evenator/masters/README

The contents of this repository are the intellectual property of Edward Venator
and Case Western Reserve University, except where prohibited by preexisting
licenses. You are not permitted to copy, publish, mirror, or create derivatives
of this work.
