evenator/masters/Robot hardware.docx

1. Power Rails
  a. 24V batteries
  b. 12V DC
  c. 5V DC
  d. 220V AC
  e. PC power supply
2. Sensors
  a. Arm positions
  b. Wheel encoders (2 per)
  c. Kinect
  d. Sonars for reflexive halt?
  e. Sick LIDAR (?)
  f. ~~Hokuyo LIDAR (?)~~
  g. Gyro
  h. ~~Neato~~ ~~laser~~
  i. ~~GPS~~
3. Actuators
  a. Two wheels
  b. 6 DOF arm
  c. Gripper
4. Processing
  a. IRC5
  b. cRIO
  c. PC
5. COM/control
  a. E-stop
  b. Wifi bridge
  c. 360 Controller
  d. Warning Beacon Light
