evenator/masters/figures/robot overview.pdf

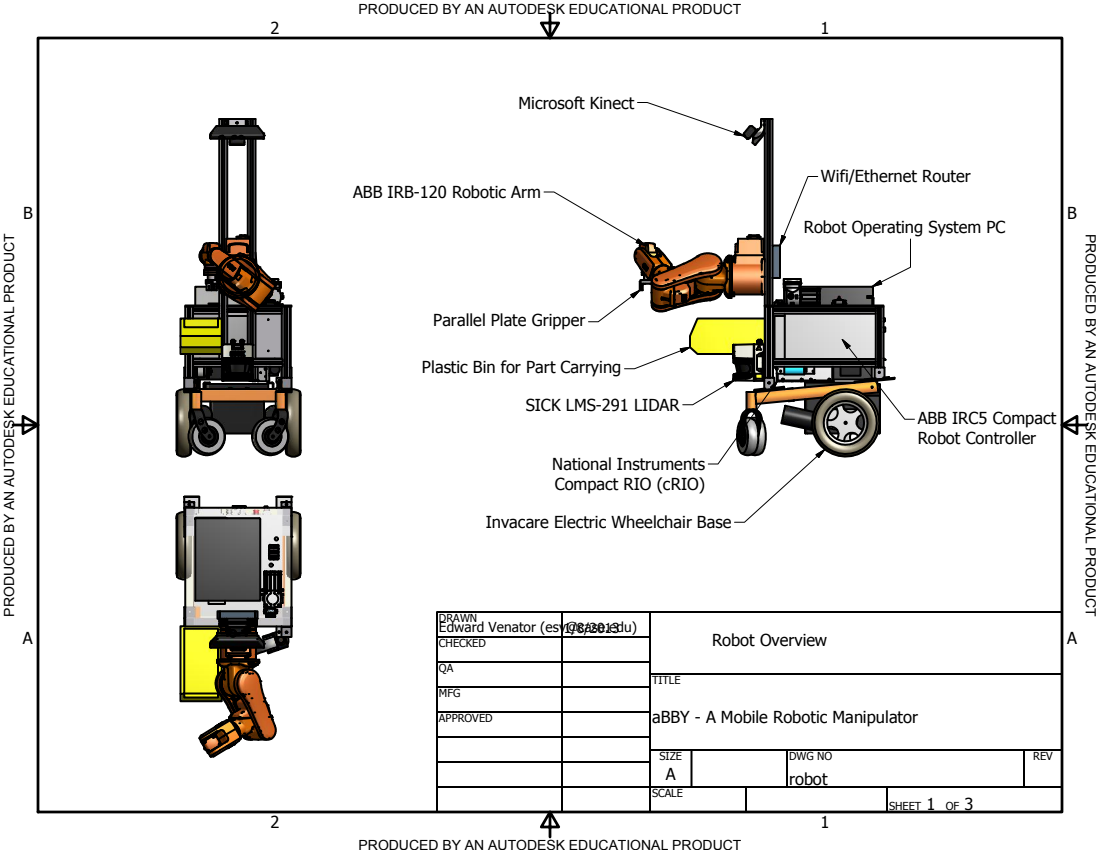
[picture p43: page 1]
TIO; ile; ula; mSI; Ele; elc; Pla; olle; allel Pla

PRODUCED BY AN AUTODESK EDUCATIONAL PRODUCT

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
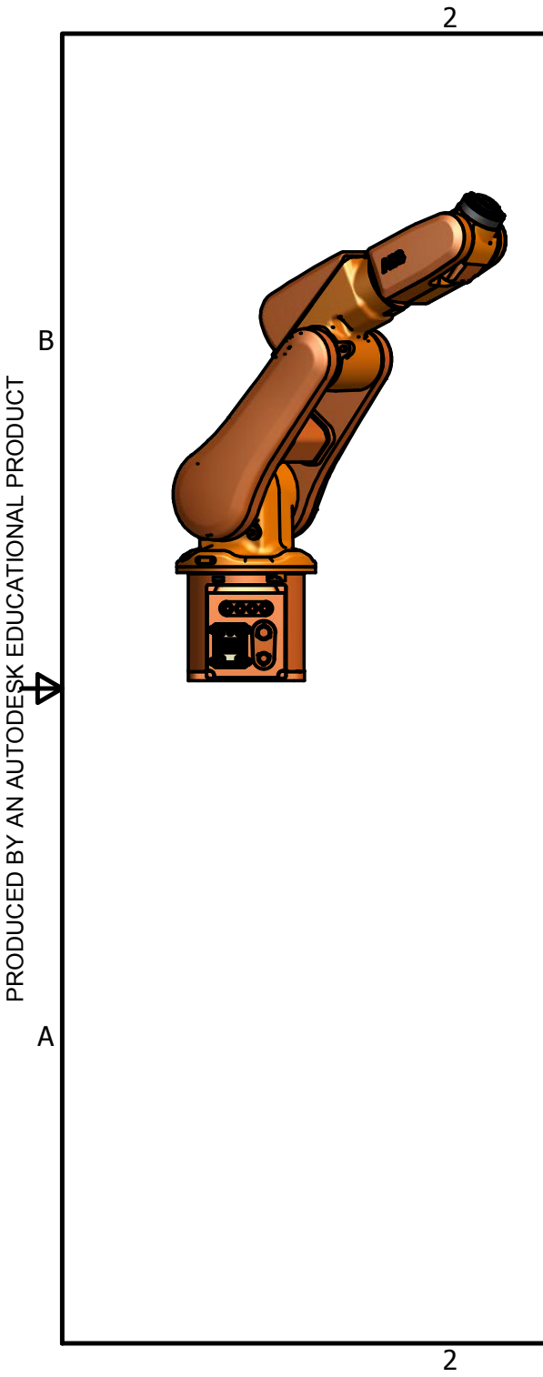
[picture p44: figure]

PRODUCED BY AN AUTODESK EDUCATIONAL PRODUCT

PRODUCED BY AN AUTODESK EDUCATIONAL PRODUCT

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
B IR

B

1

2

0 in

d

u

s

t

rial r

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
e IRB-120 is a six-axisrobotic armwith a spherical wrist. It has a tool flange that allowsfor the mounting of end effectors as well as pneumatic and elec

t

ric

al connections near the tool flange to connectsensors and actuatorsto the arm. Th
e IRB-120 is ABB'ssmallest robotic arm, with a 580 mmreach and a payload capacity of 3 kg. The armitself weighs 25 kg andmust be mounted to the extreme front of the robot, whichmeansits weight exerts a large moment on the robot. This was a serious consideration in the placement of the robot's center of mass. It can be mounted at any angle, and on thisrobot is mounted 90 (with the base mounted to a verticalsurface). The decision to mountthe armvertically on the front of the robot wasso that the majority of the arm's work envelope would be outside of the volume of the robot. This maximizesthe functional work envelope of the armand minimizesthe possibility of the armcolliding with other parts of the robot. The IRB-120'sjoints are powered by non-back-drivable AC electric servos, with positio

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
e IR

B

1

2

0 is

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
sitio

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
sitio

n is

c

o

n

t

r

olle

d

b

y

a

n

A

B

B IR

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
olle

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
S In

d

u

s

t

rial in

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
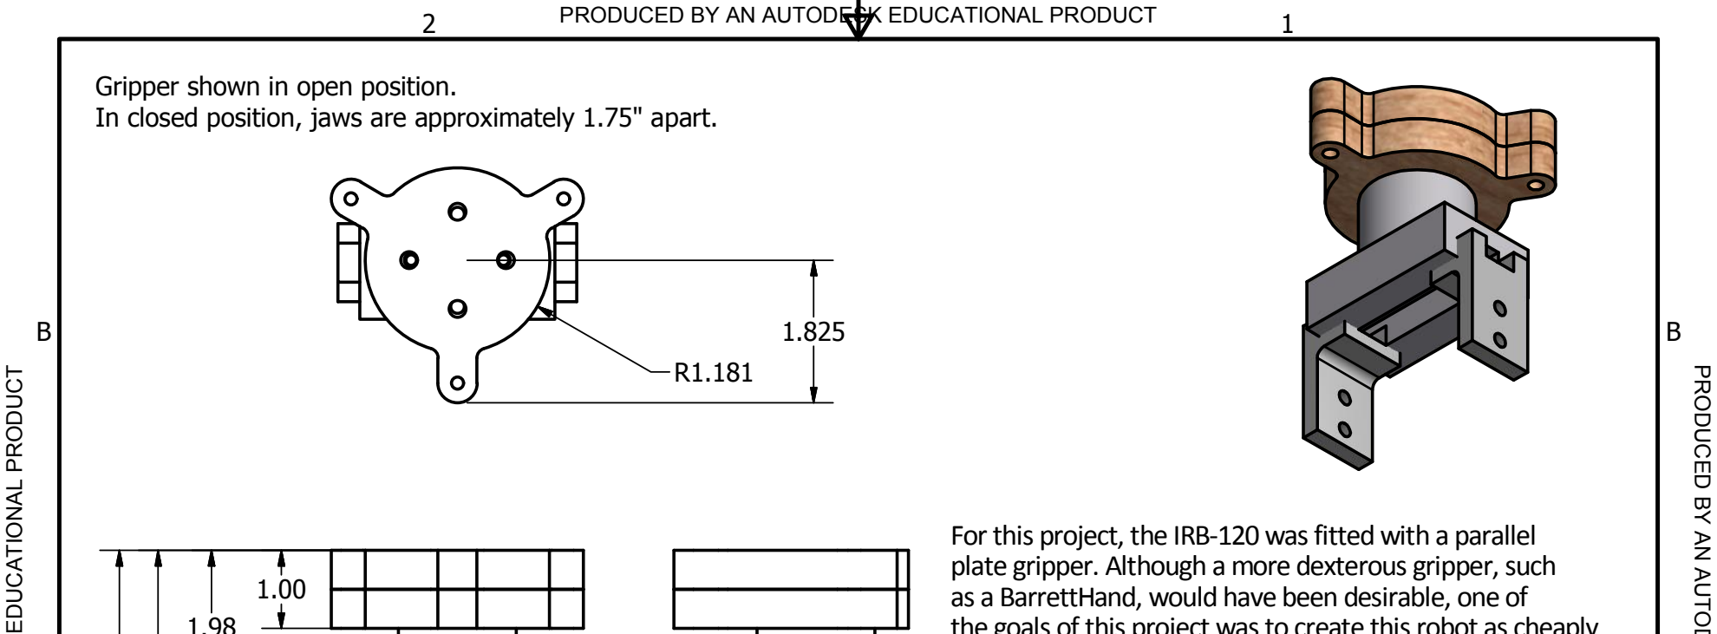
[picture p45: figure]
TIO; Gripper shown in open position.
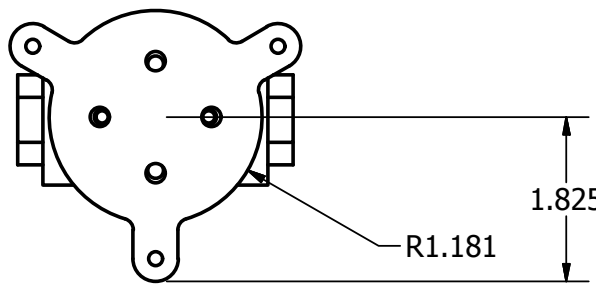
[picture p46: figure]
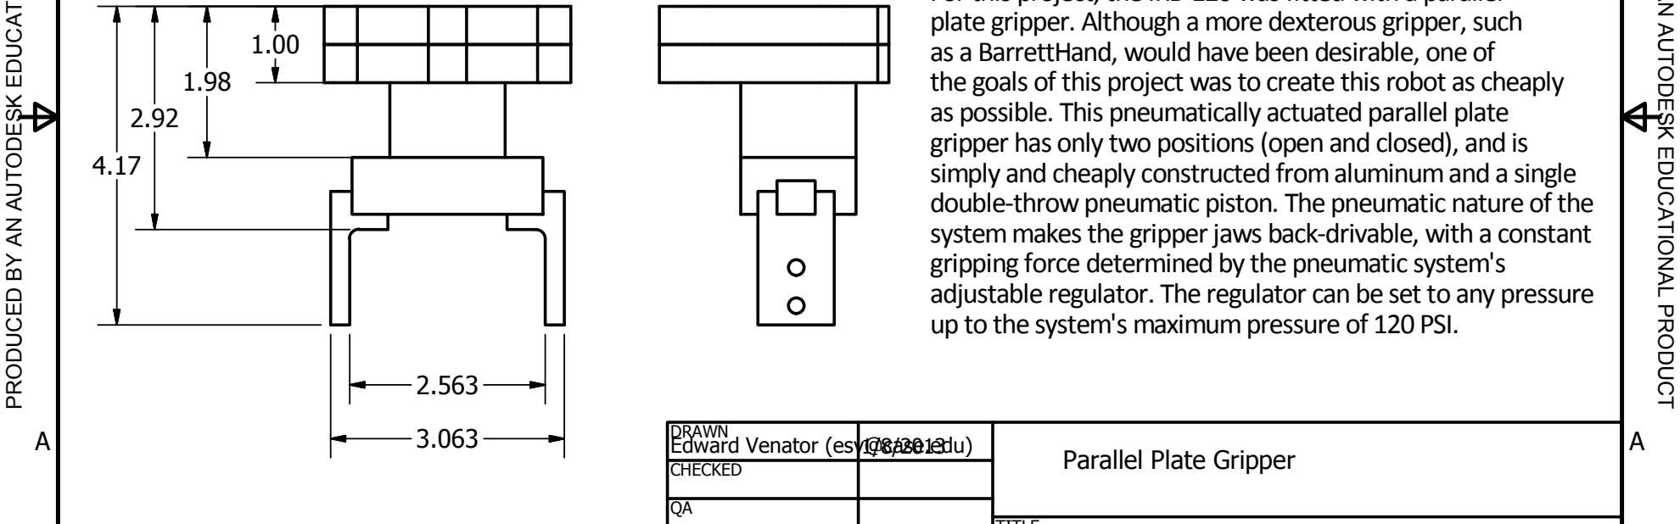
[picture p47: figure]
D E S K E D U C A TIO; DRAWN Edward Venator (esv@case.edu); CHECKED; Parallel Plate Gripper

PRODUCED BY AN AUTODESK EDUCATIONAL PRODUCT

PRODUCED BY AN AUTODESK EDUCATIONAL PRODUCT

MFG

APPROVED

TITLE

aBBY - A Mobile Robotic Manipulator

SIZE

SCALE

DWG NO
robot

REV

SHEET 3 OF 3

For this project, the IRB-120 wasfitted with a parallel plate gripper. Although a more dexterous gripper,such as a BarrettHand, would have been desirable, one of
the goals of this project wasto create thisrobot as cheaply as possible. This pneumatically actuated parallel plate gripper has only two positions(open and closed), and is simply and cheaply constructed fromaluminumand a single double-throwpneumatic piston. The pneumatic nature of the systemmakesthe gripperjaws back-drivable, with a constant gripping force determined by the pneumatic system's adjustable regulator. The regulator can be set to any pressure up to the system's maximumpressure of 120 PSI.

Dimensions in inches

In closed position, jaws are approximately 1.75" apart.
