evenator/masters/thesis/figures/abby-diagram-eps-converted-to.pdf

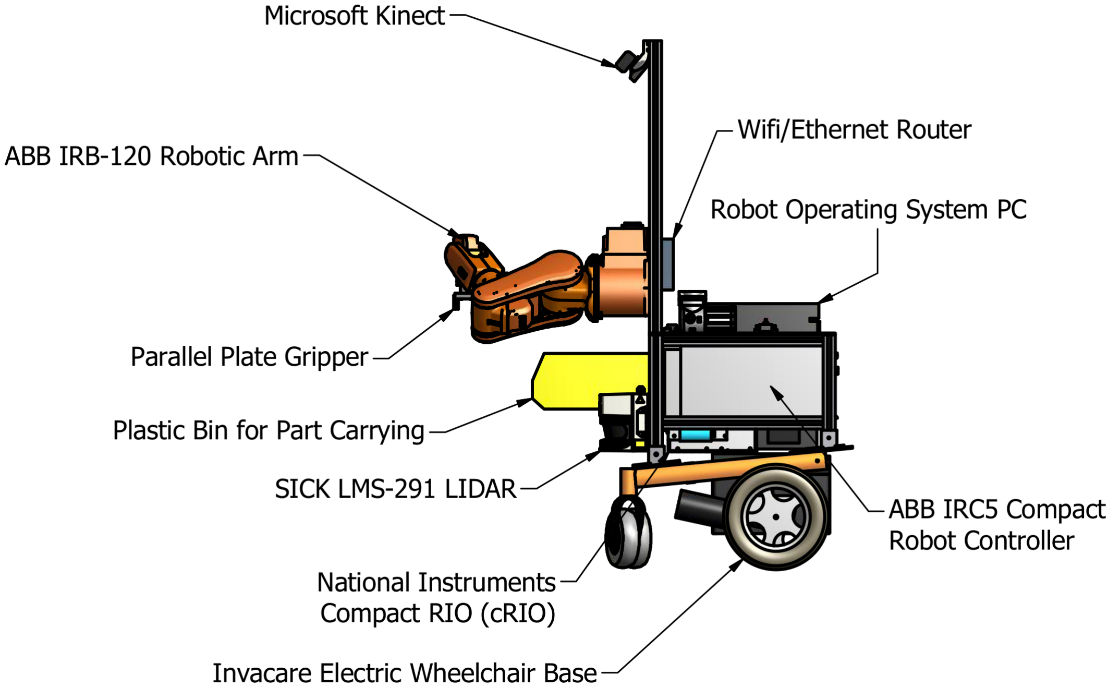
[picture p54: page 1]
