evenator/masters/Electronics/cRIO Breakout/breakout.png

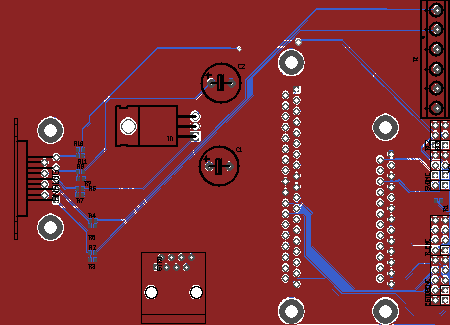
Electronics/cRIO Breakout/breakout.png
