evenator/masters/figures/13.8v Rail Dropout On Compressor Turn-on (Inductive Filter).JPG

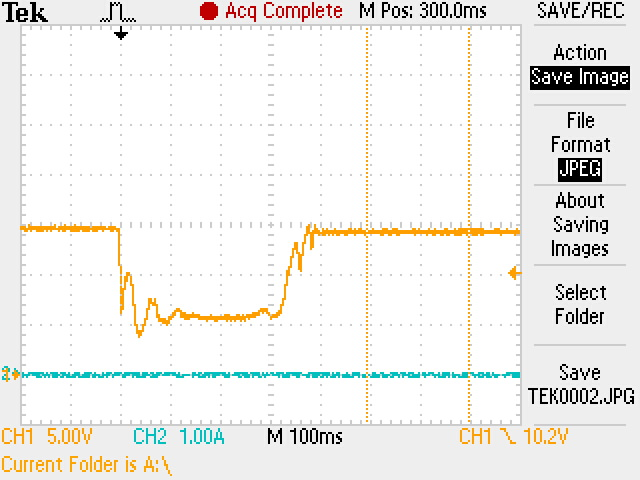
figures/13.8v Rail Dropout On Compressor Turn-on (Inductive Filter).JPG
