evenator/masters/figures/2012-12-06-175029_webcam.jpg

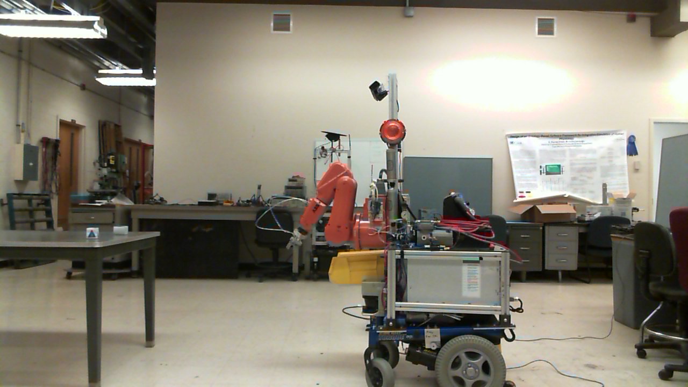
figures/2012-12-06-175029_webcam.jpg
