evenator/masters/figures/2012-12-06-175038_rviz.png

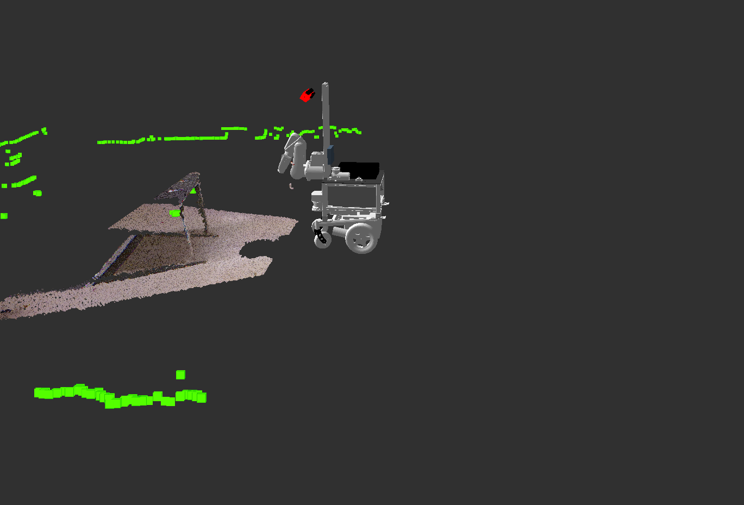
figures/2012-12-06-175038_rviz.png
