evenator/masters/figures/abby.png

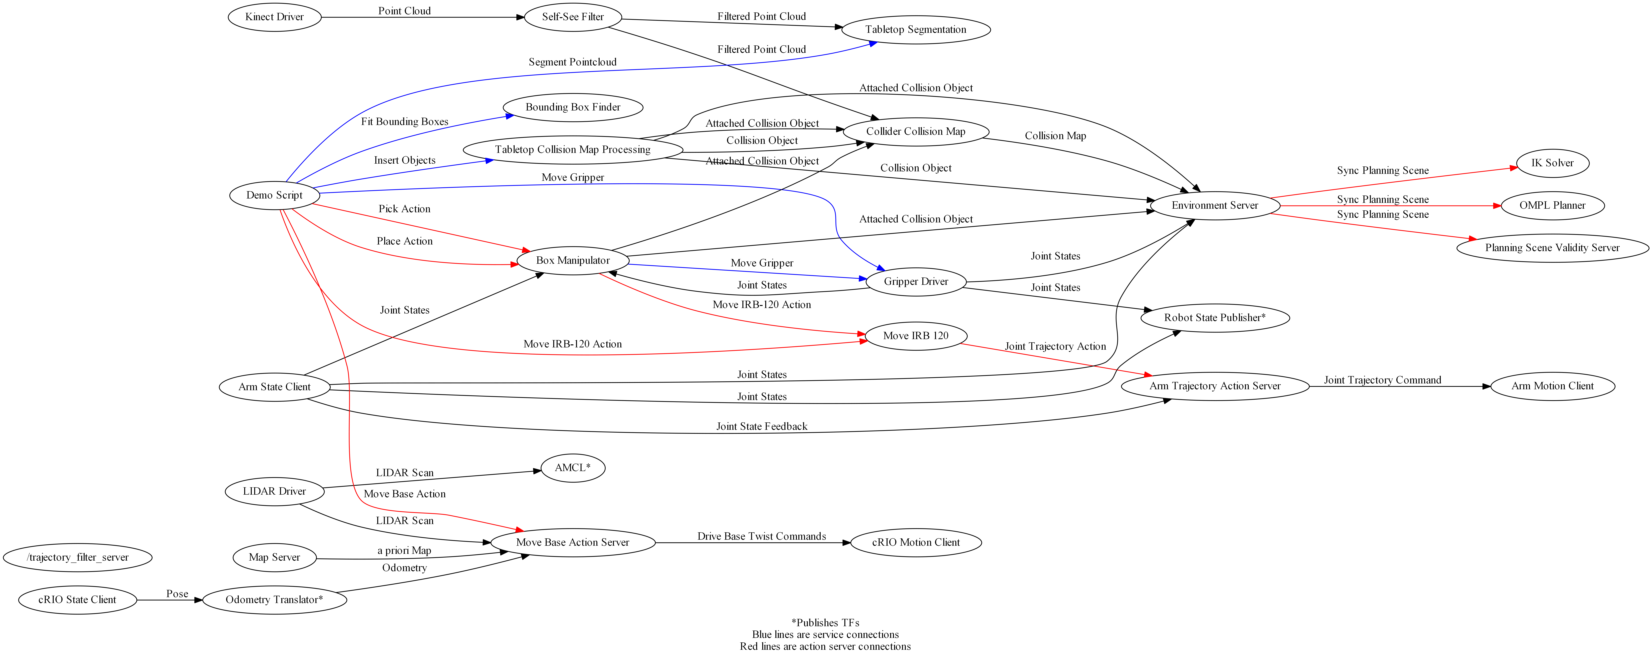
figures/abby.png
