evenator/masters/figures/data_connections.png

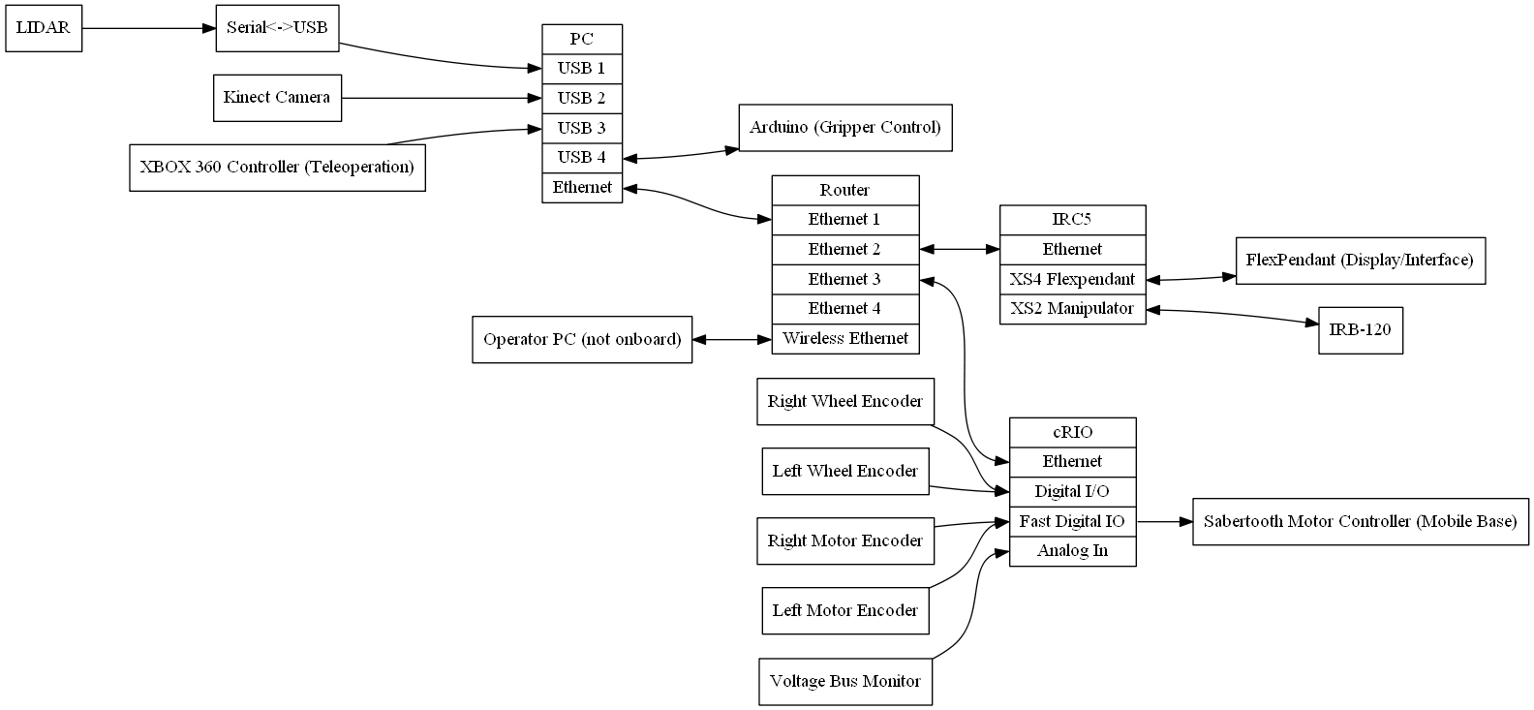
figures/data_connections.png
