evenator/masters/figures/data_connections_simple.png

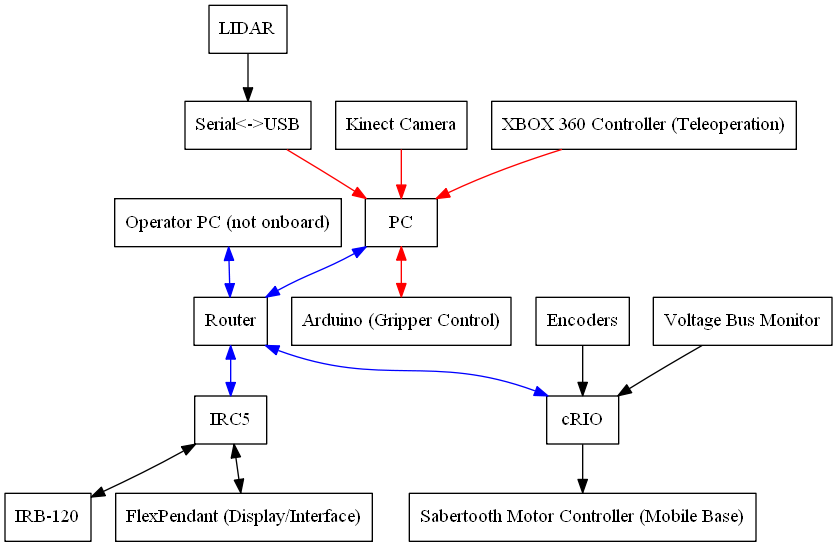
figures/data_connections_simple.png
