evenator/masters/figures/demo task map.png

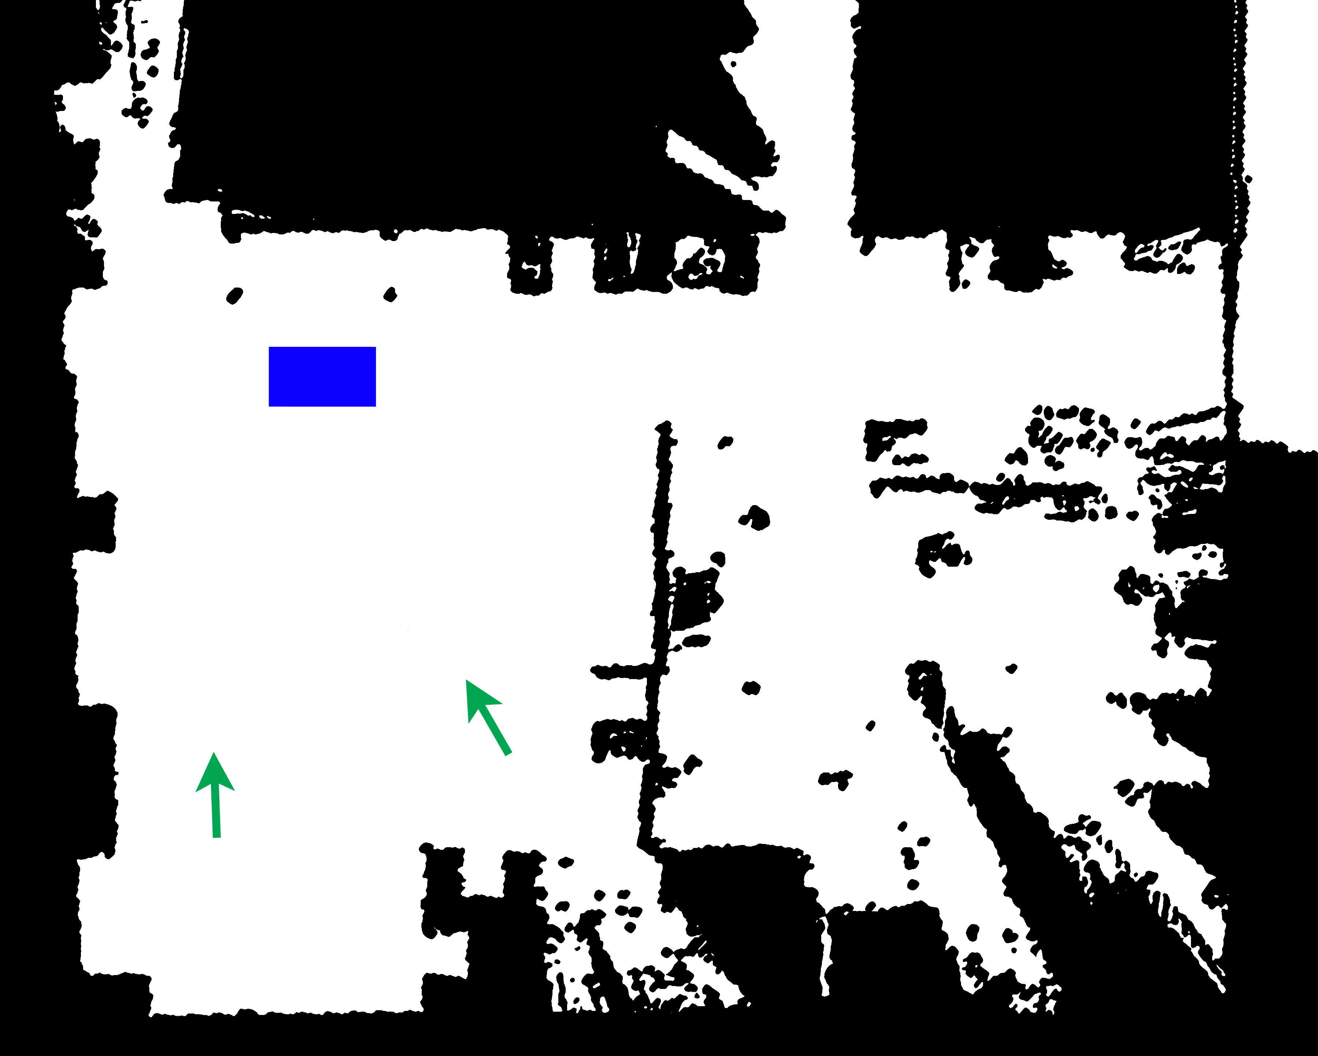
figures/demo task map.png
