evenator/masters/figures/goals slide pic.jpg

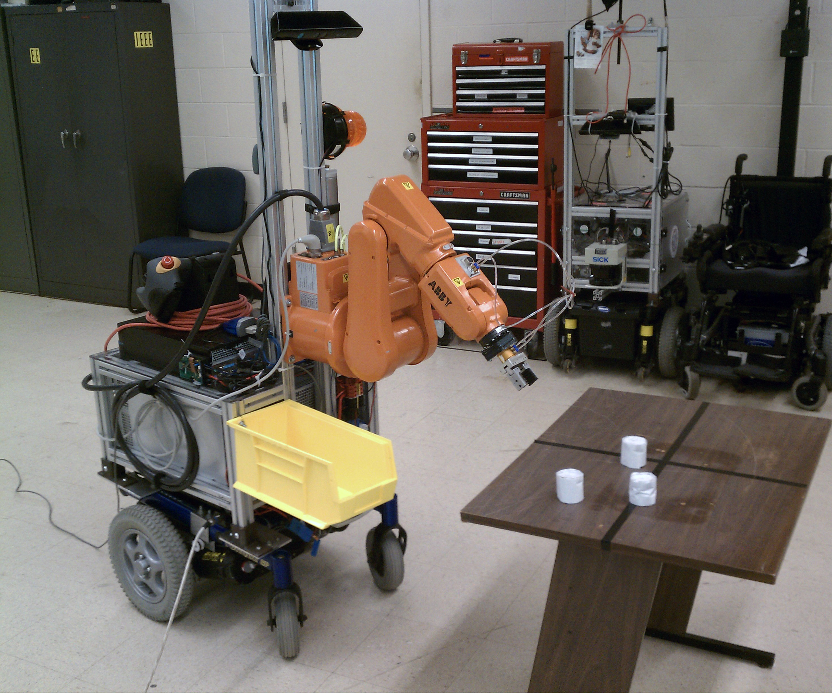
figures/goals slide pic.jpg
