evenator/masters/figures/IMG_20121110_164241.jpg

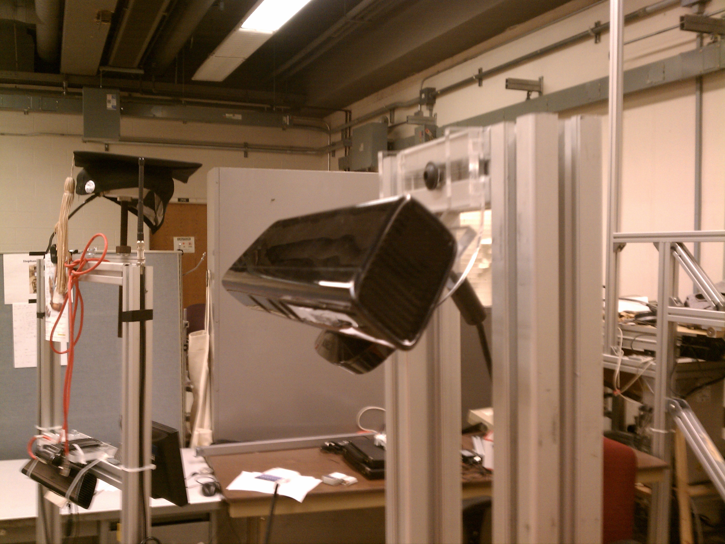
figures/IMG_20121110_164241.jpg
