evenator/masters/figures/IMG_20121110_164247.jpg

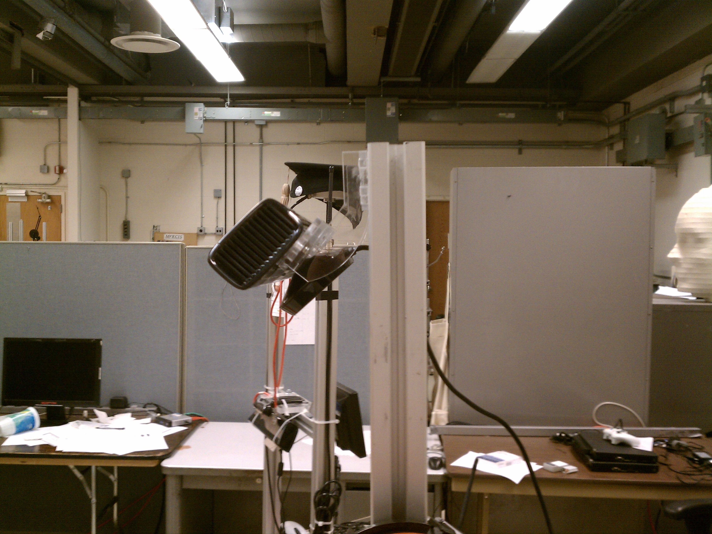
figures/IMG_20121110_164247.jpg
