evenator/masters/figures/IMG_20121110_164253.jpg

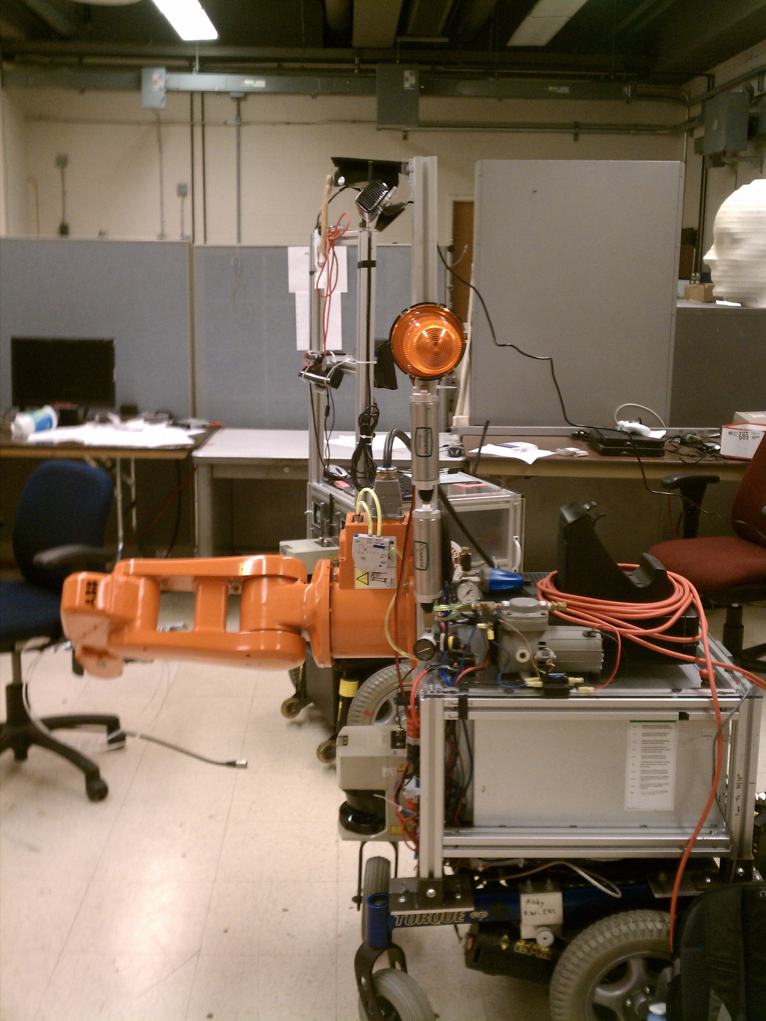
figures/IMG_20121110_164253.jpg
