evenator/masters/figures/IMG_20121110_164259.jpg

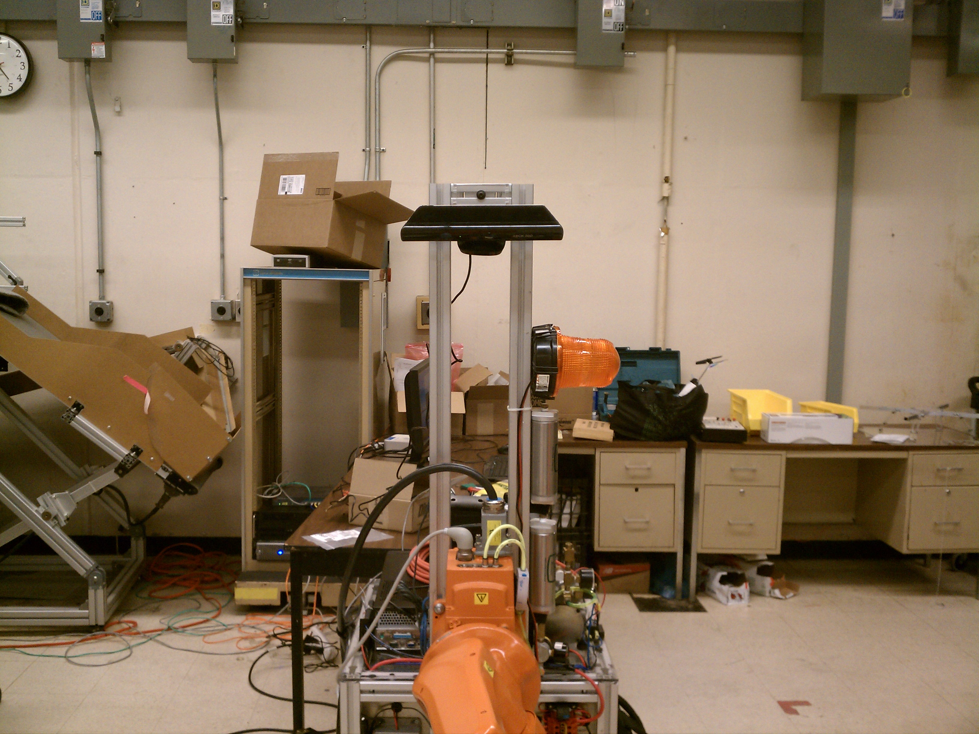
figures/IMG_20121110_164259.jpg
