evenator/masters/figures/IMG_20121119_132048.jpg

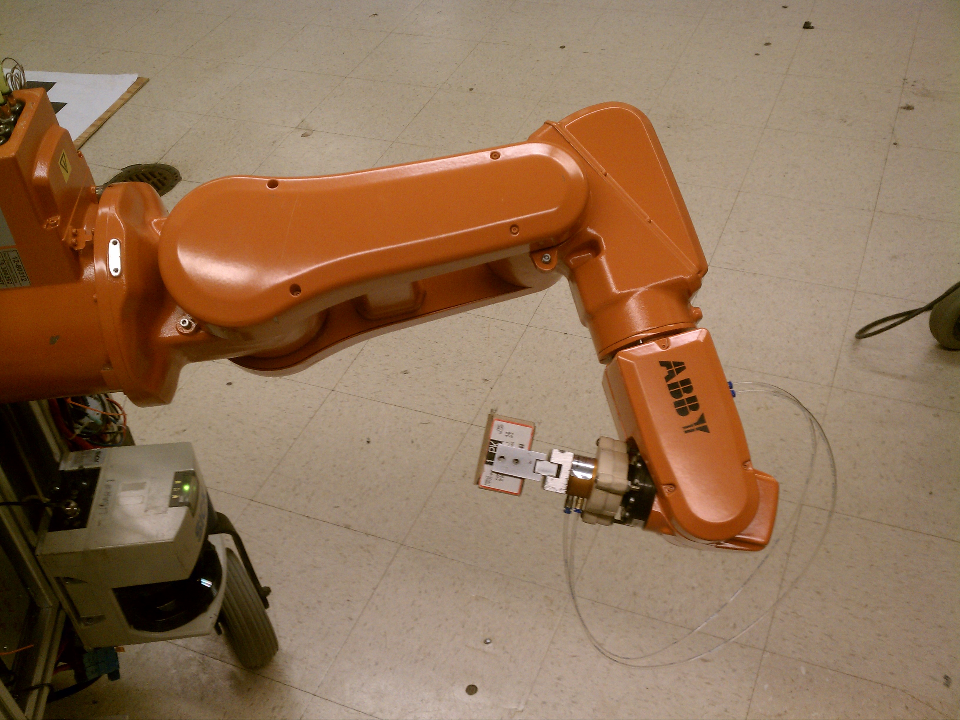
figures/IMG_20121119_132048.jpg
