evenator/masters/figures/IMG_20121119_132052.jpg

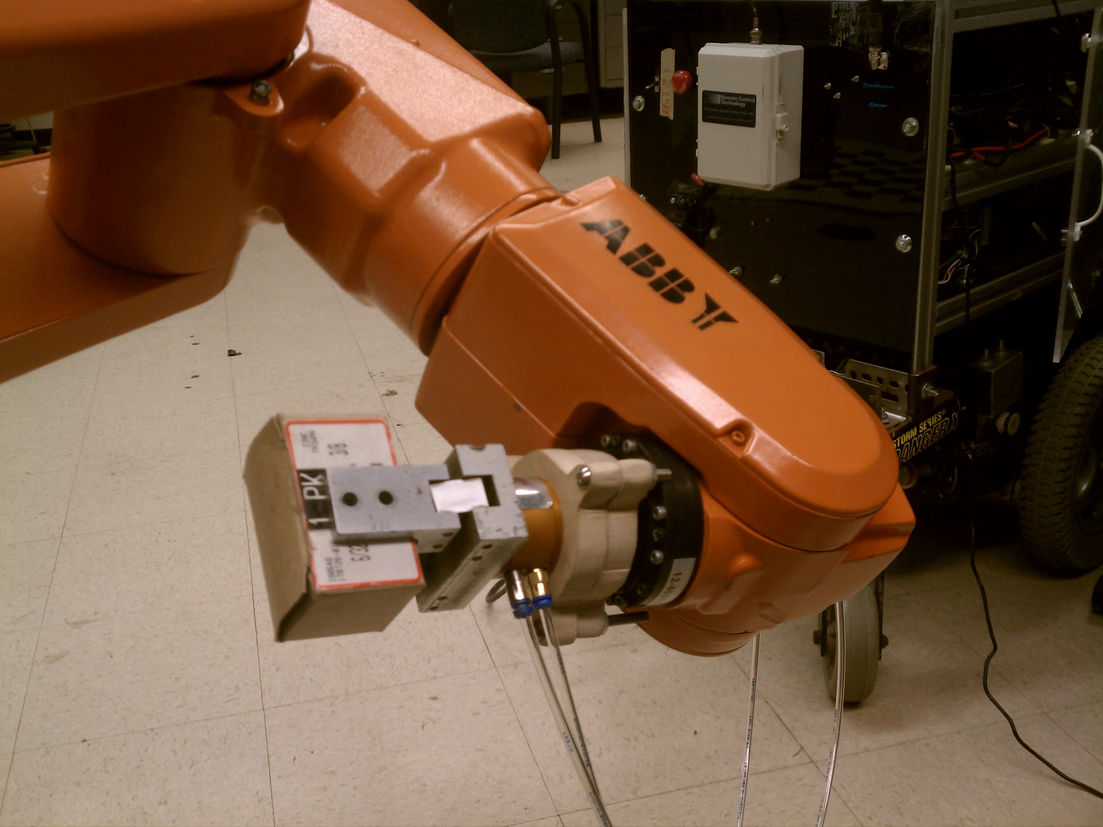
figures/IMG_20121119_132052.jpg
