evenator/masters/figures/IMG_20121119_132947.jpg

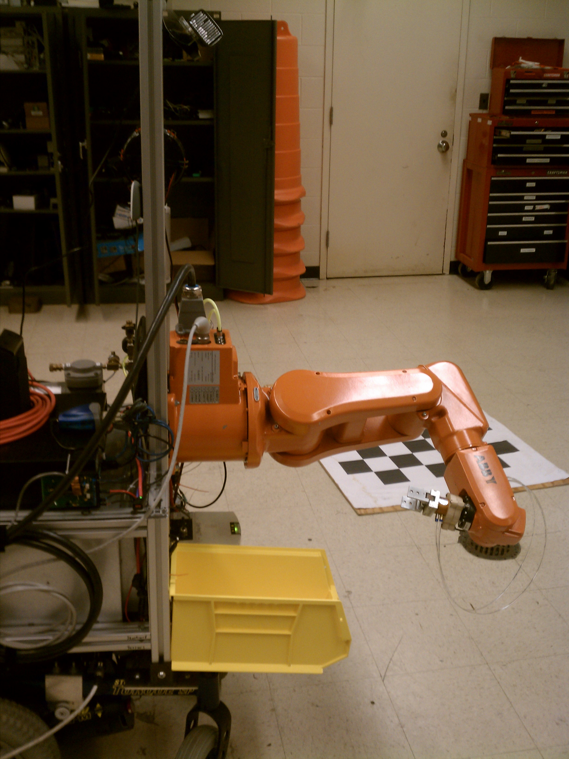
figures/IMG_20121119_132947.jpg
