evenator/masters/figures/IMG_20121119_132950.jpg

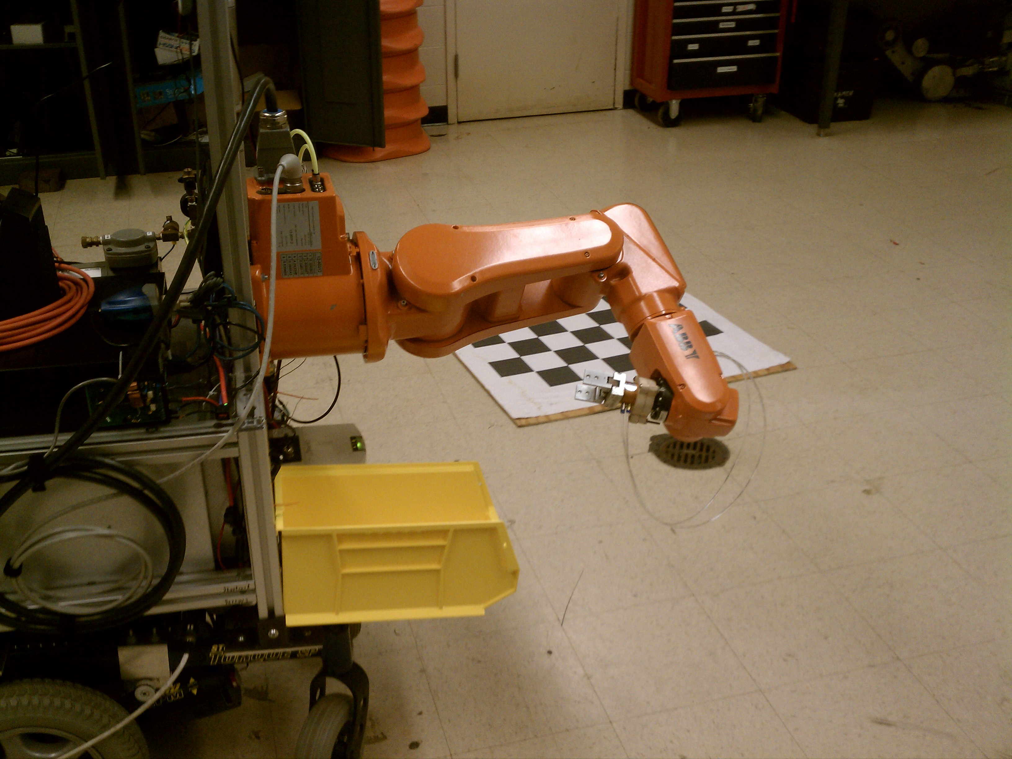
figures/IMG_20121119_132950.jpg
