evenator/masters/figures/IMG_20121206_152852.jpg

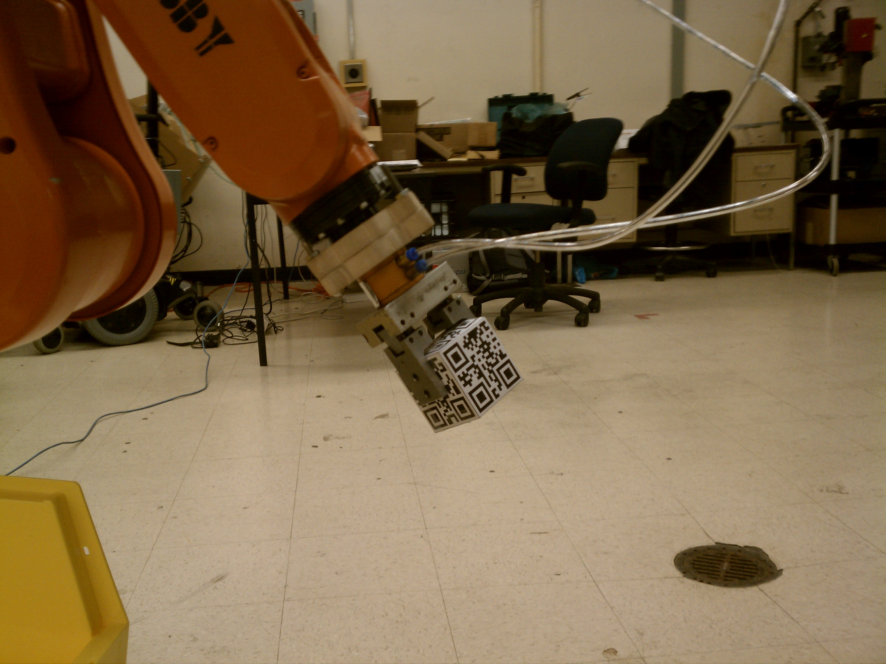
figures/IMG_20121206_152852.jpg
