evenator/masters/figures/IMG_20121206_152901.jpg

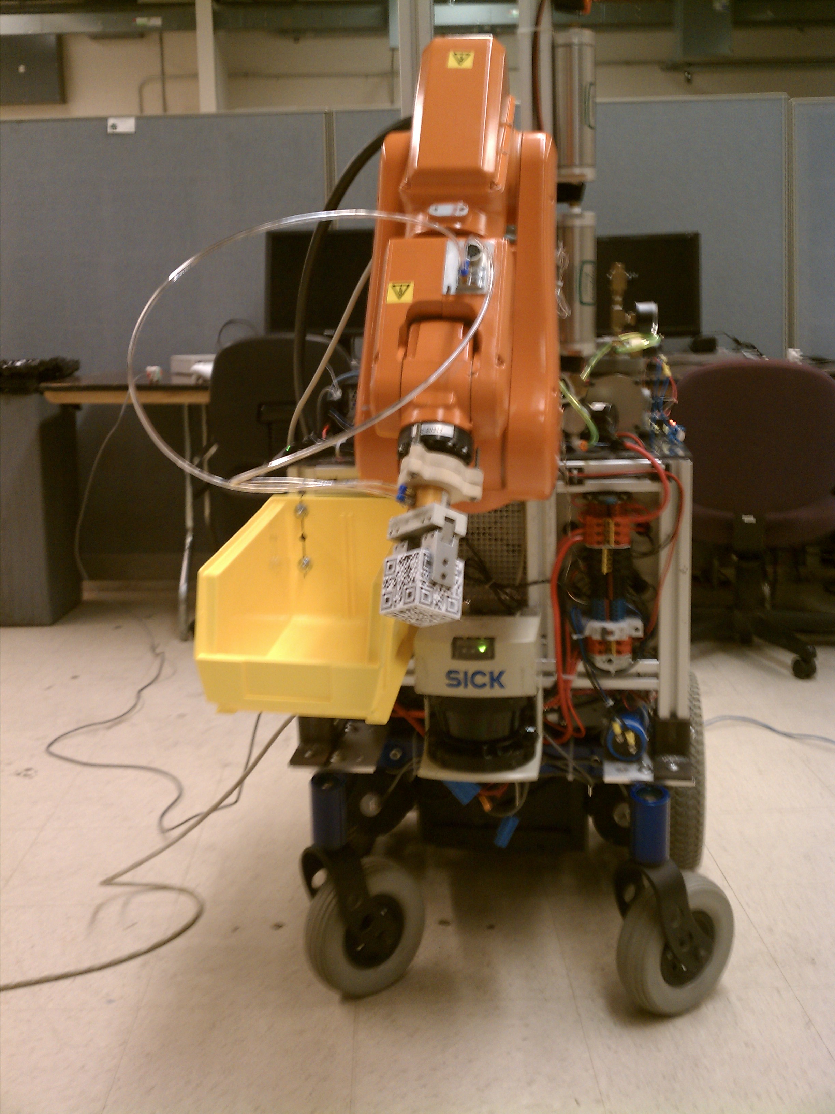
figures/IMG_20121206_152901.jpg
