evenator/masters/figures/IMG_20121206_180125.jpg

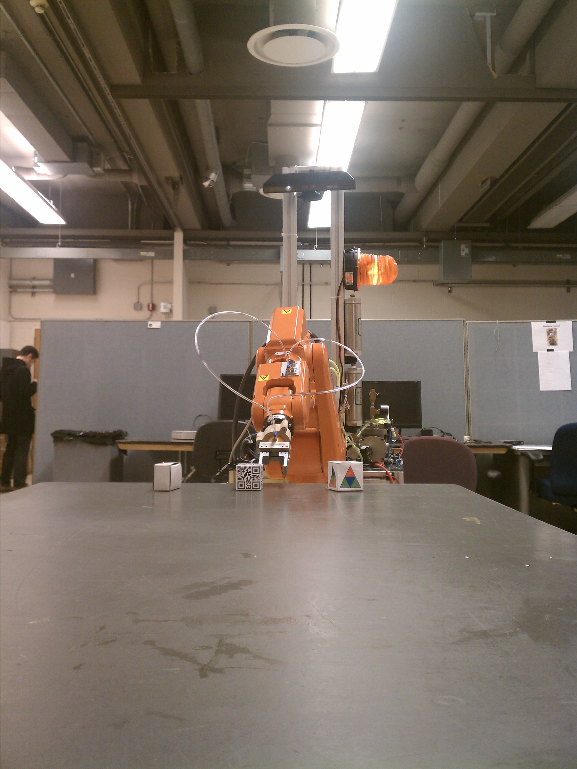
figures/IMG_20121206_180125.jpg
