evenator/masters/figures/IMG_20121206_180145.jpg

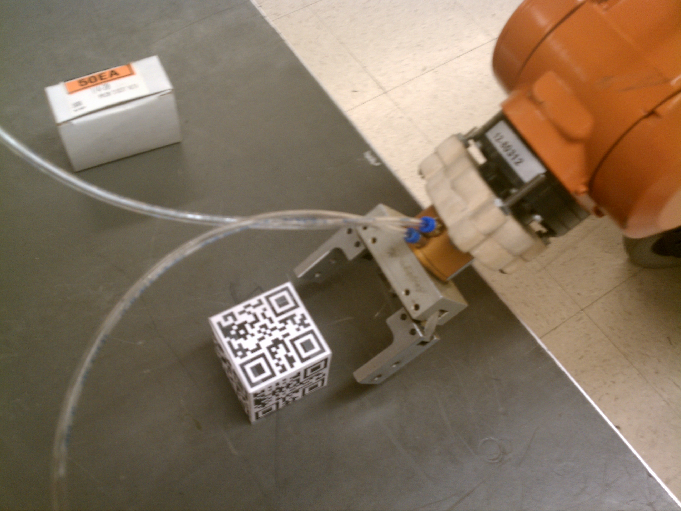
figures/IMG_20121206_180145.jpg
