evenator/masters/figures/IMG_20121206_180151.jpg

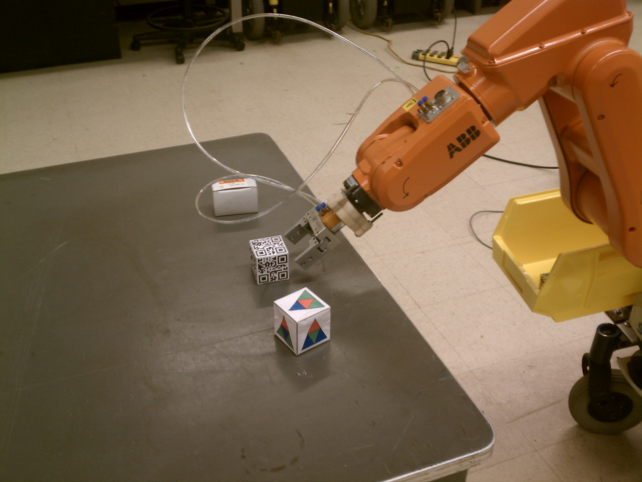
figures/IMG_20121206_180151.jpg
