evenator/masters/figures/IMG_20121206_180155.jpg

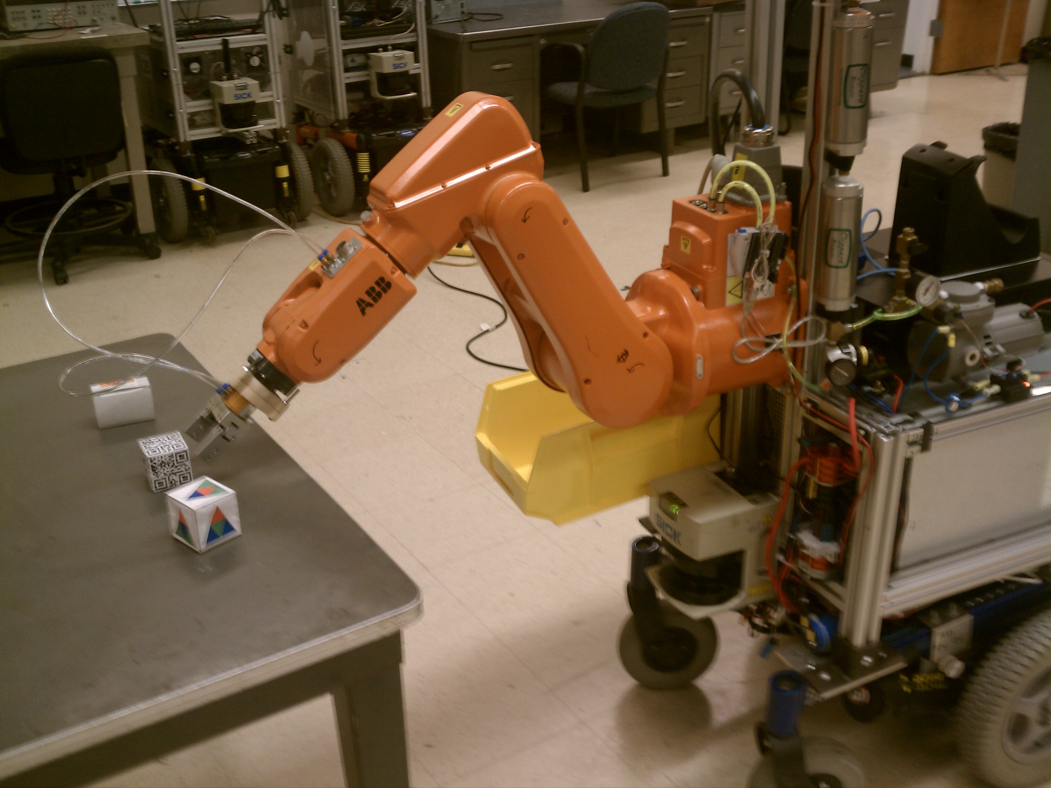
figures/IMG_20121206_180155.jpg
