evenator/masters/figures/IMG_20121206_180201.jpg

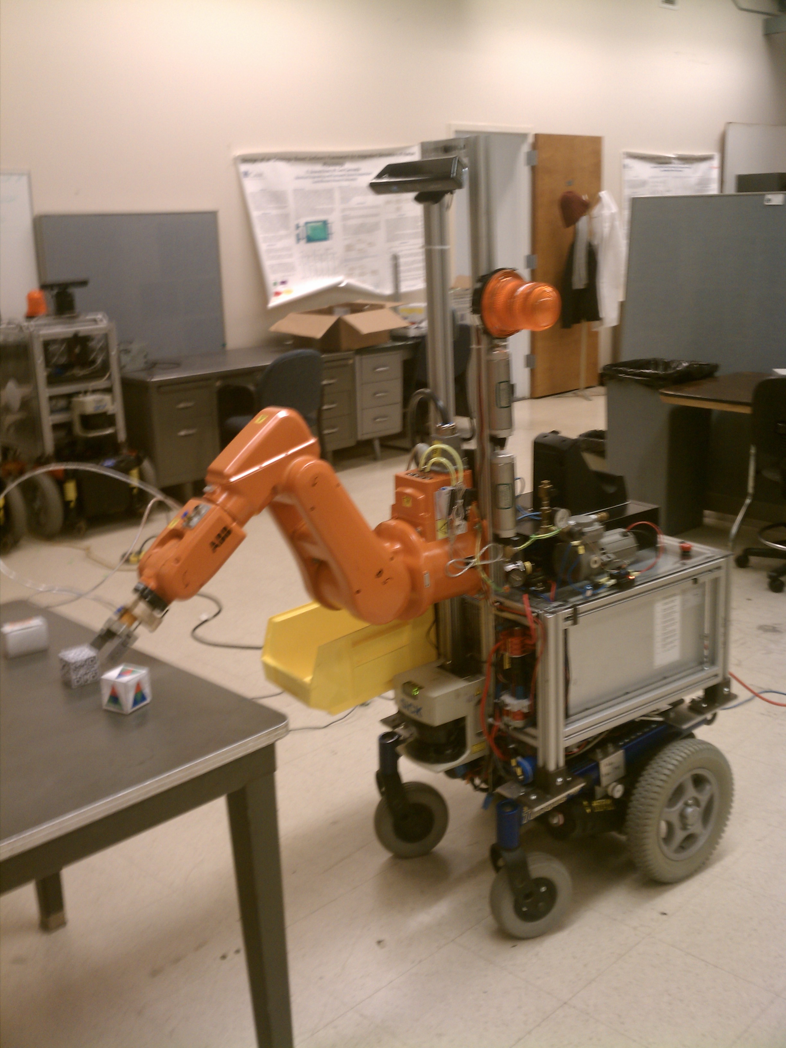
figures/IMG_20121206_180201.jpg
