evenator/masters/figures/IMG_20121206_181429.jpg

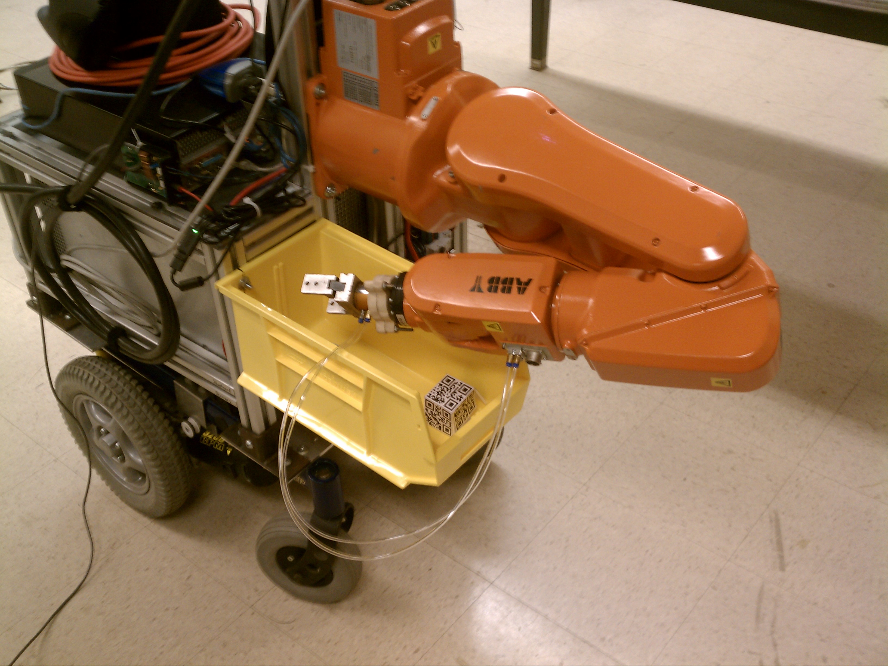
figures/IMG_20121206_181429.jpg
