evenator/masters/figures/IMG_20121206_181437.jpg

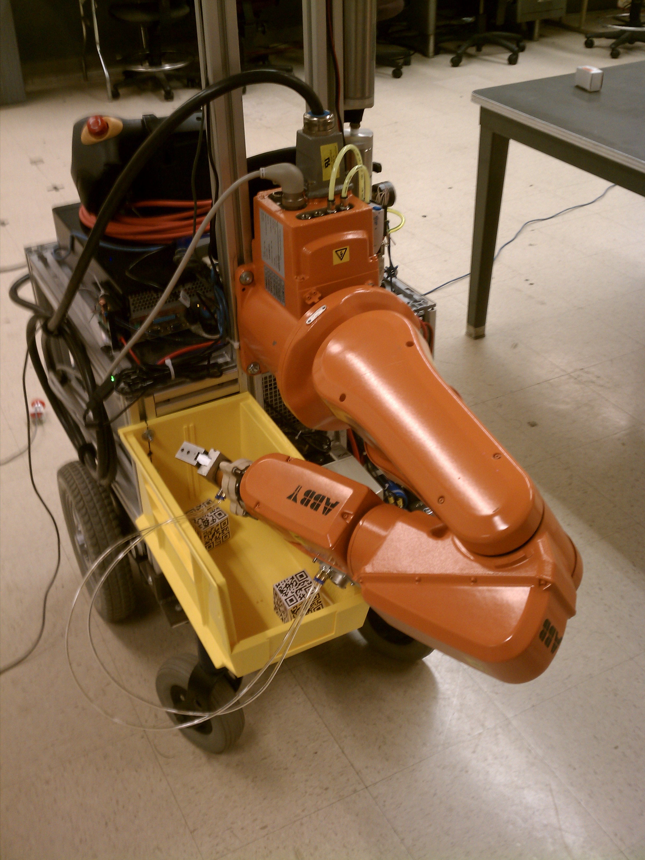
figures/IMG_20121206_181437.jpg
