evenator/masters/figures/IMG_20121206_181445.jpg

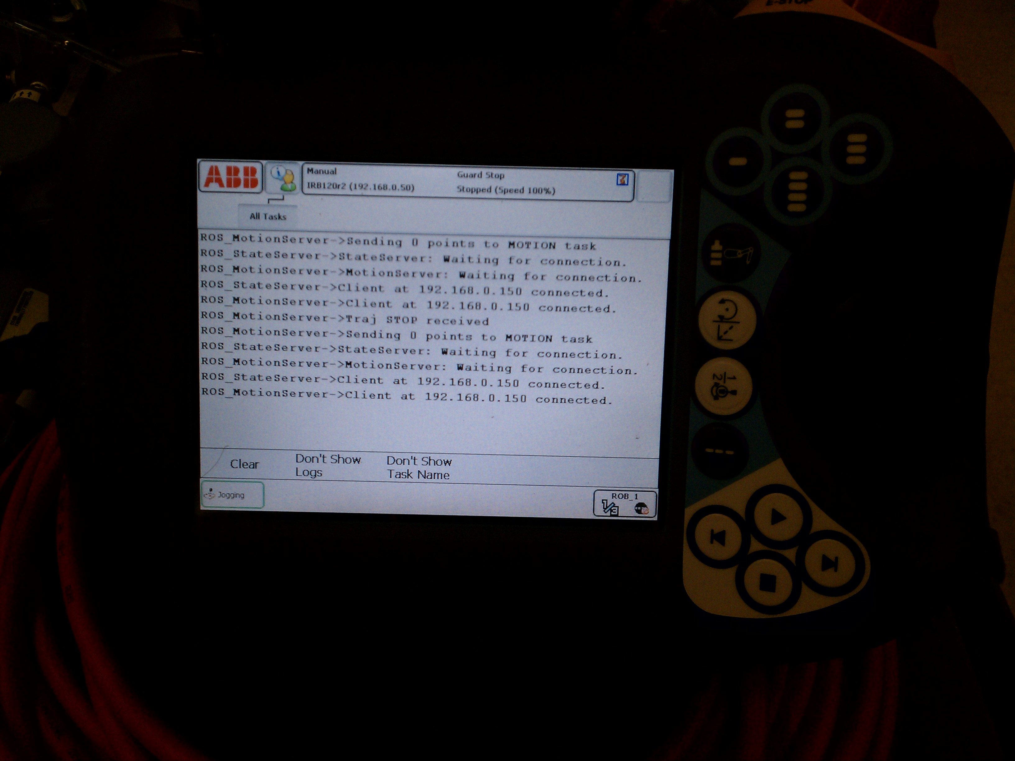
figures/IMG_20121206_181445.jpg
