evenator/masters/figures/IMG_20121206_181455.jpg

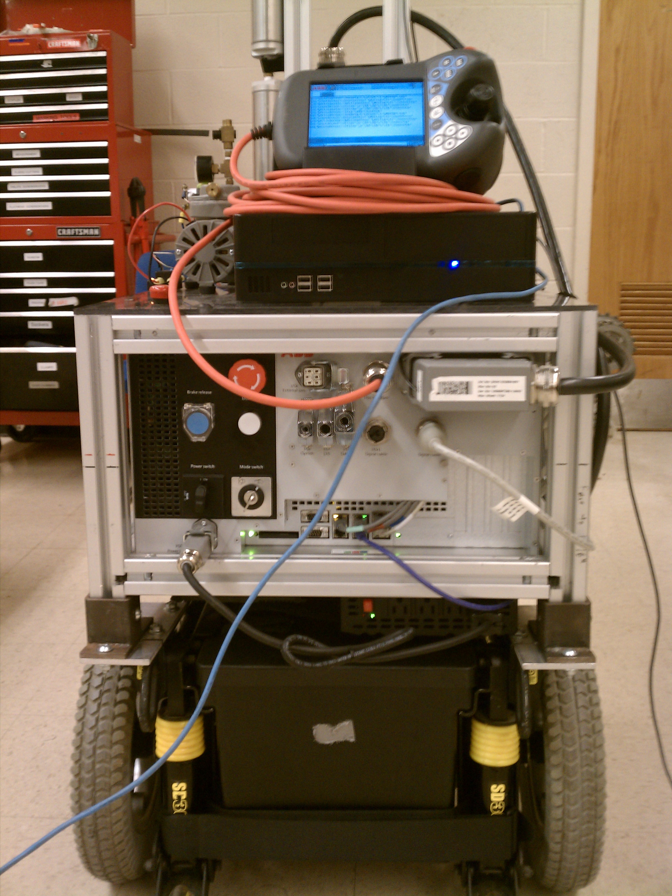
figures/IMG_20121206_181455.jpg
