evenator/masters/figures/IMG_20121206_181510.jpg

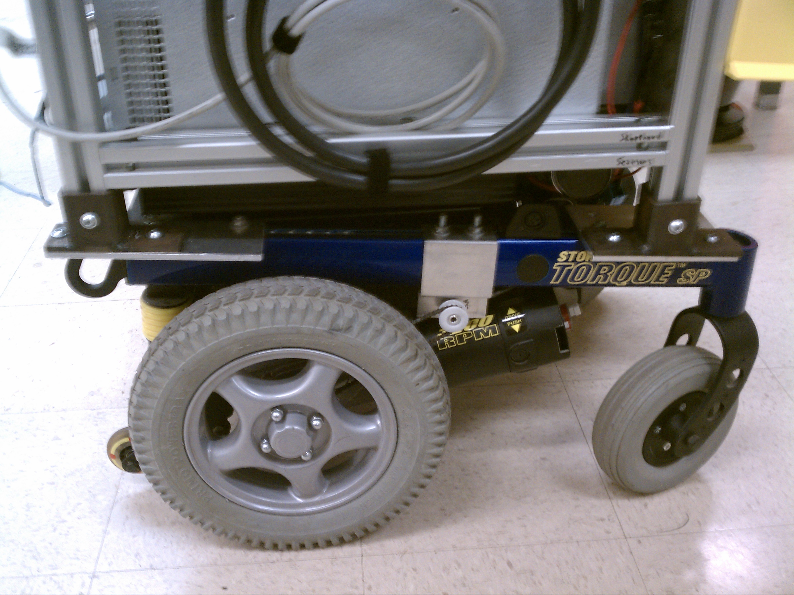
figures/IMG_20121206_181510.jpg
