evenator/masters/figures/IMG_20121206_181521.jpg

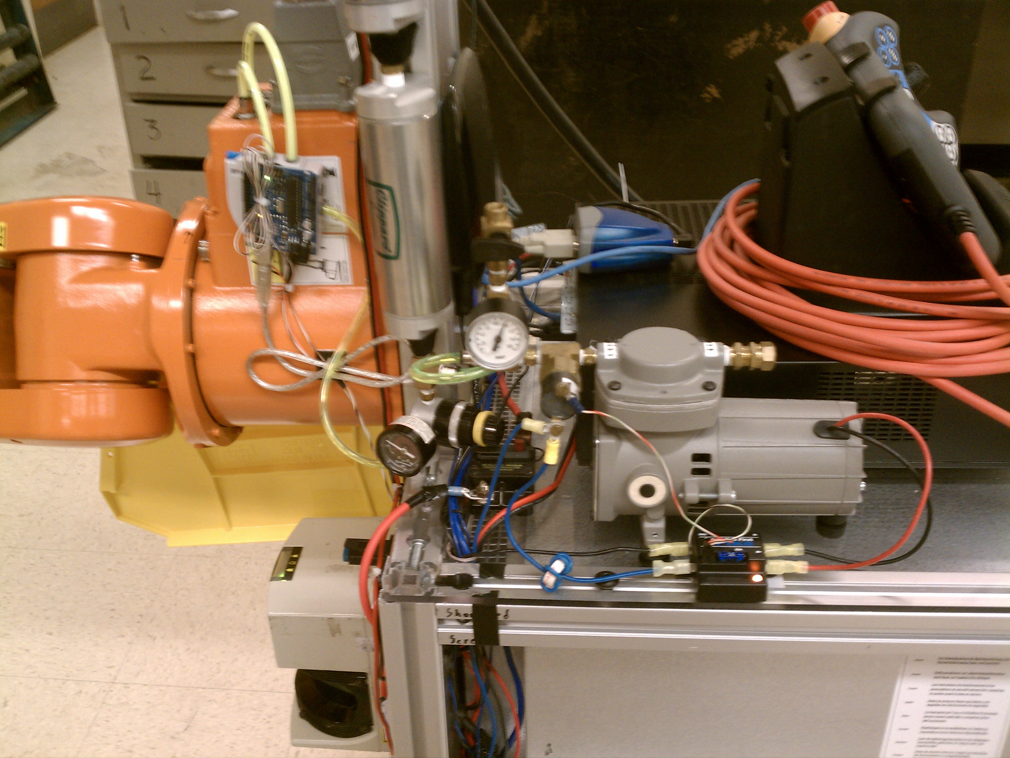
figures/IMG_20121206_181521.jpg
