evenator/masters/figures/IMG_20121206_181536.jpg

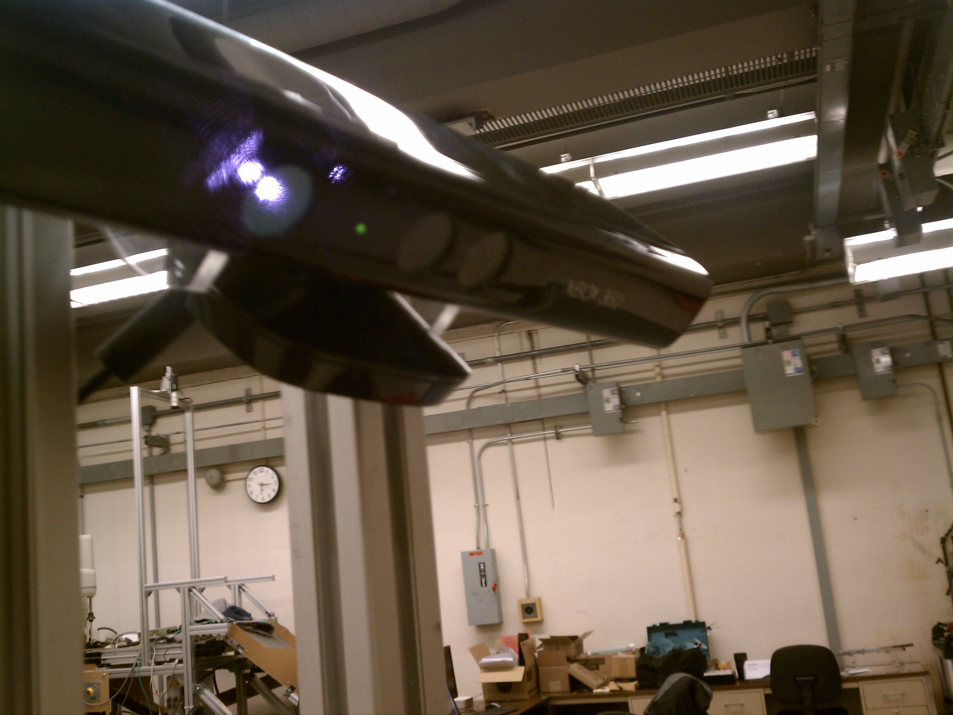
figures/IMG_20121206_181536.jpg
