evenator/masters/figures/IMG_20121206_181546.jpg

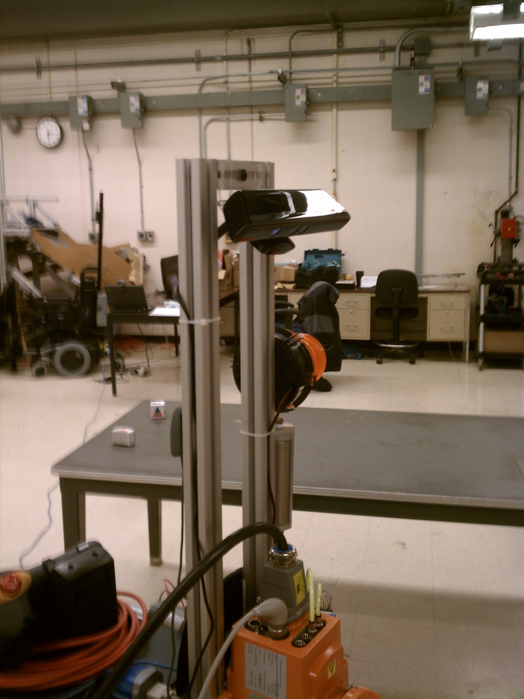
figures/IMG_20121206_181546.jpg
