evenator/masters/figures/IMG_20121206_181557.jpg

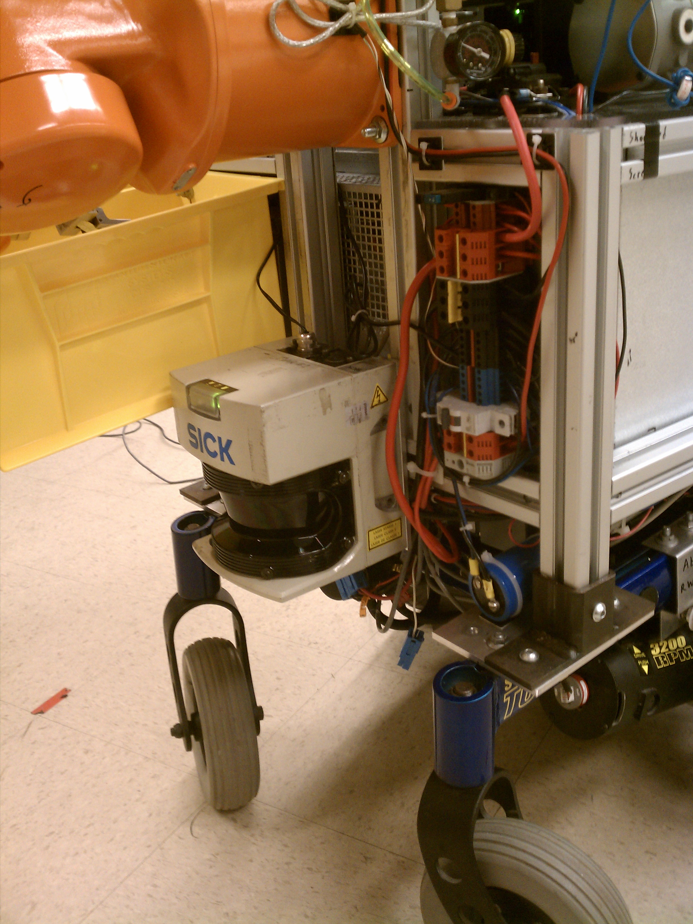
figures/IMG_20121206_181557.jpg
