evenator/masters/figures/IMG_20121206_181619.jpg

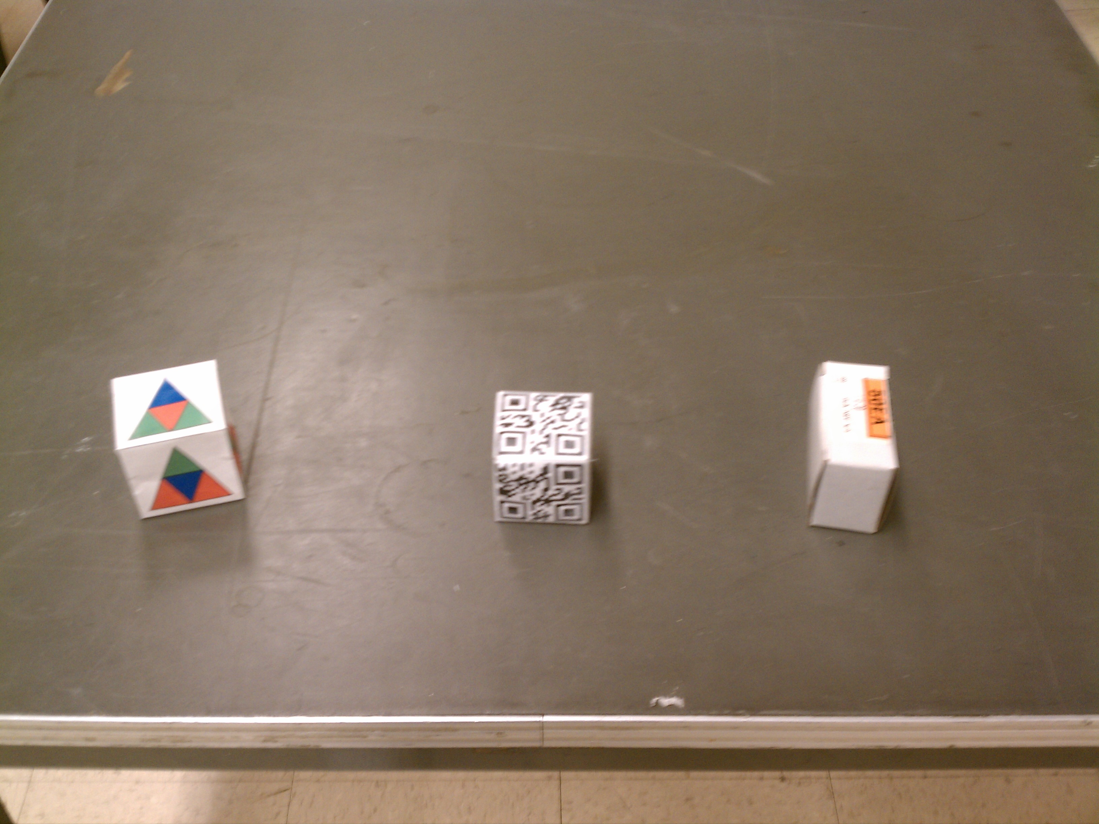
figures/IMG_20121206_181619.jpg
