evenator/masters/figures/IMG_20121206_181625.jpg

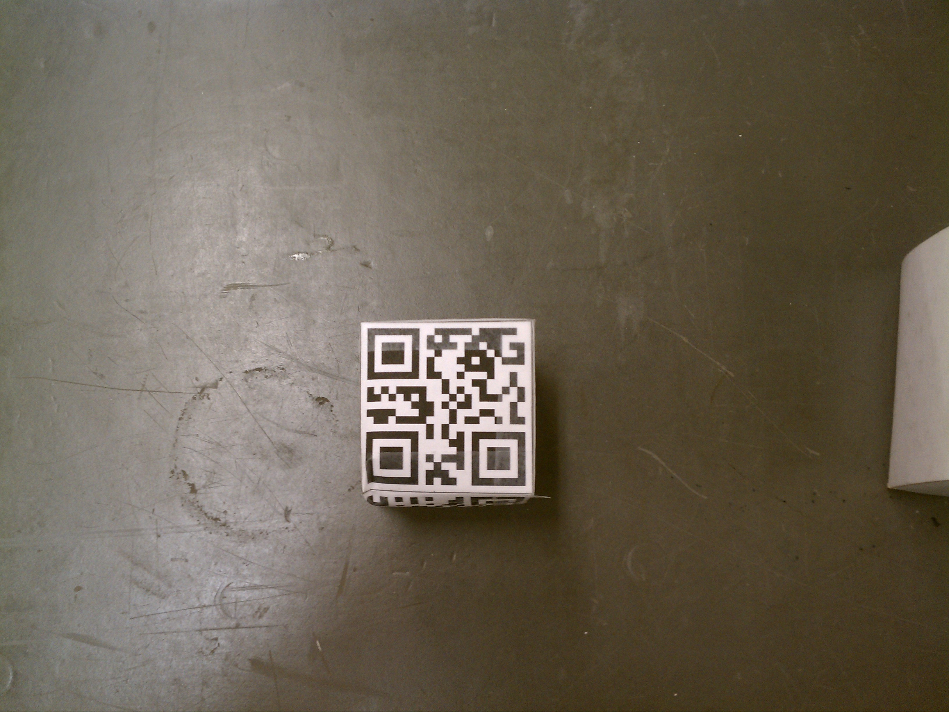
figures/IMG_20121206_181625.jpg
