evenator/masters/figures/IMG_20121206_181629.jpg

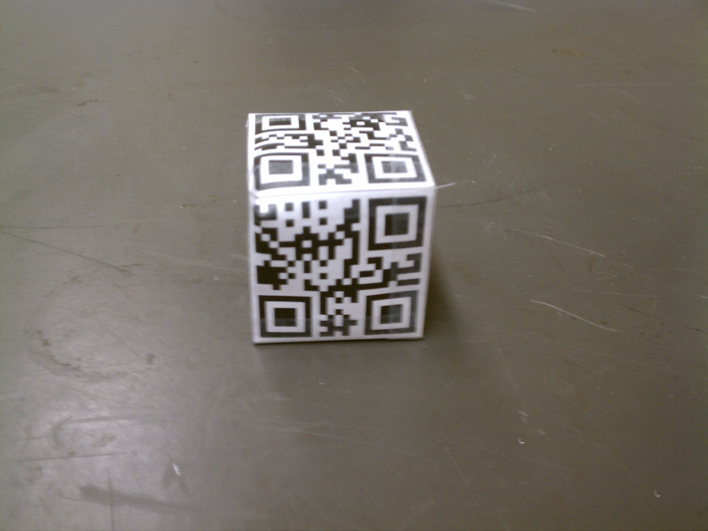
figures/IMG_20121206_181629.jpg
