evenator/masters/figures/IMG_20121206_181728.jpg

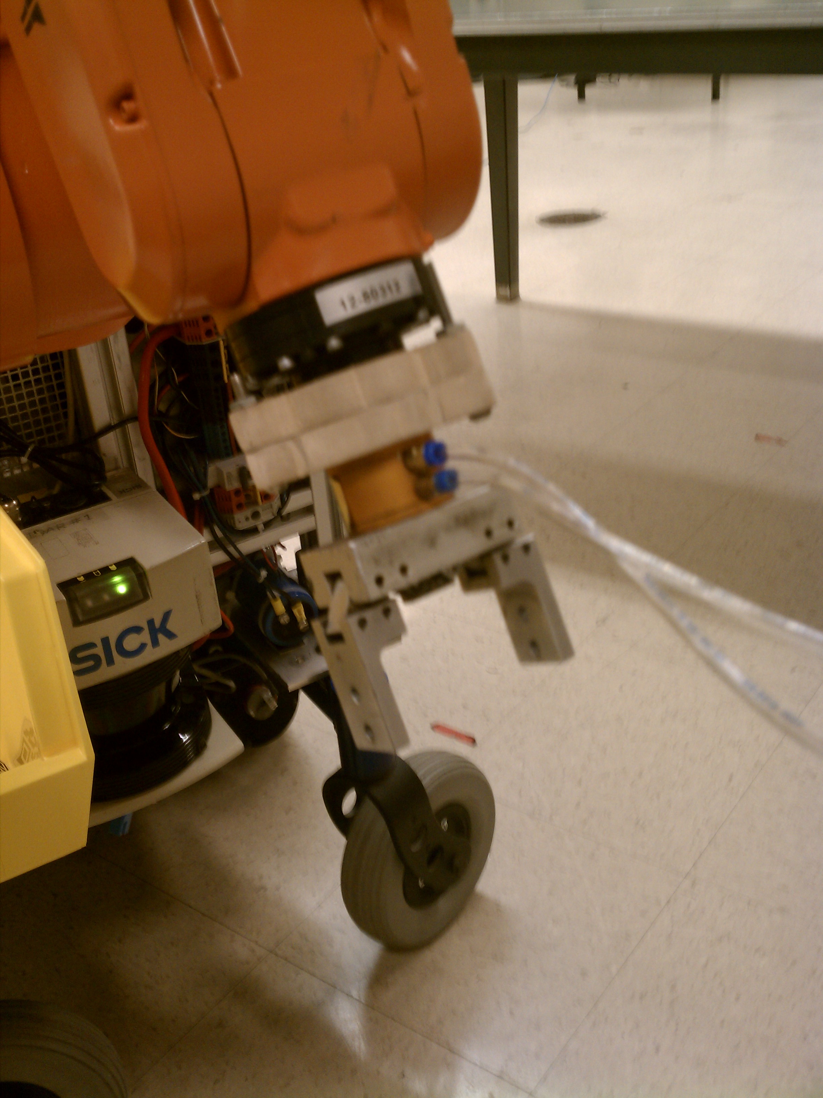
figures/IMG_20121206_181728.jpg
