evenator/masters/figures/IMG_20121206_181734.jpg

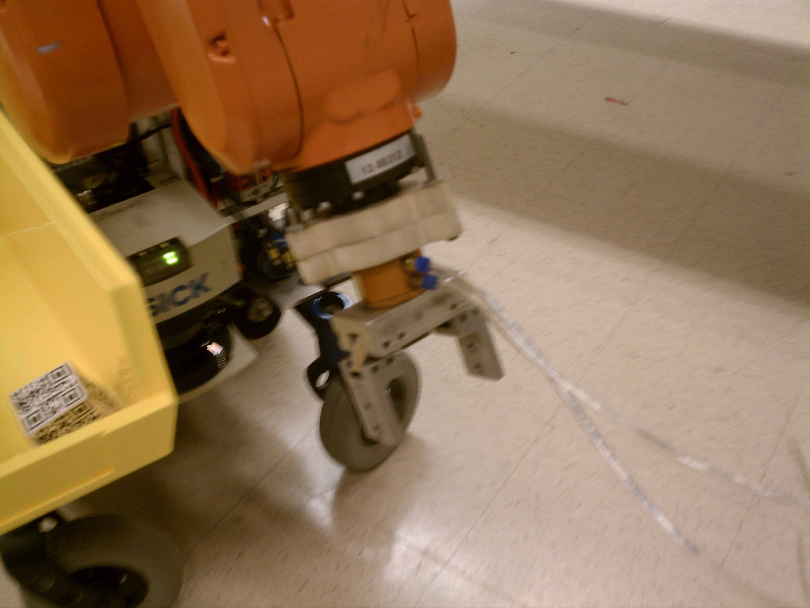
figures/IMG_20121206_181734.jpg
