evenator/masters/figures/IMG_20121206_181737.jpg

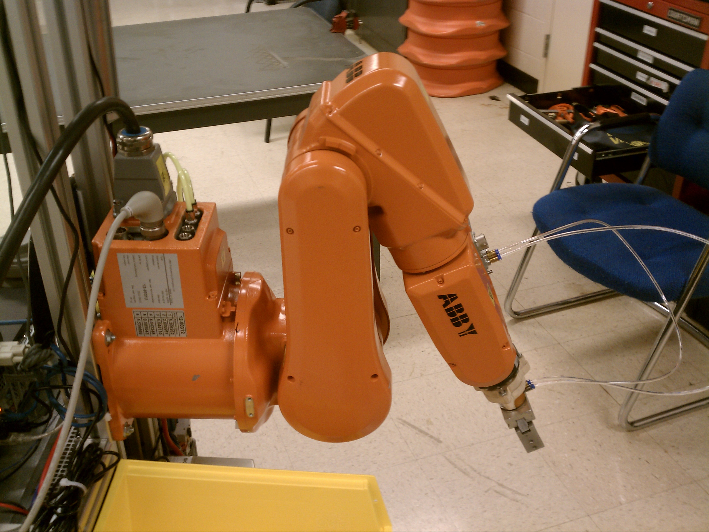
figures/IMG_20121206_181737.jpg
