evenator/masters/figures/IMG_20130210_132708.jpg

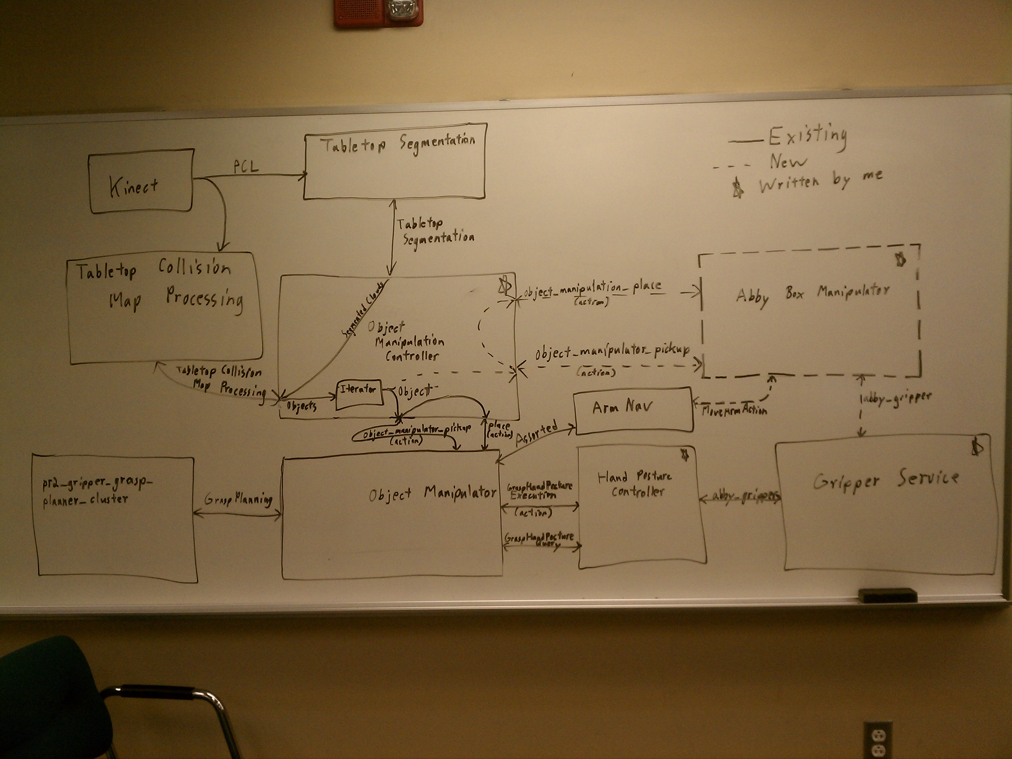
figures/IMG_20130210_132708.jpg
