evenator/masters/figures/IMG_20130210_132754.jpg

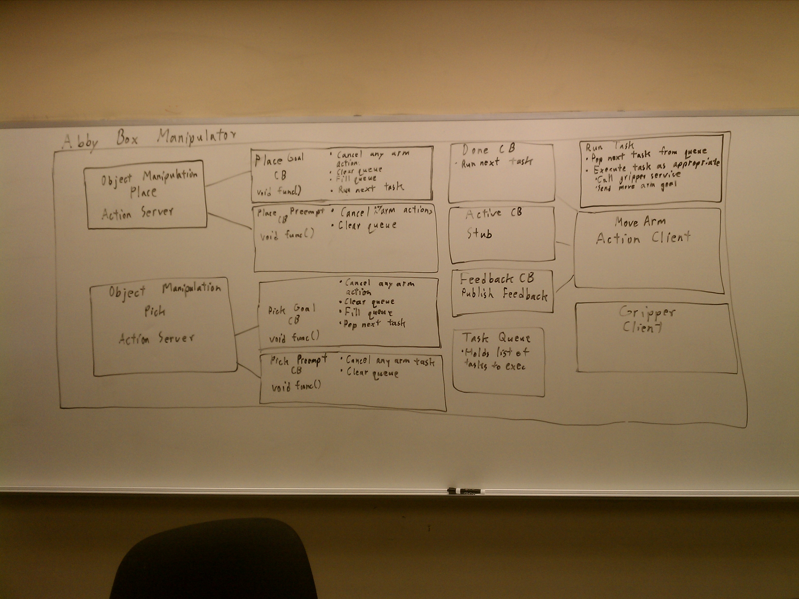
figures/IMG_20130210_132754.jpg
