evenator/masters/figures/IMG_20130210_132800.jpg

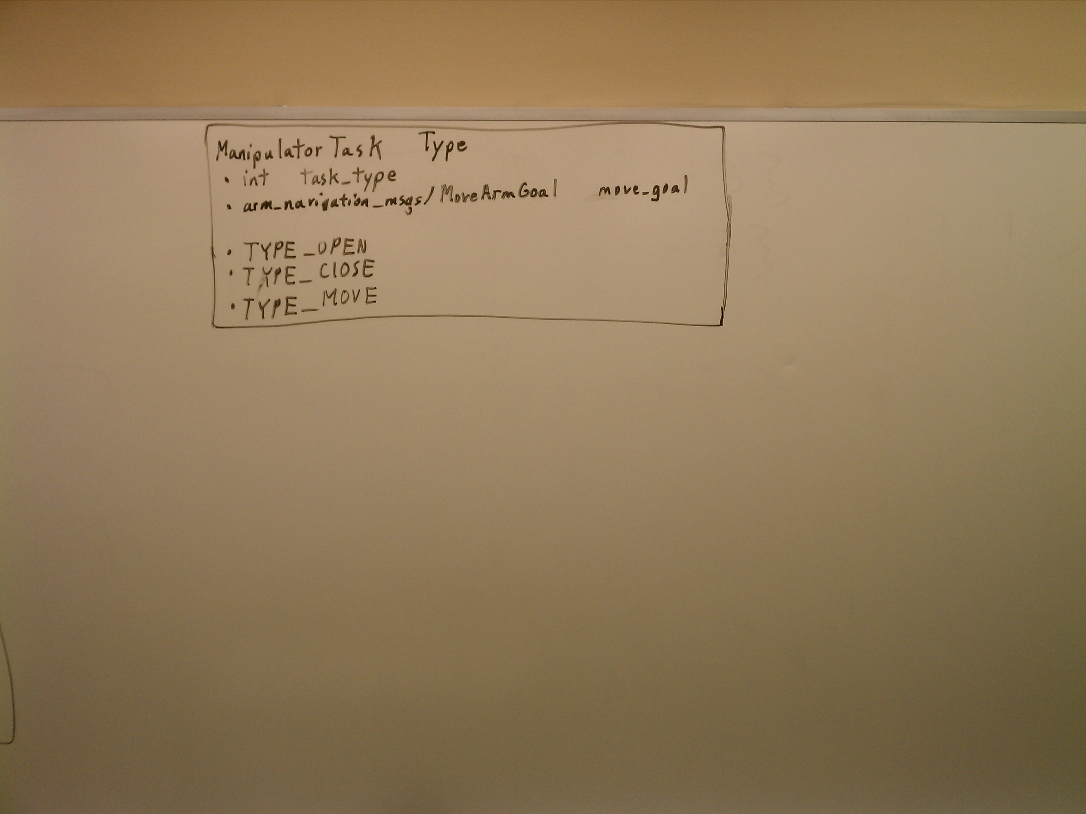
figures/IMG_20130210_132800.jpg
