evenator/masters/figures/IMG_20130215_134510.jpg

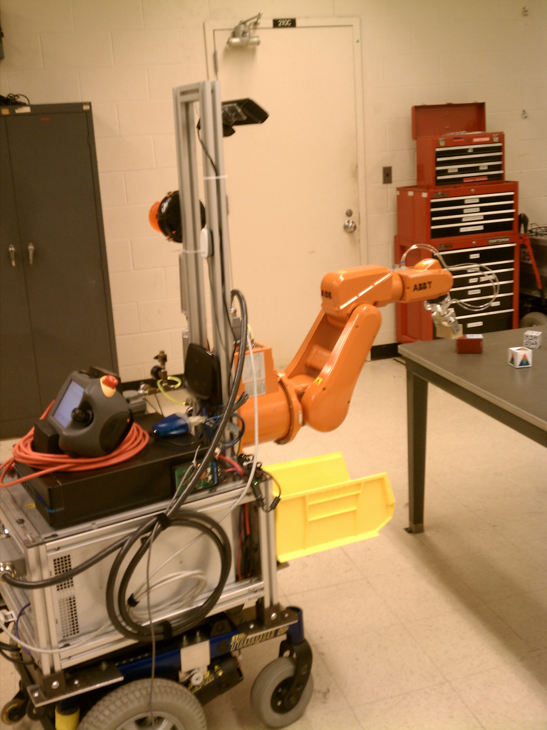
figures/IMG_20130215_134510.jpg
