evenator/masters/figures/IMG_20130215_134538.jpg

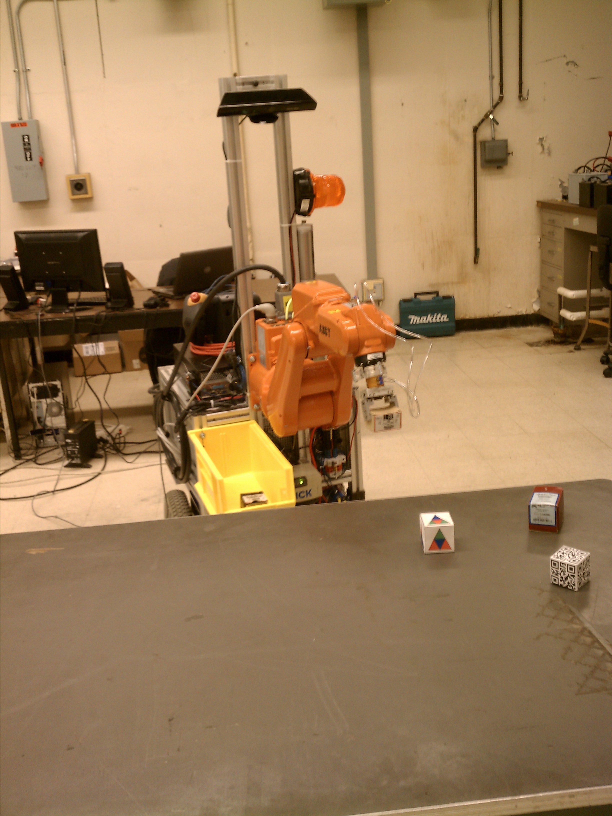
figures/IMG_20130215_134538.jpg
