evenator/masters/figures/IMG_20130215_134607.jpg

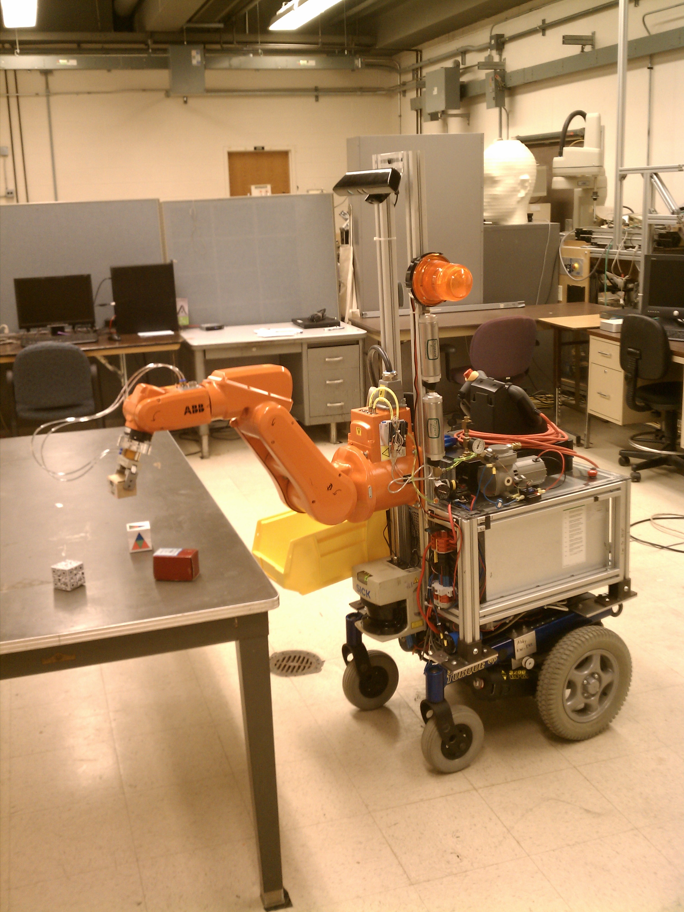
figures/IMG_20130215_134607.jpg
