evenator/masters/figures/IMG_20130215_134815.jpg

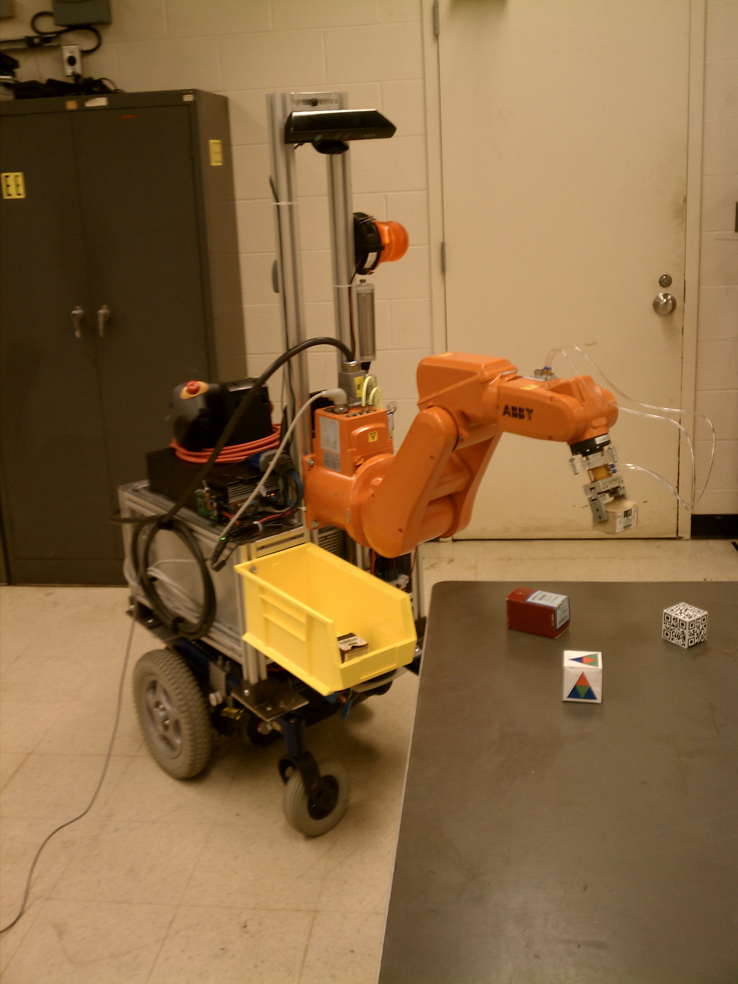
figures/IMG_20130215_134815.jpg
