evenator/masters/figures/IMG_20130215_134832.jpg

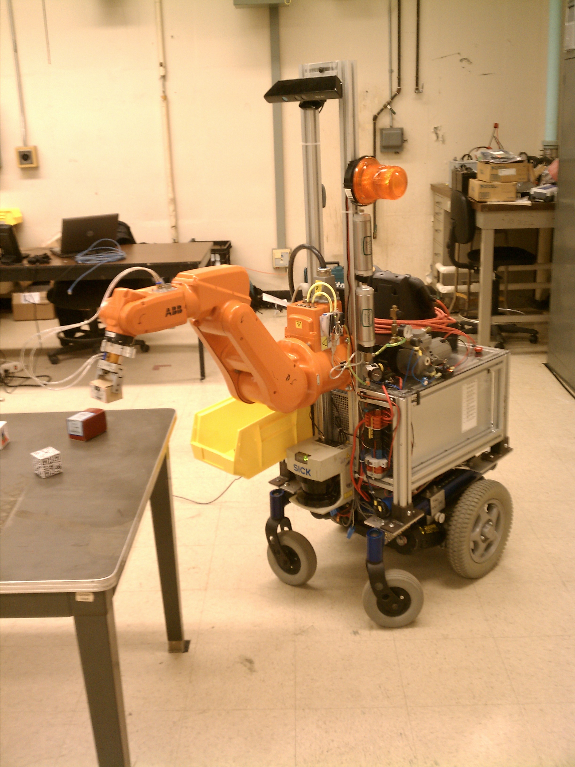
figures/IMG_20130215_134832.jpg
