evenator/masters/figures/IMG_20130215_134919.jpg

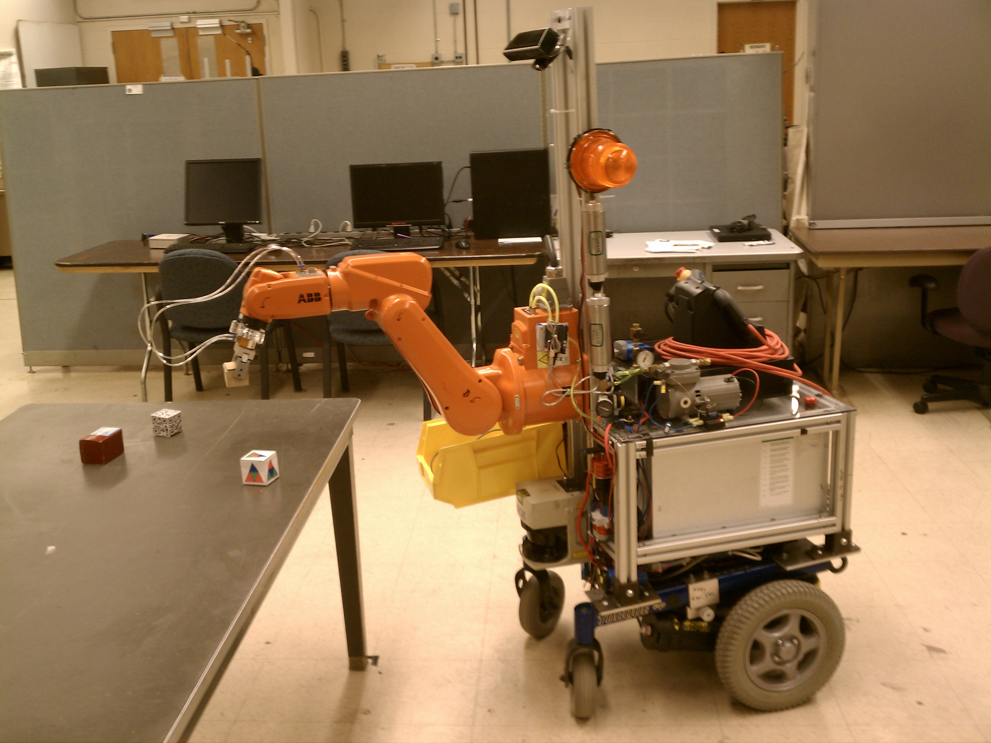
figures/IMG_20130215_134919.jpg
