evenator/masters/figures/IMG_20130215_134930.jpg

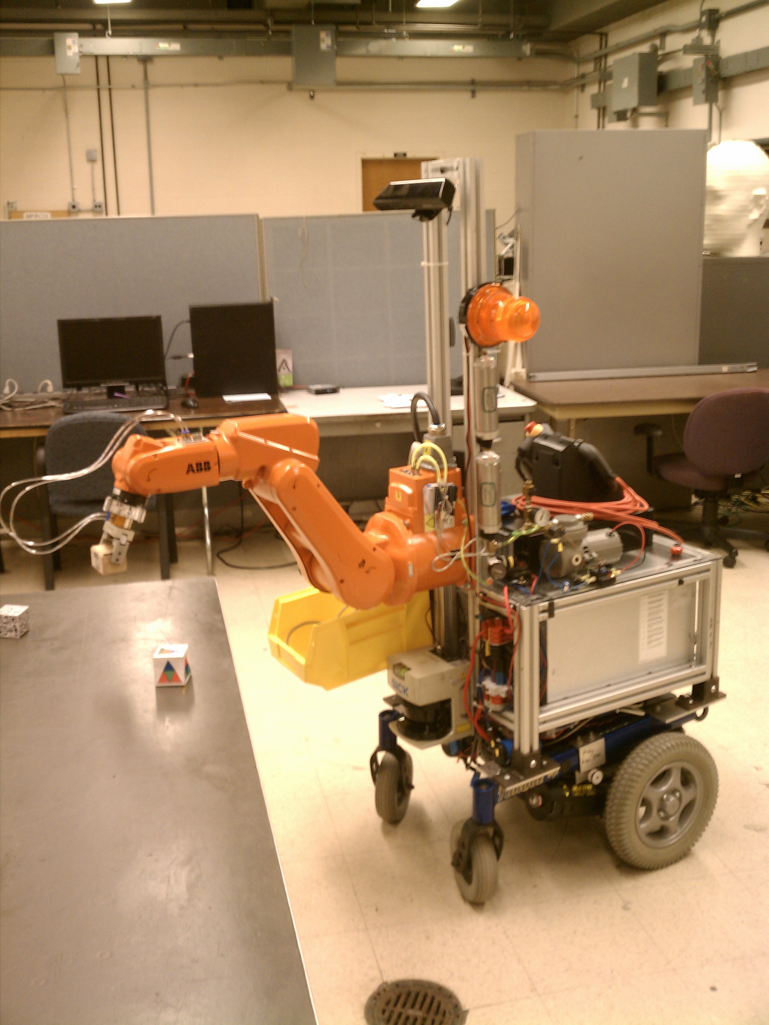
figures/IMG_20130215_134930.jpg
