evenator/masters/figures/IRB-120 (new).jpg

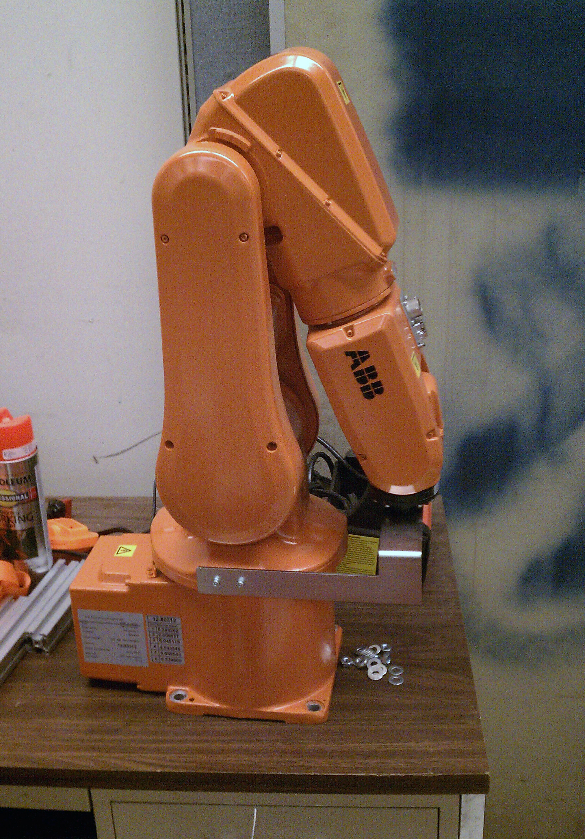
figures/IRB-120 (new).jpg
