evenator/masters/figures/kinect view of floor and arm.png

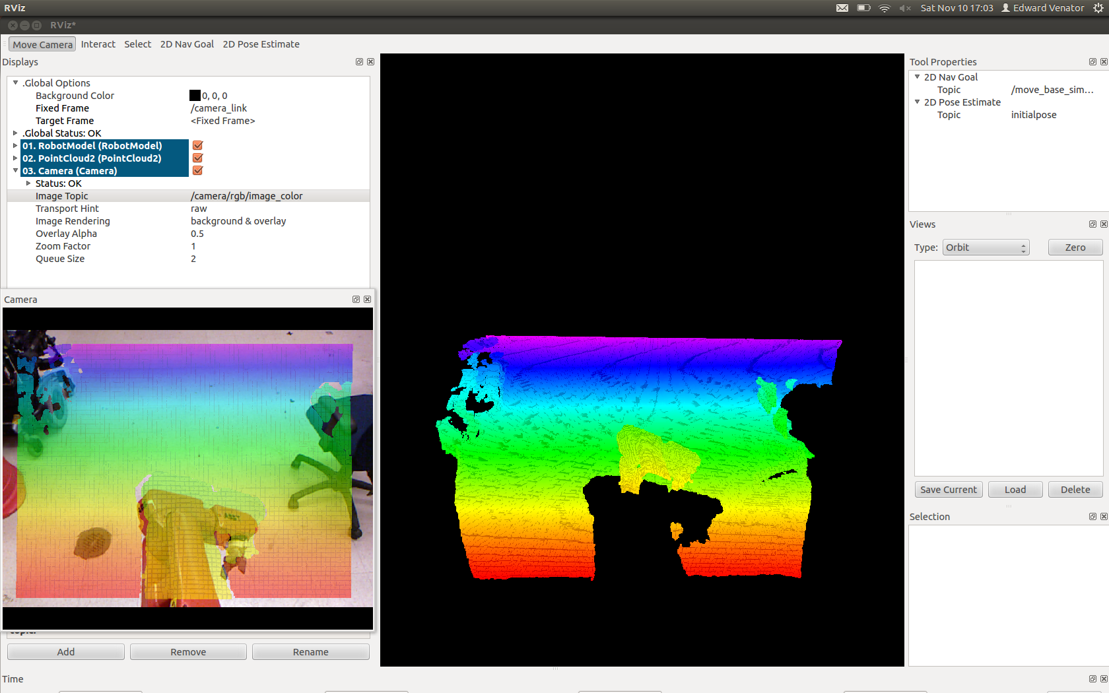
figures/kinect view of floor and arm.png
