evenator/masters/figures/presentation cover.jpg

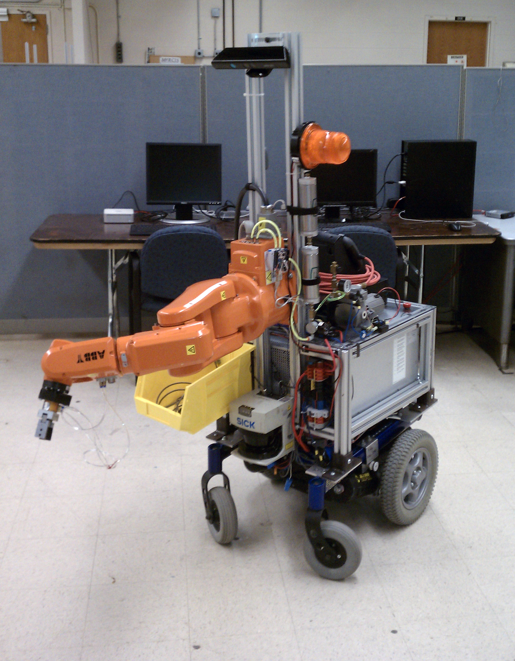
figures/presentation cover.jpg
