evenator/masters/figures/remote.png

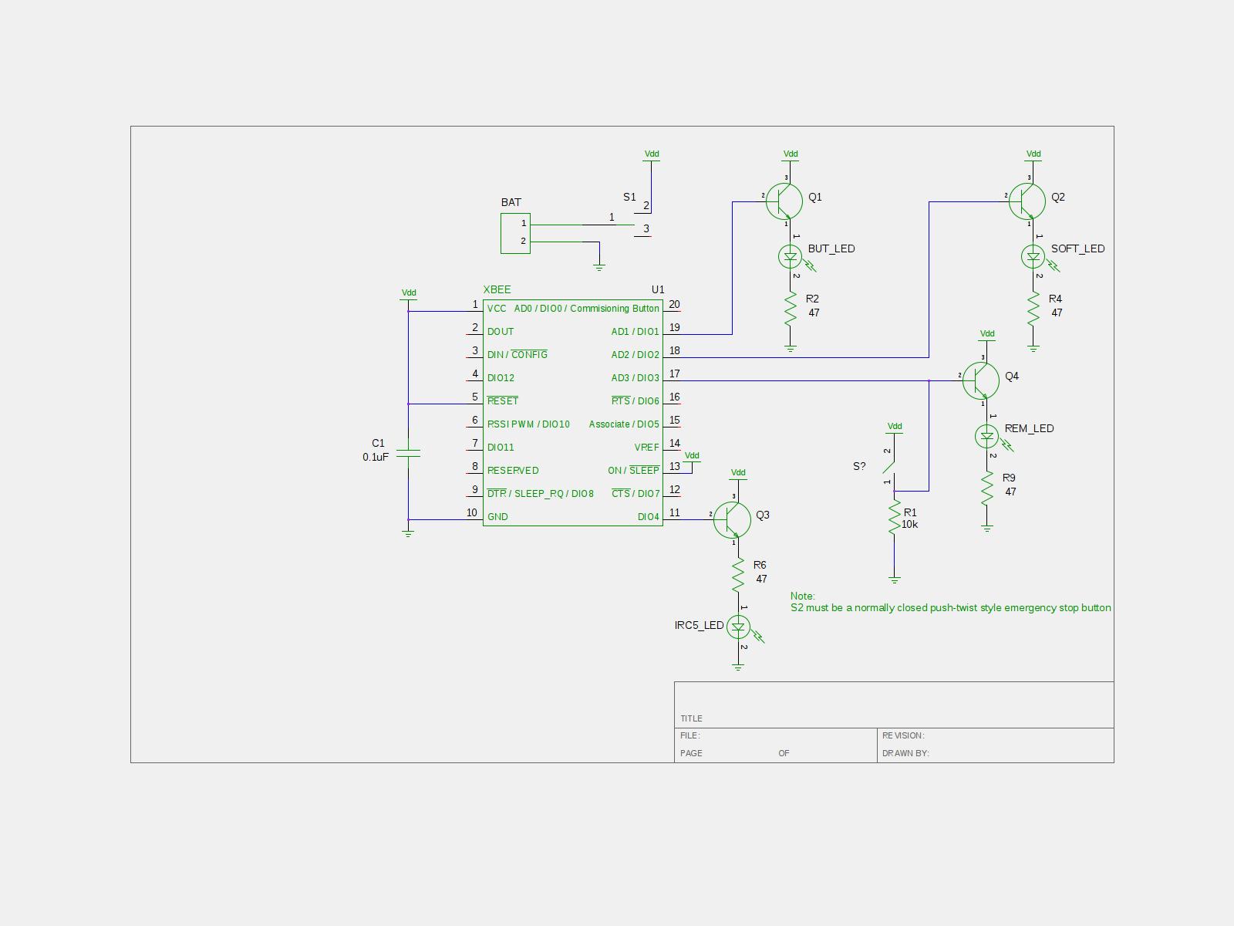
figures/remote.png
