evenator/masters/figures/ros_industrial.png

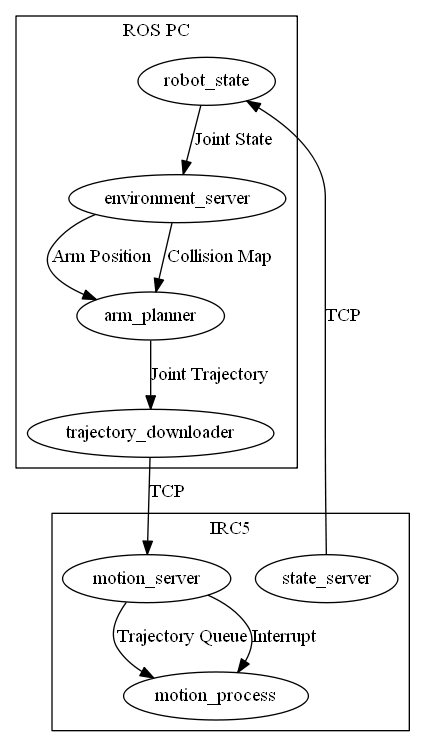
figures/ros_industrial.png
