evenator/masters/Mechanical/Gripper/gripper iso.png

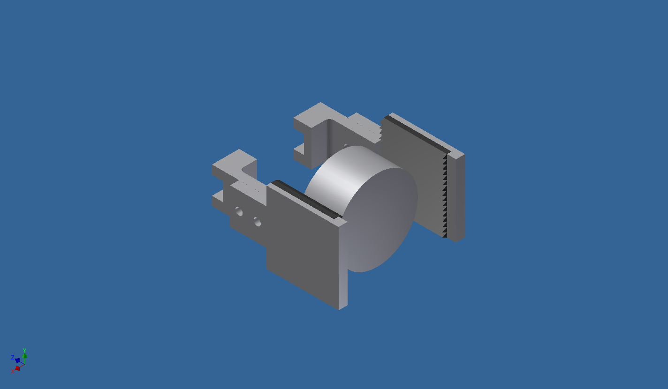
Mechanical/Gripper/gripper iso.png
