evenator/masters/Mechanical/Gripper/gripper plate.png

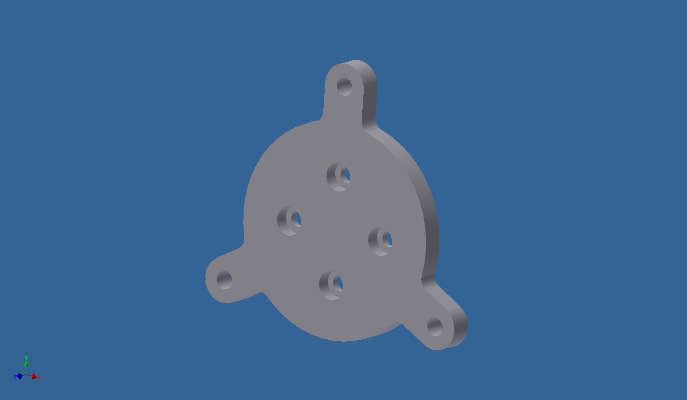
Mechanical/Gripper/gripper plate.png
