evenator/masters/Mechanical/Gripper/gripper side.png

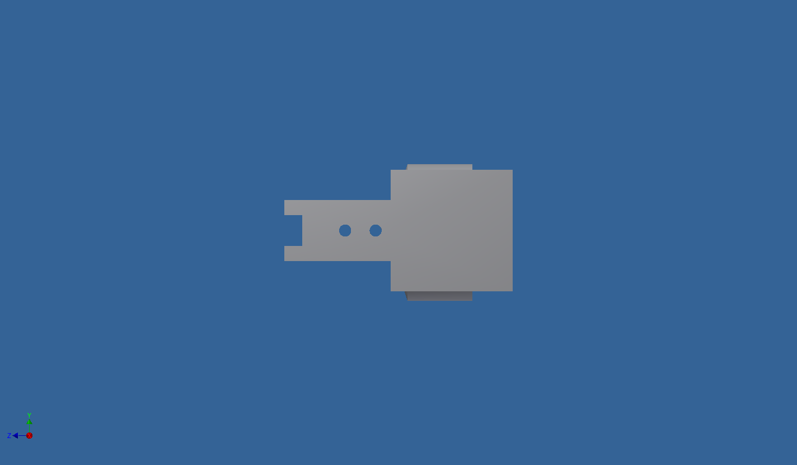
Mechanical/Gripper/gripper side.png
