evenator/masters/Mechanical/Gripper/gripper.png

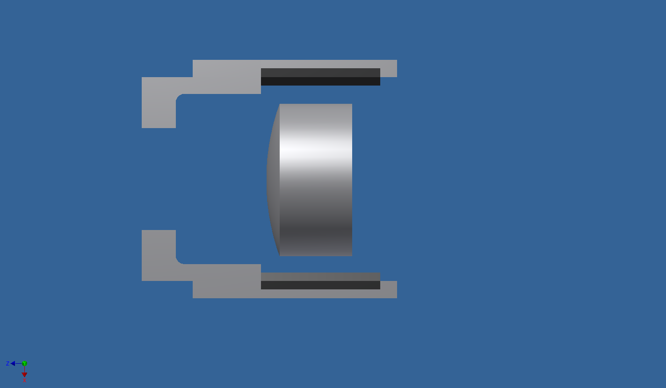
Mechanical/Gripper/gripper.png
