evenator/masters/Mechanical/Gripper/IRB120 plate.png

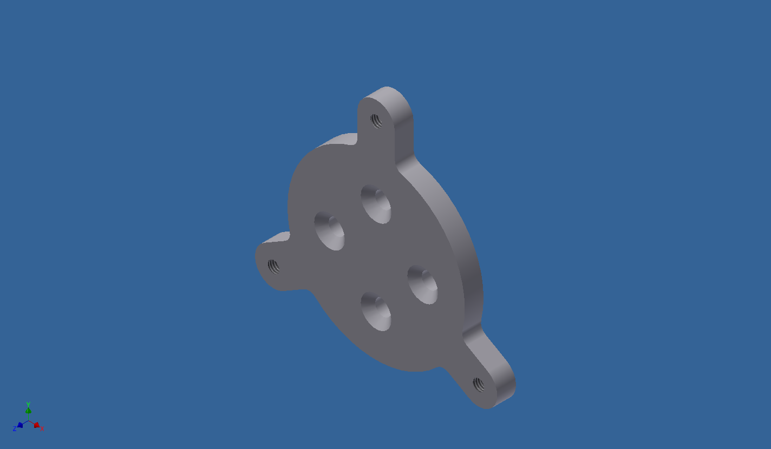
Mechanical/Gripper/IRB120 plate.png
