evenator/masters/Mechanical/Invacare/frame render 1.jpg

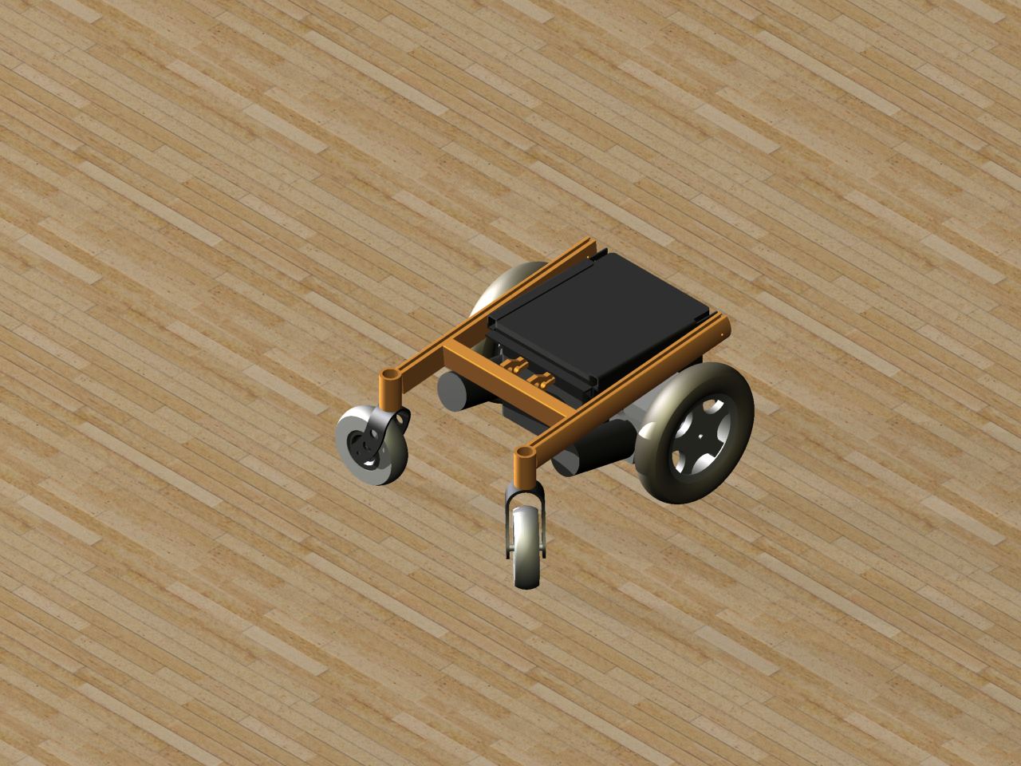
Mechanical/Invacare/frame render 1.jpg
