evenator/masters/Mechanical/iso.jpg

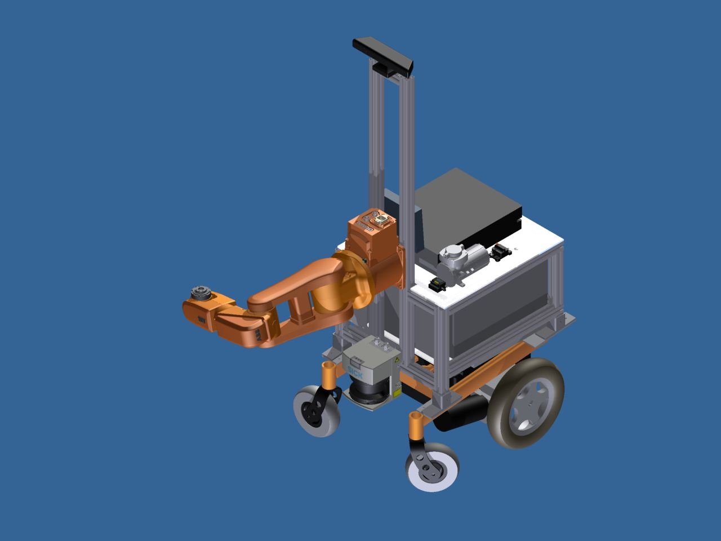
Mechanical/iso.jpg
