evenator/masters/Mechanical/robot2.png

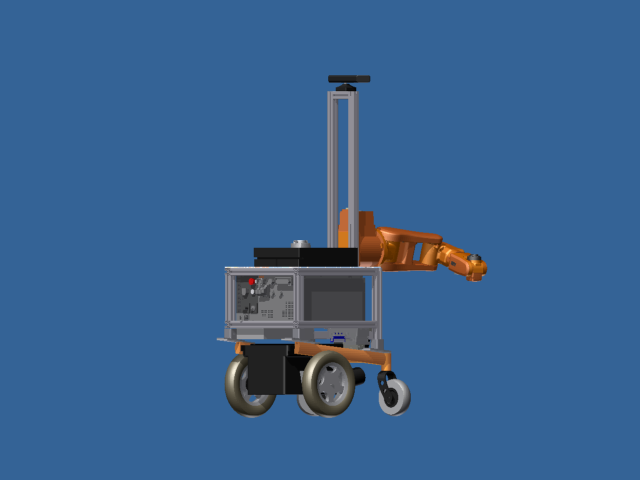
Mechanical/robot2.png
