evenator/masters/Mechanical/robot.png

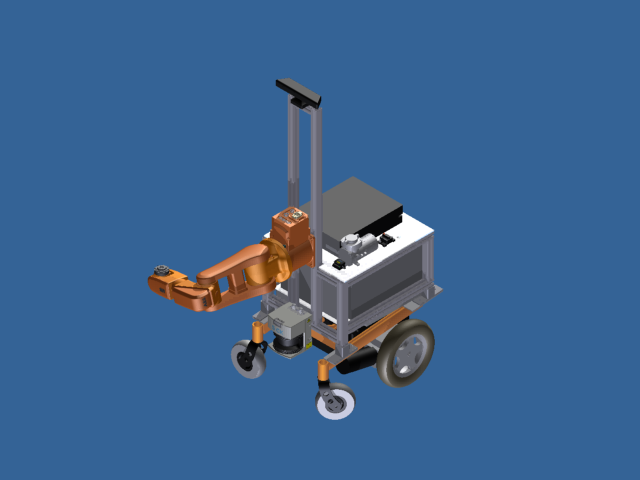
Mechanical/robot.png
