evenator/masters/thesis/figures/eestop_remote.png

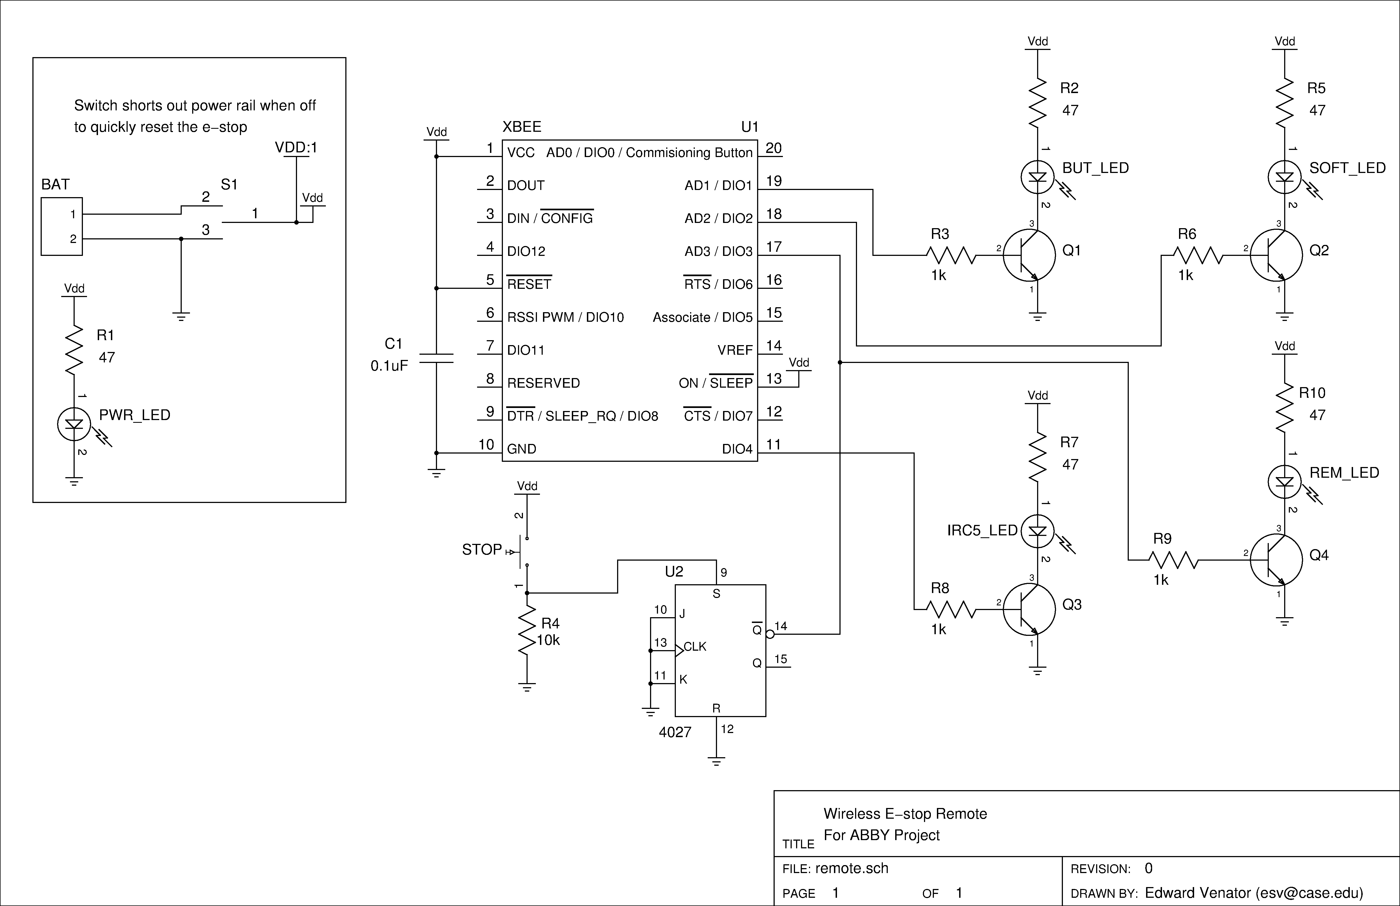
thesis/figures/eestop_remote.png
