evenator/masters/model BOM.xls

Sheet: BOM
Item | Part Num | QTY | Description | Source | Status
cRIO Breakout | N/A | 1 |  | Advanced Circuits | Need to Finish Design
E Stop | N/A | 1 |  | Advanced Circuits | Need to Finish Design
arm rail | N/A | 2 | 48" Bosch | Lab | Done
Breaker | N/A | 1 |  | Lab | Done
Cap | N/A | 1 |  | Lab | Done
compressor | N/A | 1 |  | Lab | Done
cRIO with Modules | N/A | 1 |  | Lab | Done
frame bracket | N/A | 4 |  | Lab | Done
front frame plate | N/A | 2 | 3" x 6" x .25" Al | Lab | Done
front top side rail | N/A | 2 | 5.75" Bosch | Lab | Done
front upright | N/A | 2 | 16.25" Bosch | Lab | Done
invacare assy | N/A | 1 |  | Lab | Done
Inverter | N/A | 1 |  | Lab | Done
IRB120 | N/A | 1 |  | Lab | Done
IRC5 | N/A | 1 |  | Lab | Done
LIDAR PSU | N/A | 1 |  | Lab | Done
LMS291 | N/A | 1 |  | Lab | Done
relay | N/A | 1 |  | Lab | Done
router | N/A | 1 |  | Lab | Done
sabertooth keepout | N/A | 1 |  | Lab | Done
Kinect | N/A | 1 |  | Lab | Done
Spike H | N/A | 1 |  | Lab | Done
supply-13.8 | N/A | 1 |  | Lab | Done
lower front rail | N/A | 3 | 17.9" Bosch | Lab (From 18" Piece) | Done
lower side rail | N/A | 4 | 20.55" Bosch | Lab (From 35.5" Piece) | Done
lower vertical rail | N/A | 2 | 14.16" Bosch | Lab (From 35.5" Piece) | Done
aim rail cross brace | N/A | 1 | 4.3125" Bosch | Lab (From 5" Piece) | Done
Grommets | 4946A22 |  |  | McMaster | Ordered
Flange Screws | N/A | 20 |  | McMaster | Ordered
PC | N/A | 1 |  | NewEgg | Needs Mounting Holes
back frame plate | N/A | 2 | 3" x 8" x .25" Al | OnlineMetals | Done
base plate | N/A | 1 | 21" x 19" x .22" PC | OnlineMetals | Done
top plate | N/A | 1 | 21.25" x 23.5" x .25 PC | McMaster | Ordered
Front Left Plate | N/A | 1 | 8.25" x 14.25" x .062" Al | OnlineMetals | Done
Front Right Plate | N/A | 1 | 8.25" x 14.25" x .062" Al | OnlineMetals | Done

Sheet: cRIO Breakout
Item | Part Number | QTY | Description | Source | Status
2 x 4 header | A34274-40-ND | 2 | Encoder Connector | Digikey | Ordered
2 x 6 header | A34274-40-ND | 1 | For RC Connectors + Sabertooth | Digikey | Ordered
1 x 2 header | A34274-40-ND | 1 | For RC Switch | Digikey | Ordered
DB 25 (Female) | 609-4000-ND | 1 |  | Digikey | Ordered
DA 37 (Female) | 609-4001-ND | 1 |  | Digikey | Ordered
6 POS Screw Connector | ED2604-ND | 1 |  | Digikey | Ordered
33k Resistor | 311-33KGRCT-ND | 6 | Voltage Dividers + Switch Pullup | Digikey | Ordered
7805 | N/A | 1 | 5v Regulator | Lab | Done
100k Resistor | 311-100KGRCT-ND | 5 | Voltage Dividers | Digikey | Ordered
DE 9 (Female) | 609-1483-ND | 1 | To Analog | Digikey | Ordered
10 uF Capacitor | N/A | 2 | Regulator Bypass | Lab | Done
DE 9 (Male) | L17DEFRA09P-ND | 1 | For Analog Cable | Digikey | Ordered
Board | N/A | 1 |  | Thinkbox | Needs Finished Design

Sheet: eStop (Robot)
Item | Part Number | QTY | Description | Source | Status
Case | 377-1652-ND | 1 |  | Digikey | Ordered
xbee | XBP24-ACI-001-ND | 1 |  | Digikey | Ordered
10 pos screw connector | ED2607-ND | 1 |  | Digikey | Ordered
2 x 1 header | A34274-40-ND | 1 |  | Digikey | Ordered
1k Resistor | 311-1.0KGRCT-ND | 4 |  | Digikey | Ordered
10k Resistor | 311-10KGRCT-ND | 2 |  | Digikey | Ordered
110 resistor | 311-110GRCT-ND | 1 |  | Digikey | Ordered
180 resistor | 311-180GRCT-ND | 1 |  | Digikey | Ordered
27 resistor | 311-27GRCT-ND | 1 |  | Digikey | Ordered
4001 |  | 1 |  | Lab | Done
LM317 |  | 1 |  | Lab | Done
4N35 |  | 2 |  | Lab | Done
NPN Transistor |  | 2 |  | Lab | Done
.1uF Capacitor |  | 3 |  | Lab | Done
1uF Capacitor |  | 1 |  | Lab | Done
Diode |  | 1 |  | Lab | Done
Board |  | 1 |  | Thinkbox | Needs Finished Design

Sheet: eStop (Remote)
Item | Part Number | QTY | Description | Source | Status
Case | SRH65-AAB-ND | 1 |  | Digikey | Ordered
xbee | XBP24-ACI-001-ND | 1 |  | Digikey | Ordered
1k resistor | 311-1.0KGRCT-ND | 5 | Transistor Base Resistors + Switch Pull down | Digikey | Ordered
47 resistor | 311-47GRCT-ND | 4 | LED Resistors | Digikey | Ordered
Power Switch | CKN9565-ND | 1 |  | Digikey | Ordered
E-Stop Button | SW637-ND | 1 |  | Digikey | Ordered
Green LED |  | 4 | E-Stop Status Indicators | Lab | Done
NPN Transistor |  | 4 |  | Lab | Done
Board |  | 1 |  | Thinkbox | Needs Finished Design
