evenator/masters/ABBy micro atx pc.xlsx

Item | Source | Qty | Price Per | Line Total | Notes
Intel Core i5 2500 Processor | newegg.com | 1 | $229.99 | $229.99 | 4 Cores, 3.3GHz, Sandybridge architecture, onboard graphics, 95W
ASUS P8H61-M LX PLUSMicro ATX Motherboard | newegg.com | 1 | $69.99 | $69.99
G.SKILL Ripjaws 2 x 4GB DDR3 1333 RAM | newegg.com | 1 | $41.99 | $41.99
IN WIN BP641.300BL Micro ATX Computer Case | newegg.com | 1 | $64.99 | $64.99 | 13.0" x 3.8" x 14.4"
M4-ATX-HV DC-DC Power Supply | mini-box.com | 1 | $89.50 | $89.50 | 6-34v Input, 250W ATX output
Total |  |  |  | $496.46
