evenator/masters/ABBy pc.xlsx

Item | Source | Qty | Price Per | Line Total | Notes
Intel Core i5 2500 Processor | newegg.com | 1 | $229.99 | $229.99 | 4 Cores, 3.3GHz, Sandybridge architecture, onboard graphics, 95W
Foxconn H67S Mini ITX Intel Motherboard | newegg.com | 1 | $74.99 | $74.99
G.SKILL Ripjaws 2 x 4GB DDR3 1333 RAM | newegg.com | 1 | $41.99 | $41.99
IN WIN BP655.200BL Mini ITX Computer Case | newegg.com | 1 | $54.99 | $54.99 | 12.2" x 10.4" x 3.9"
M4-ATX-HV DC-DC Power Supply | mini-box.com | 1 | $89.50 | $89.50 | 6-34v Input, 250W ATX output
Total |  |  |  | $491.46
