evenator/masters/urdf/all_fixed/caster assy_iam_cc1e69ad.STL

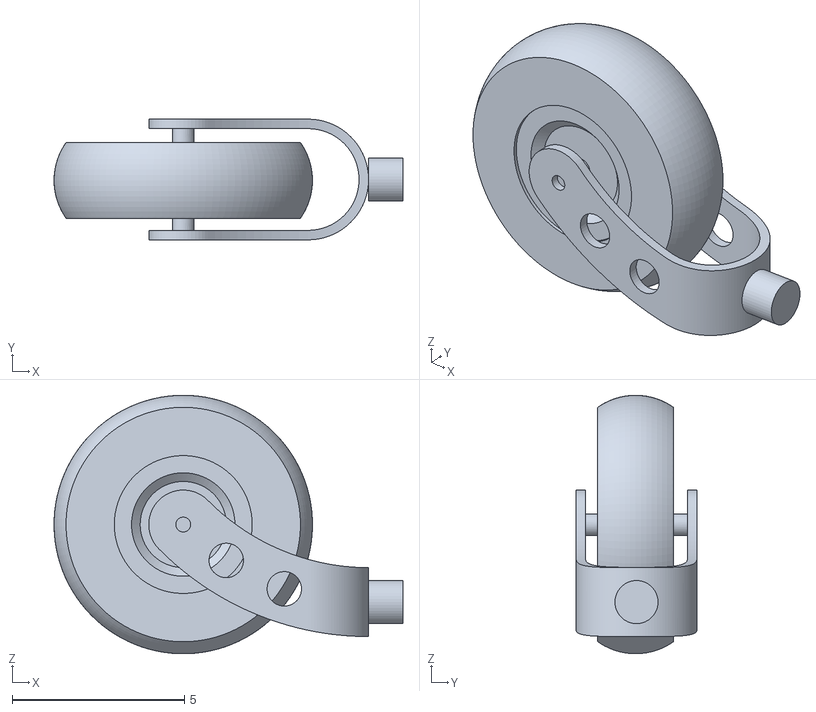
[picture p119: CAD file, 2012-07-24]
urdf/all_fixed/caster assy_iam_cc1e69ad.STL
10.1 x 3.50 x 7.50
