evenator/masters/urdf/invacare assy_iam_8d469021.STL

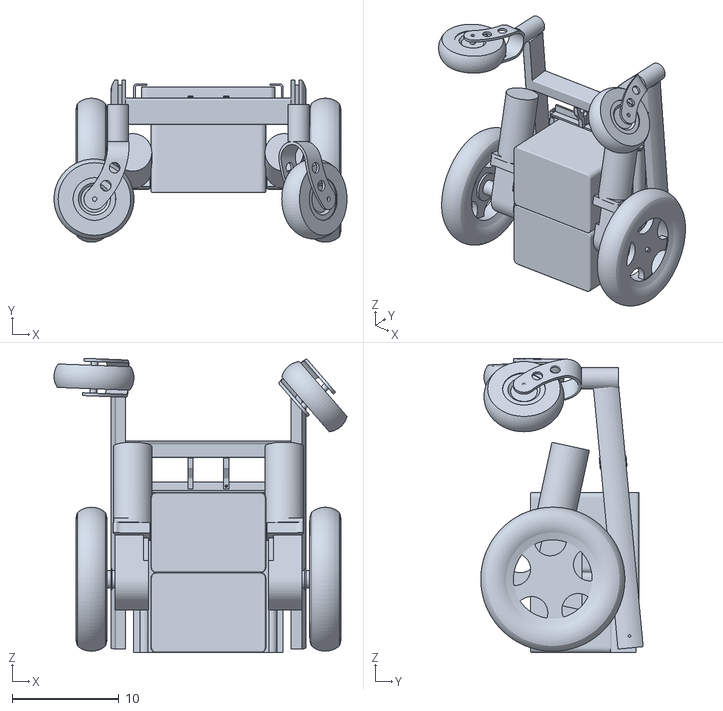
[picture p120: CAD file, 2012-05-26]
urdf/invacare assy_iam_8d469021.STL
27.4 x 15.2 x 27.6
