evenator/masters/Mechanical/cRIO/STEP/cu_conn_crio_10_pos_weid.stp

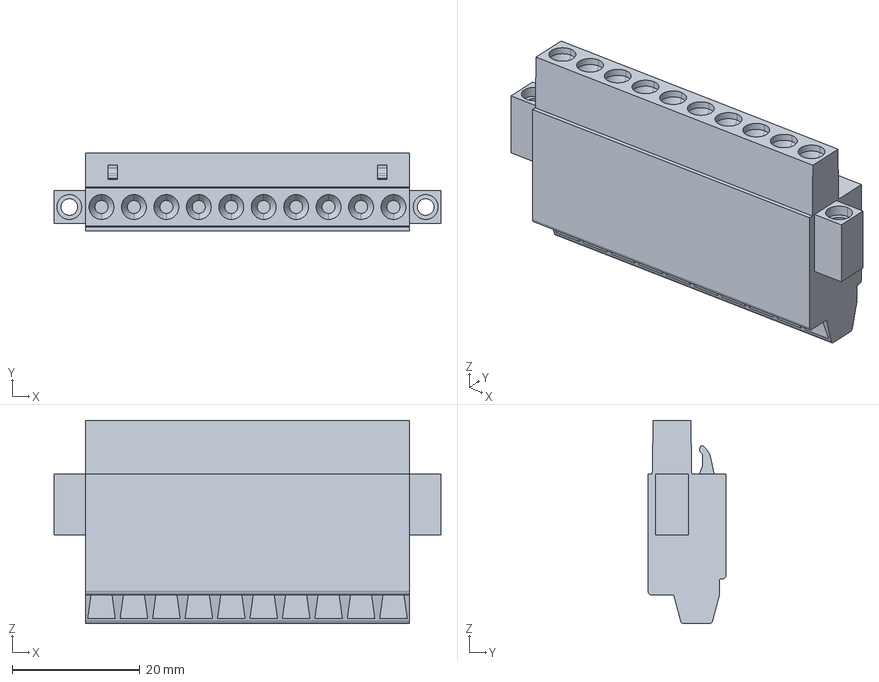
[picture p121: CAD file, 2012-07-17]
Mechanical/cRIO/STEP/cu_conn_crio_10_pos_weid.stp
60.6 x 12.2 x 31.8 mm
