evenator/masters/Mechanical/DIN Terminal/DIN Terminal.stp

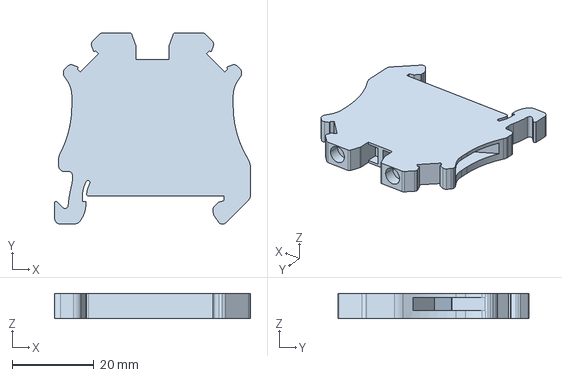
[picture p122: CAD file, 2012-03-31]
Mechanical/DIN Terminal/DIN Terminal.stp
48.0 x 46.9 x 6.15 mm
