evenator/masters/Mechanical/IRB120/Simmechanics/IRB120_Link1_rev0_iam_3fe6e7e5.STL

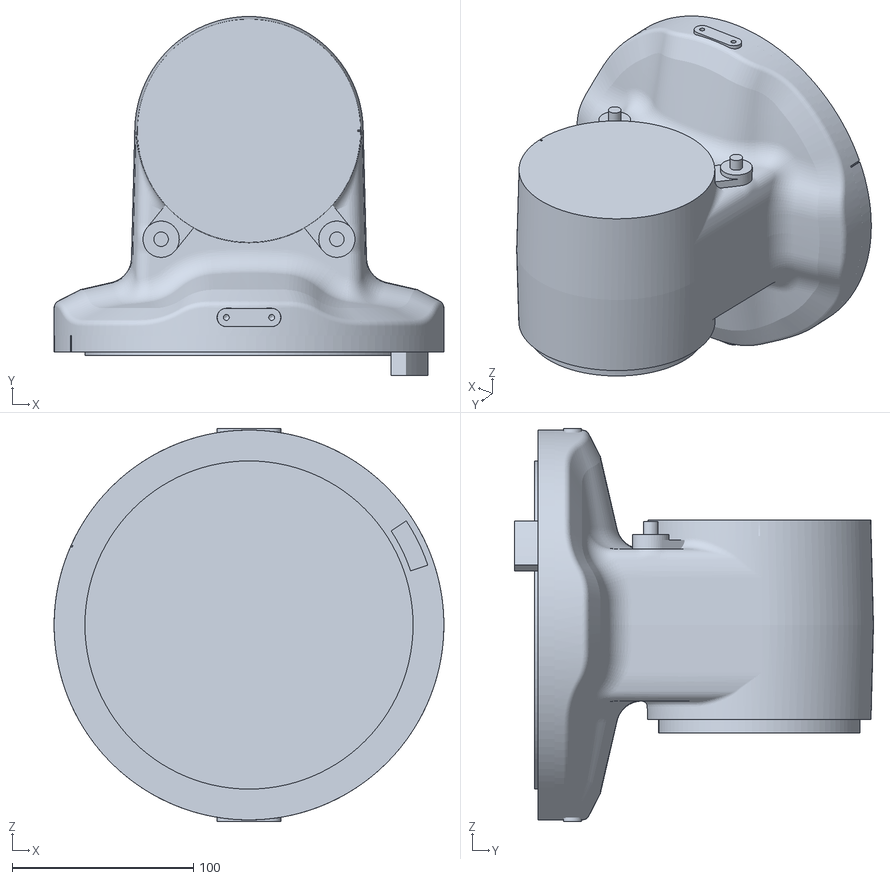
[picture p123: CAD file, 2012-02-10]
Mechanical/IRB120/Simmechanics/IRB120_Link1_rev0_iam_3fe6e7e5.STL
215.0 x 198.0 x 217.0
