evenator/masters/Mechanical/IRC5/IRC5_Compact.stp

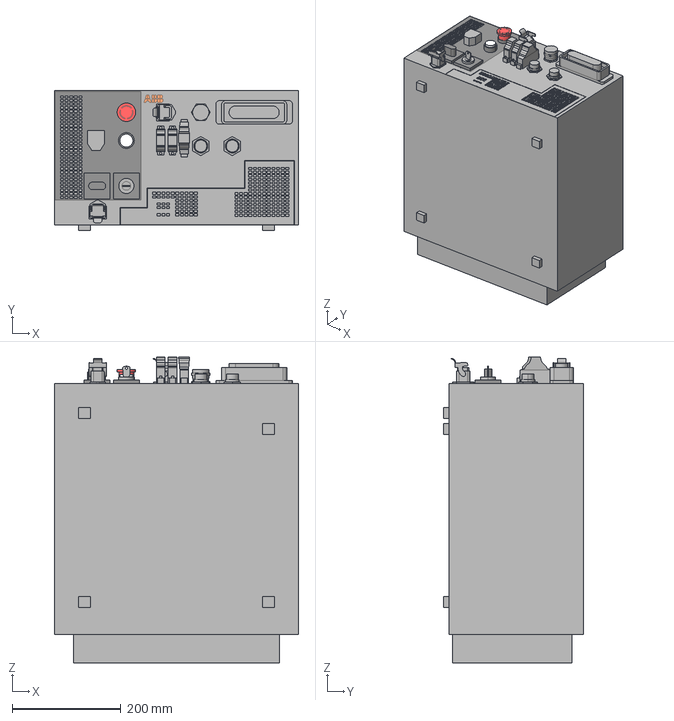
[picture p124: CAD file, 2012-07-17]
Mechanical/IRC5/IRC5_Compact.stp
450.0 x 257.2 x 563.3 mm
