evenator/masters/Mechanical/Kinect/acrylic kinect bracket - manufacturing.dxf

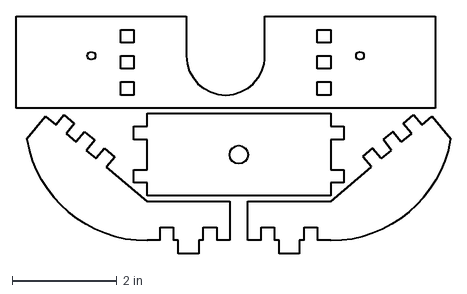
[picture p125: CAD file, 2012-11-05]
Mechanical/Kinect/acrylic kinect bracket - manufacturing.dxf
8.30 x 4.52 in
