evenator/masters/Mechanical/Pneumatics/step/accumulator.stp

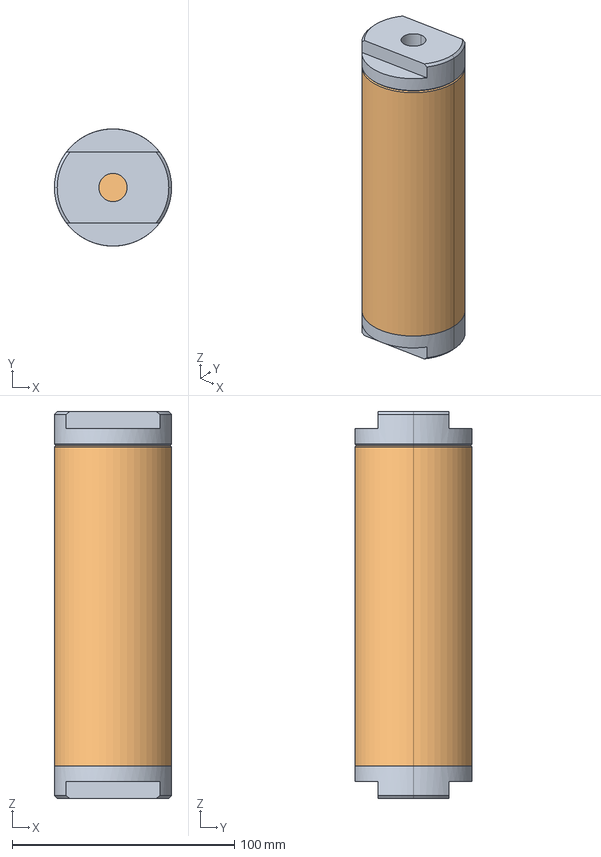
[picture p126: CAD file, 2012-07-17]
Mechanical/Pneumatics/step/accumulator.stp
52.7 x 52.7 x 174.0 mm
volumetank1
volumetank2
volumetank3
