evenator/masters/Mechanical/SICK/LMS291-S05_S14-S052389.stp

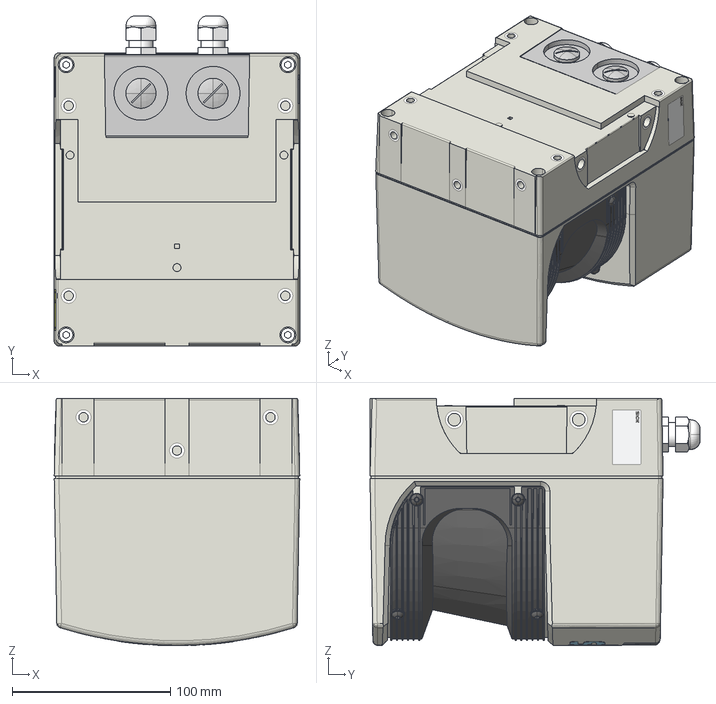
[picture p127: CAD file, 2012-07-17]
Mechanical/SICK/LMS291-S05_S14-S052389.stp
155.0 x 208.3 x 156.2 mm
