evenator/masters/urdf/all_fixed/gripper_iam_ad0c01b6.STL

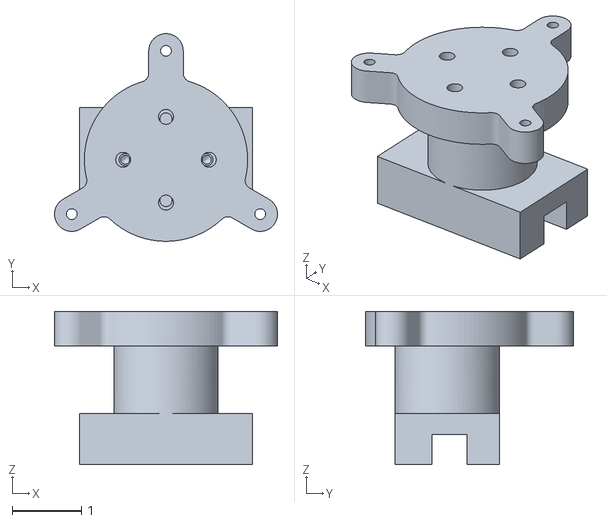
[picture p128: CAD file, 2012-08-09]
urdf/all_fixed/gripper_iam_ad0c01b6.STL
3.23 x 3.01 x 2.22
