evenator/masters/urdf/fixed_frame/lumped batteries_iam_65dee181.STL

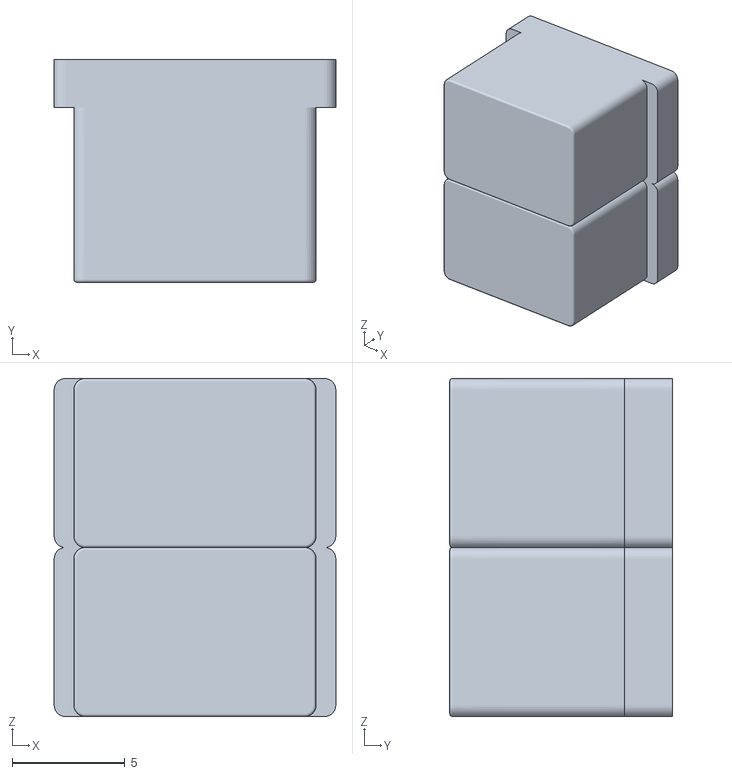
[picture p129: CAD file, 2012-08-09]
urdf/fixed_frame/lumped batteries_iam_65dee181.STL
12.5 x 9.88 x 15.0
