evenator/masters/urdf/fixed_frame_no_arm/caster wheel_ipt_4784d7d8.stl

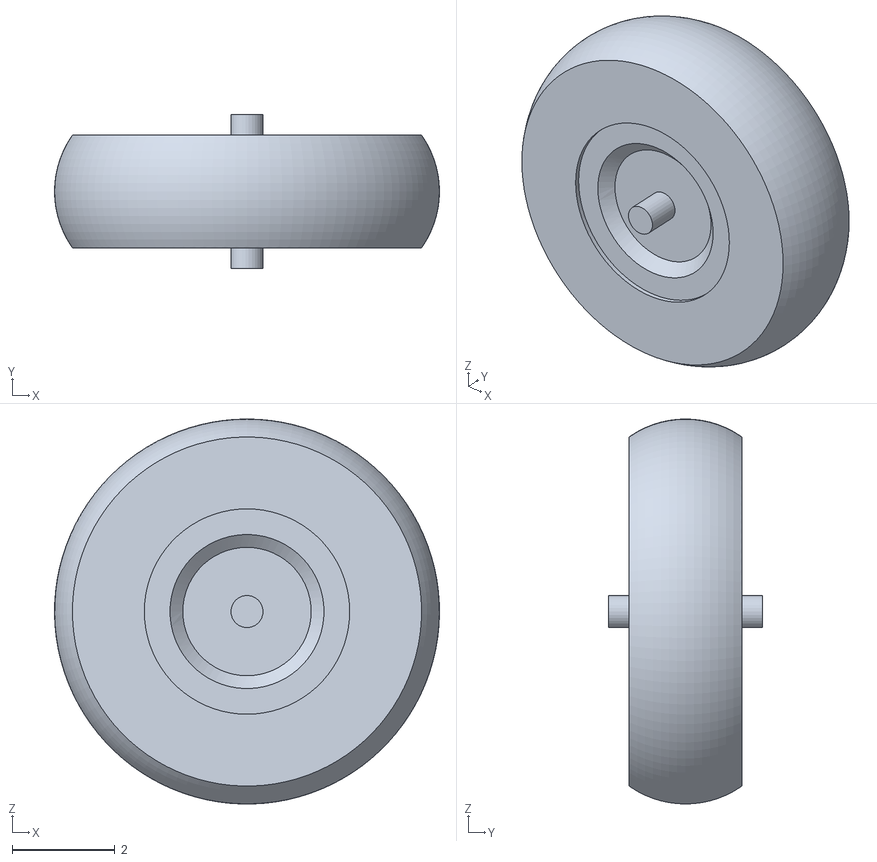
[picture p130: CAD file, 2012-07-24]
urdf/fixed_frame_no_arm/caster wheel_ipt_4784d7d8.stl
7.50 x 3.00 x 7.50
