evenator/masters/urdf/gripper jaw_iam_c4751bb6.STL

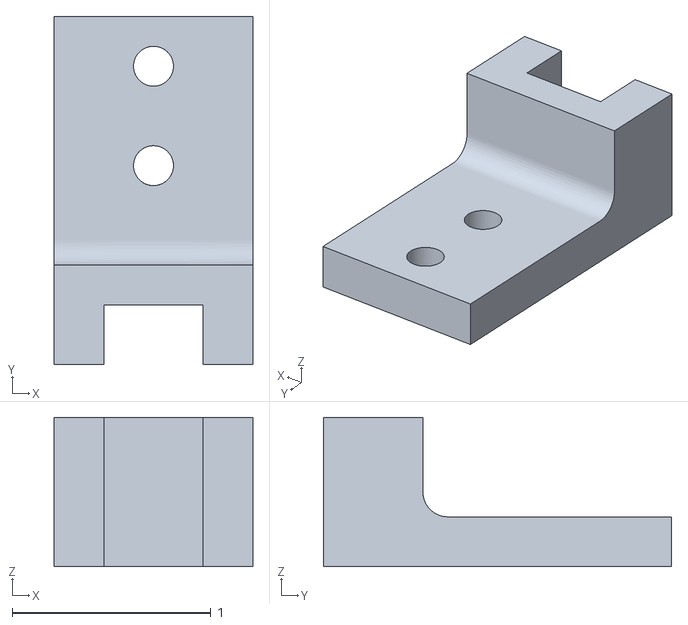
[picture p131: CAD file, 2013-03-25]
urdf/gripper jaw_iam_c4751bb6.STL
1.00 x 1.75 x 0.75
