evenator/masters/urdf/gripper/acrylic_gripper_iam.stl

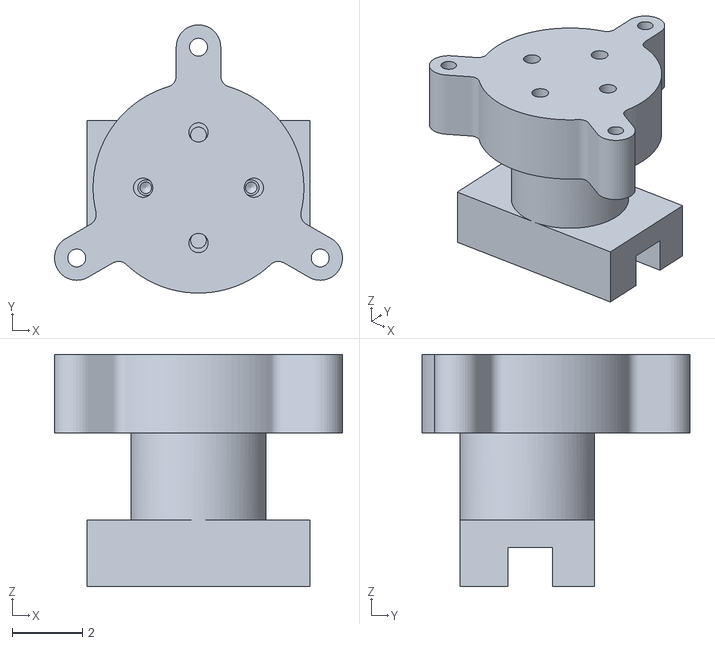
[picture p132: CAD file, 2013-02-24]
urdf/gripper/acrylic_gripper_iam.stl
8.20 x 7.63 x 6.61
