evenator/masters/Mechanical/IRB120/Simmechanics/IRB120_Link4_rev0_iam_467bed4b.STL

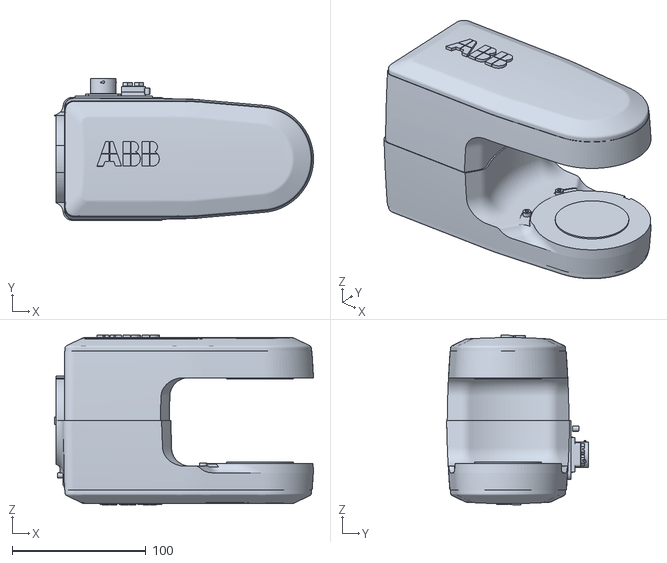
[picture p133: CAD file, 2012-02-10]
Mechanical/IRB120/Simmechanics/IRB120_Link4_rev0_iam_467bed4b.STL
193.5 x 105.9 x 126.9
