evenator/masters/Mechanical/Kinect/Sensors_Microsoft_Kinect.stp

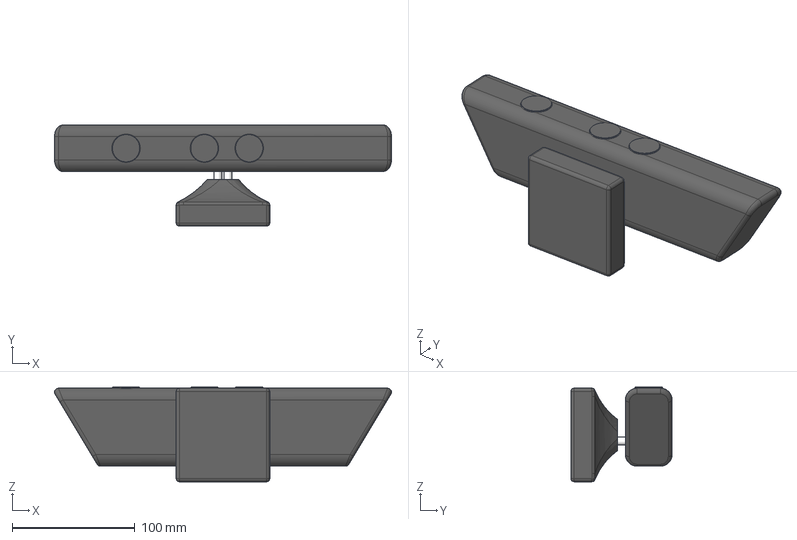
[picture p134: CAD file, 2012-07-17]
Mechanical/Kinect/Sensors_Microsoft_Kinect.stp
274.5 x 82.6 x 77.0 mm
