evenator/masters/Mechanical/Pneumatics/step/regulator.stp

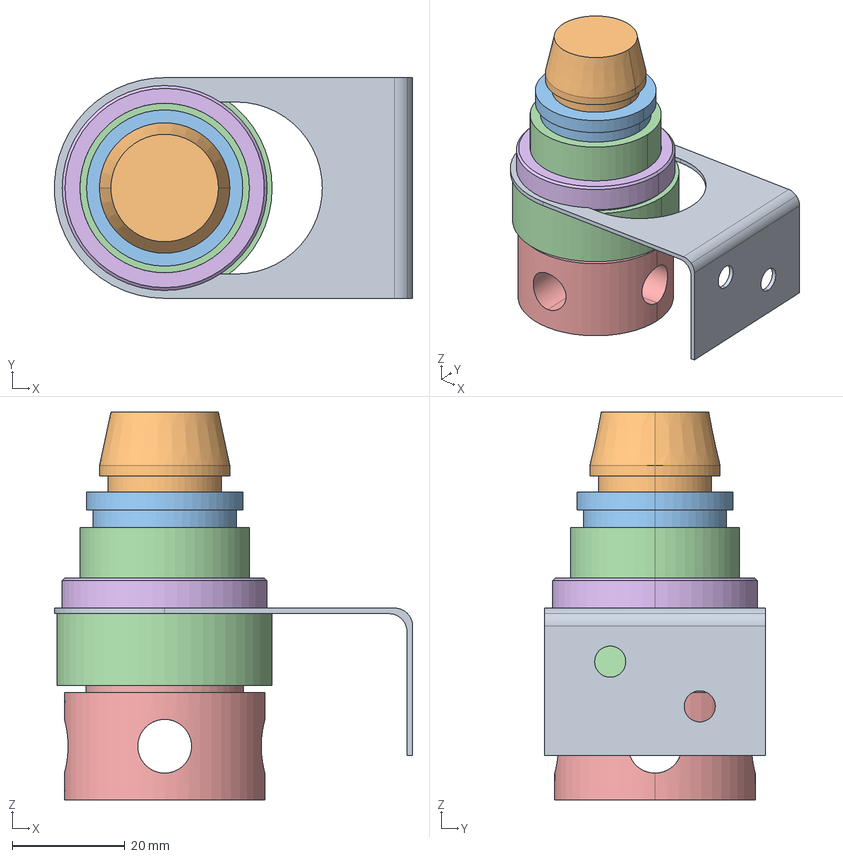
[picture p135: CAD file, 2012-07-17]
Mechanical/Pneumatics/step/regulator.stp
63.5 x 39.1 x 68.8 mm
pressureregulator11
pressureregulator12
pressureregulator13
pressureregulator14
pressureregulator15
pressureregulator16
