evenator/masters/urdf/all_fixed/gripper jaw_iam_c4751bb6.STL

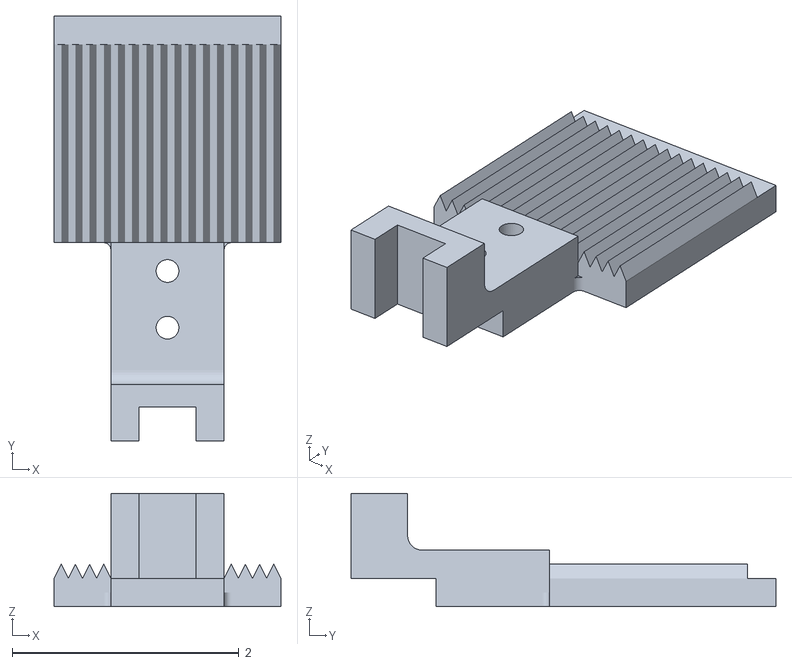
[picture p136: CAD file, 2012-08-09]
urdf/all_fixed/gripper jaw_iam_c4751bb6.STL
2.00 x 3.75 x 1.00
