evenator/masters/urdf/fixed_frame_no_arm/caster_ipt_ca03a3d7.stl

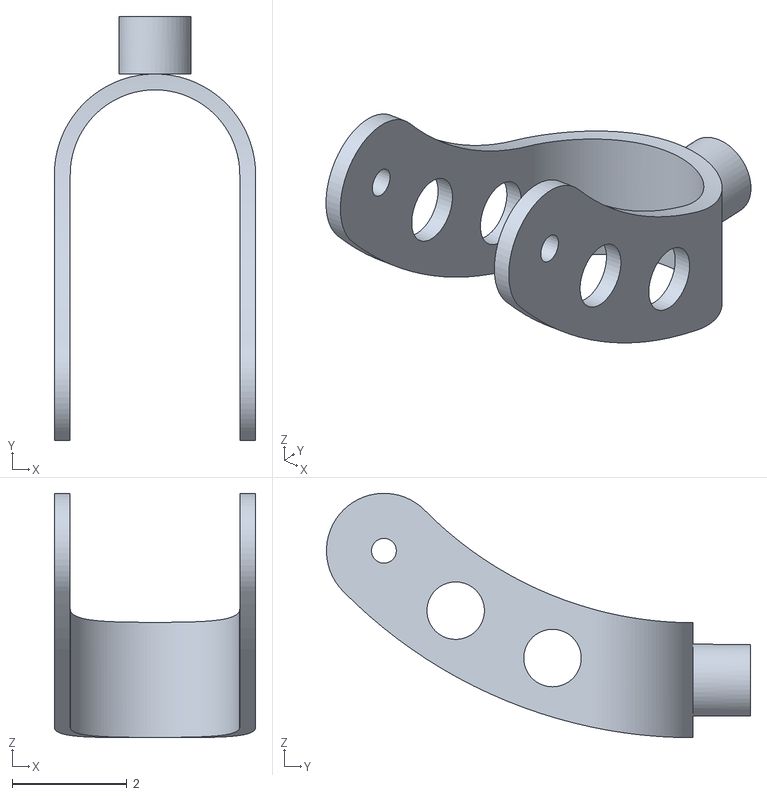
[picture p137: CAD file, 2012-07-24]
urdf/fixed_frame_no_arm/caster_ipt_ca03a3d7.stl
3.50 x 7.37 x 4.25
