evenator/masters/urdf/gripper_iam_ad0c01b6.STL

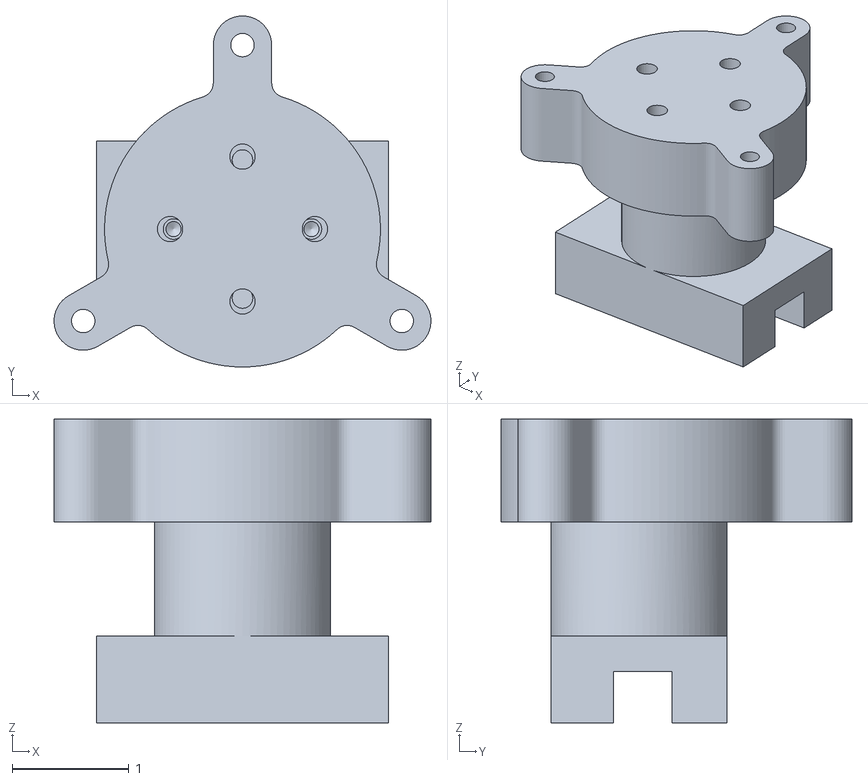
[picture p138: CAD file, 2013-02-24]
urdf/gripper_iam_ad0c01b6.STL
3.23 x 3.01 x 2.60
