evenator/masters/Mechanical/IRB120/Simmechanics/IRB120_Link2_rev0_iam_90725b7e.STL

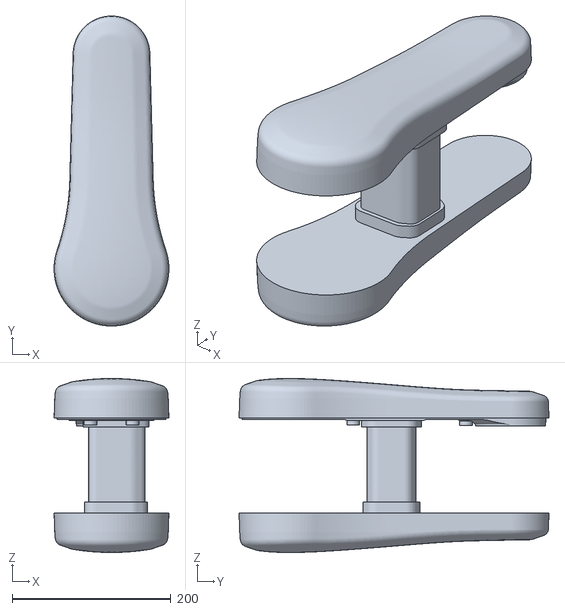
[picture p139: CAD file, 2012-02-10]
Mechanical/IRB120/Simmechanics/IRB120_Link2_rev0_iam_90725b7e.STL
144.9 x 390.8 x 219.4
