evenator/masters/Mechanical/Pneumatics/step/compressor.stp

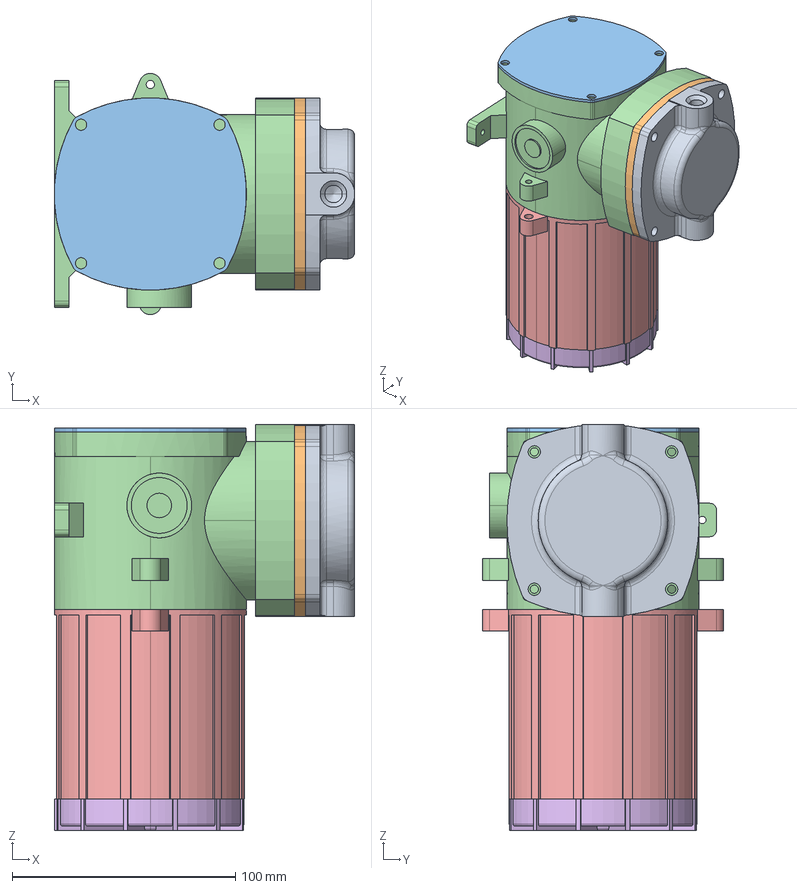
[picture p140: CAD file, 2012-07-17]
Mechanical/Pneumatics/step/compressor.stp
134.5 x 108.0 x 181.8 mm
CompressorHead
CompressorValve
CompressorPlate
CompressorBody
compressormotorbody
compressormotorcap
