evenator/masters/urdf/acrylic kinect bracket_iam_e501fe13.STL

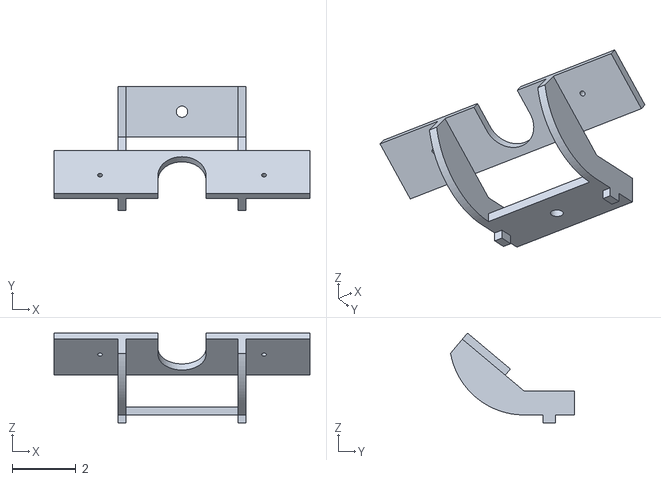
[picture p141: CAD file, 2013-02-24]
urdf/acrylic kinect bracket_iam_e501fe13.STL
8.00 x 3.87 x 2.81
