evenator/masters/urdf/fixed_frame_no_arm/wheel_ipt_982fa4fe.stl

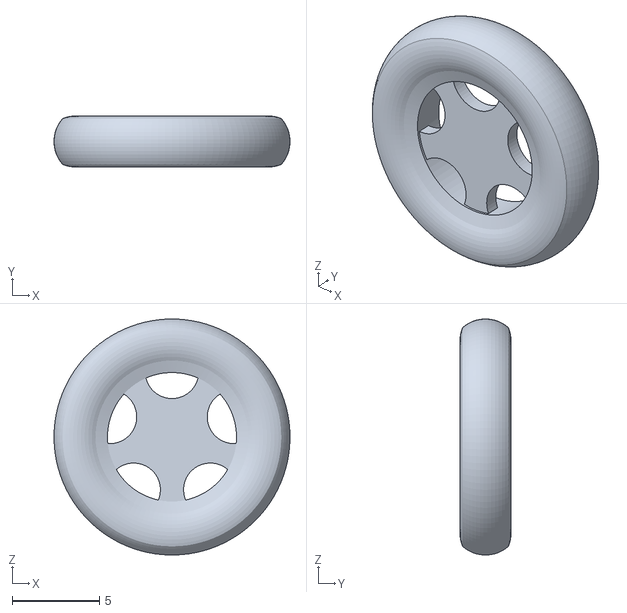
[picture p142: CAD file, 2012-07-24]
urdf/fixed_frame_no_arm/wheel_ipt_982fa4fe.stl
13.5 x 2.93 x 13.5
