evenator/masters/urdf/gripper/gripper_iam_ad0c01b6.STL

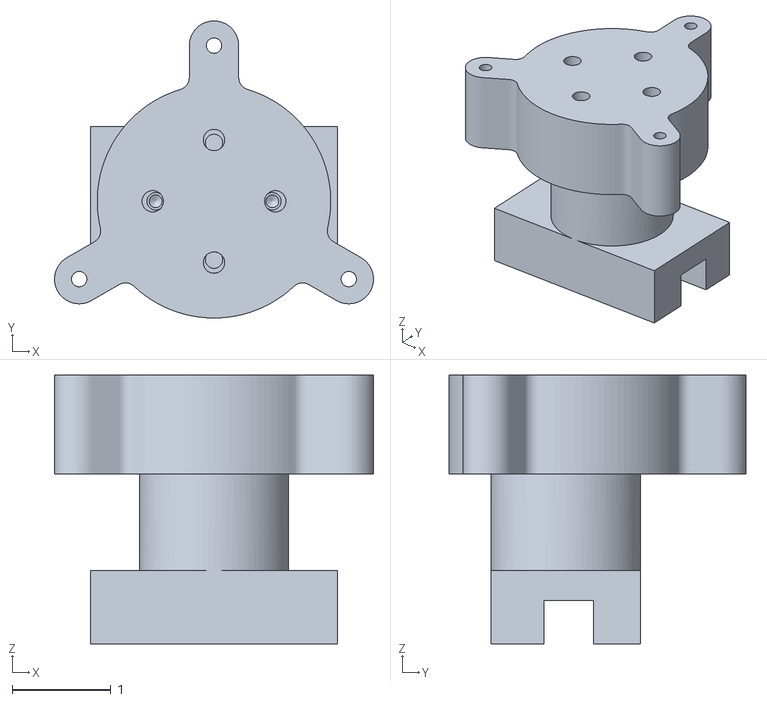
[picture p143: CAD file, 2012-11-30]
urdf/gripper/gripper_iam_ad0c01b6.STL
3.23 x 3.01 x 2.72
