evenator/masters/Mechanical/IRB120/Simmechanics/IRB120_Base_rev0_iam_38446303.STL

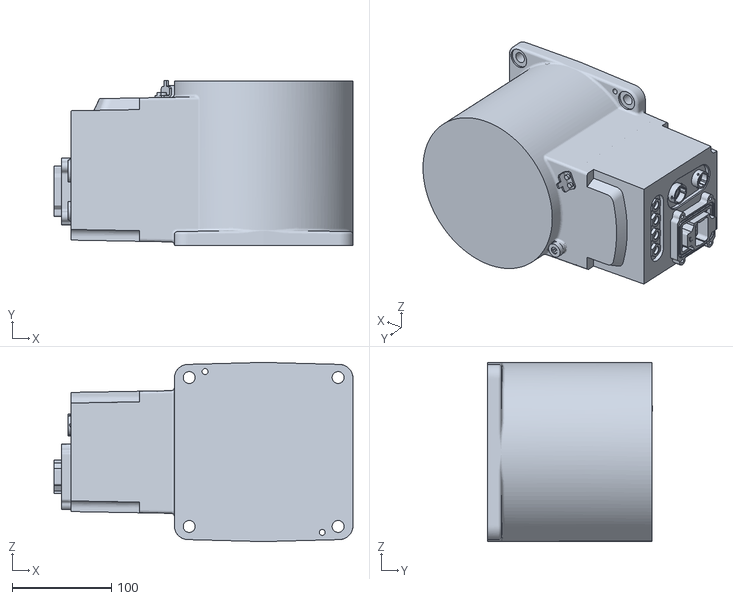
[picture p144: CAD file, 2012-02-10]
Mechanical/IRB120/Simmechanics/IRB120_Base_rev0_iam_38446303.STL
301.2 x 166.3 x 180.5
