evenator/masters/Mechanical/Pneumatics/step/pressuregage.stp

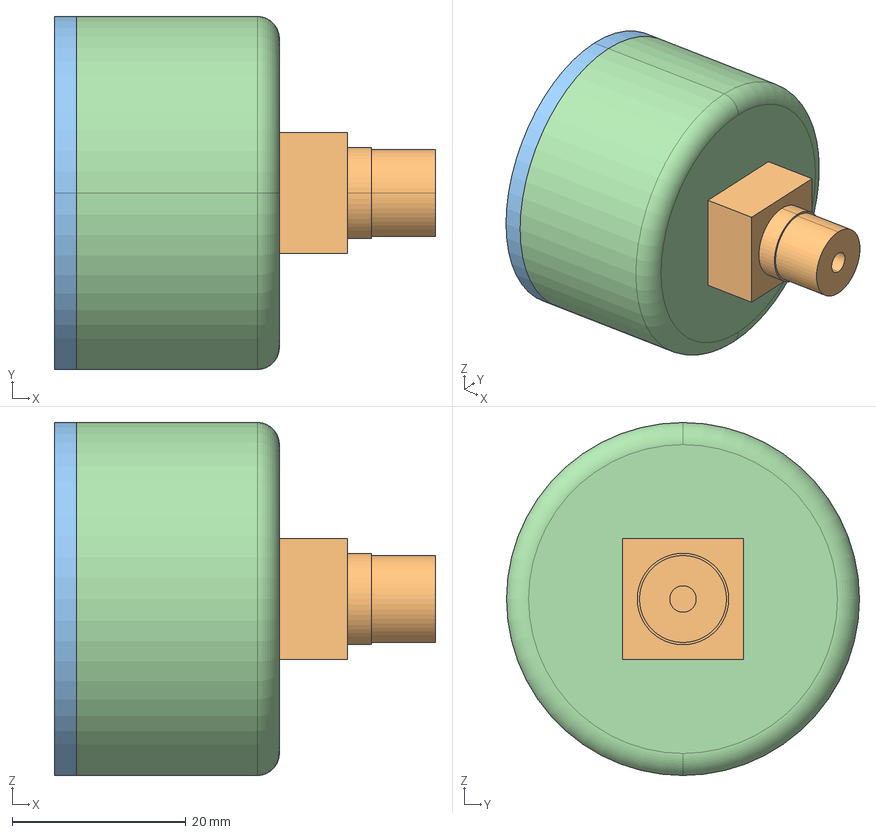
[picture p145: CAD file, 2012-07-17]
Mechanical/Pneumatics/step/pressuregage.stp
43.9 x 40.6 x 40.6 mm
pressuregage1
pressuregage2
pressuregage3
pressuregage4
