evenator/masters/urdf/bin_ipt_175fe0bc.STL

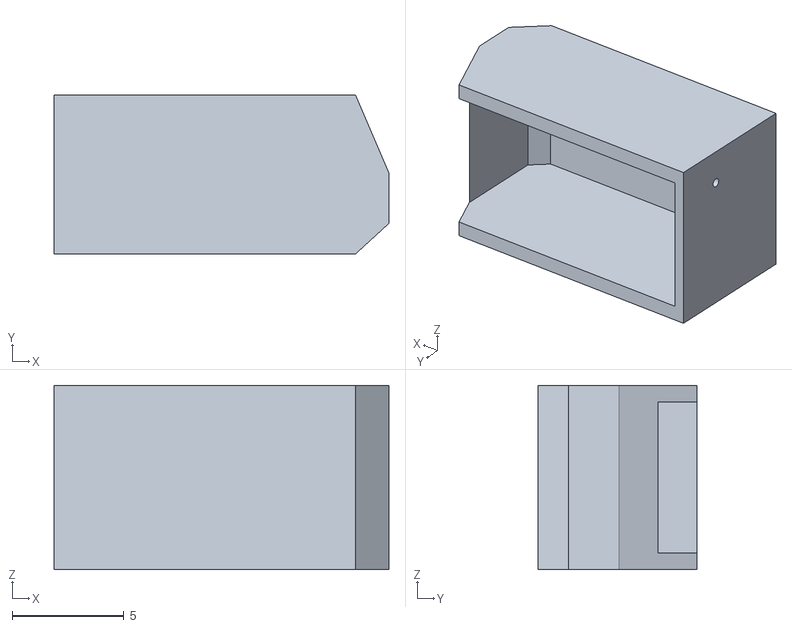
[picture p146: CAD file, 2012-11-30]
urdf/bin_ipt_175fe0bc.STL
15.0 x 7.12 x 8.25
