evenator/masters/urdf/fixed_frame/frame_ipt_29593391.STL

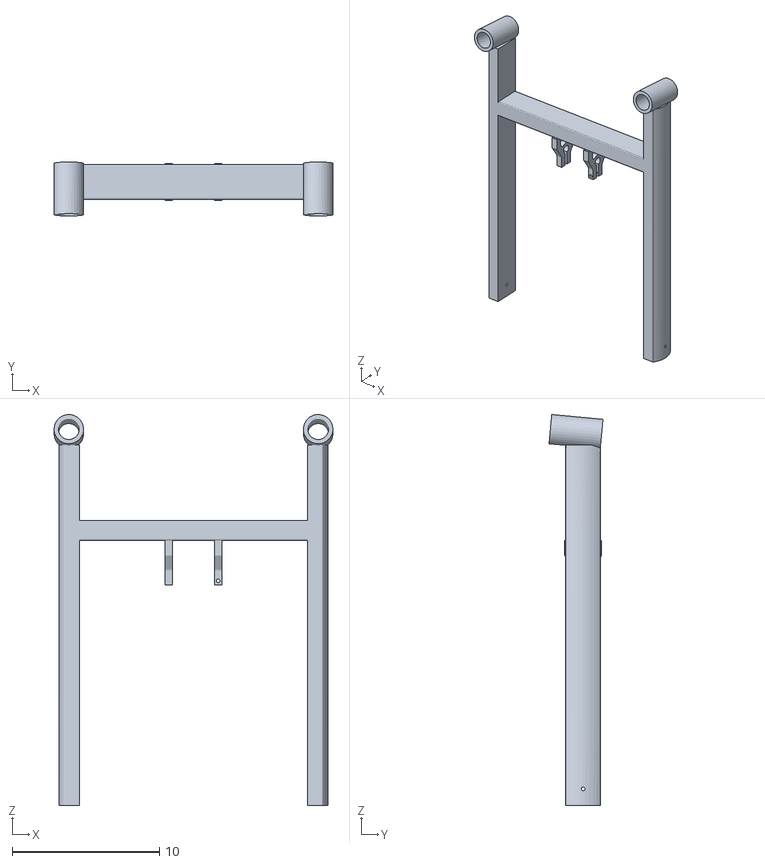
[picture p147: CAD file, 2012-07-24]
urdf/fixed_frame/frame_ipt_29593391.STL
18.9 x 3.67 x 26.6
