evenator/masters/urdf/fixed_frame_no_arm/short frame bracket_ipt_f5a4f28d.stl

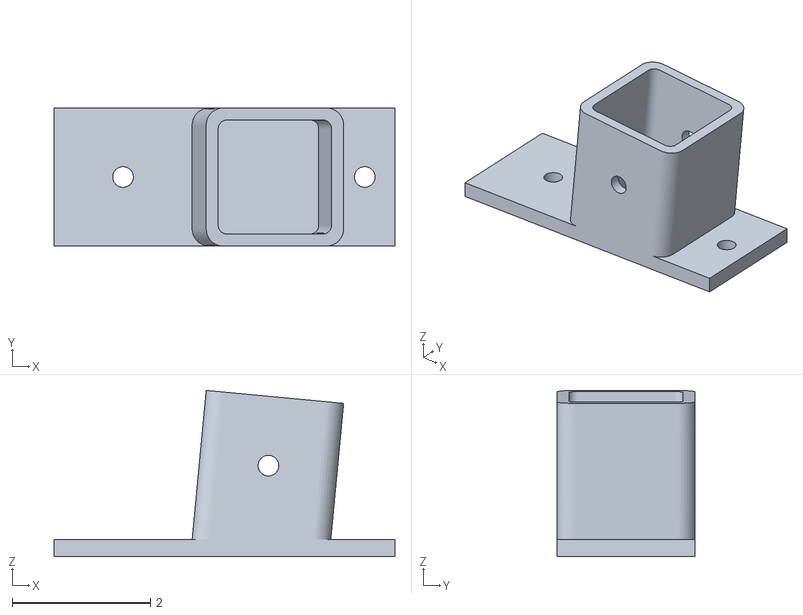
[picture p148: CAD file, 2012-05-26]
urdf/fixed_frame_no_arm/short frame bracket_ipt_f5a4f28d.stl
4.94 x 2.00 x 2.41
