evenator/masters/Mechanical/IRB120/Simmechanics/IRB120_Link3_rev0_iam_86ced70a.STL

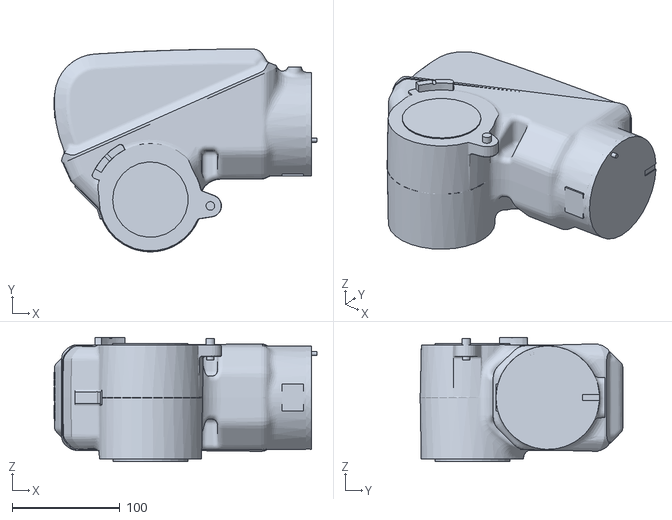
[picture p149: CAD file, 2012-02-10]
Mechanical/IRB120/Simmechanics/IRB120_Link3_rev0_iam_86ced70a.STL
244.0 x 188.1 x 115.5
