evenator/masters/Mechanical/Pneumatics/step/pressureswitch.stp

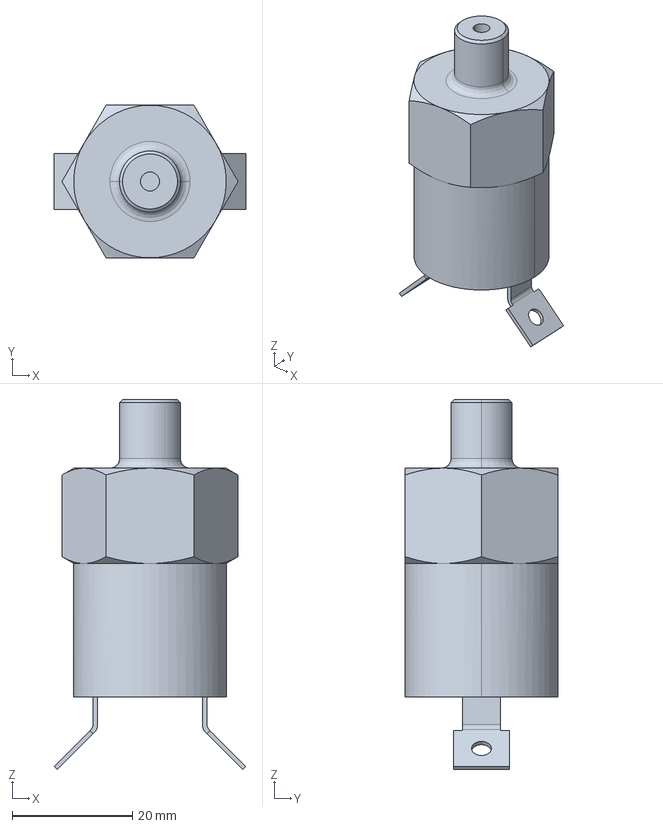
[picture p150: CAD file, 2012-07-17]
Mechanical/Pneumatics/step/pressureswitch.stp
31.9 x 25.4 x 61.6 mm
