evenator/masters/urdf/fixed_frame/battery rails_ipt_62ca575f.STL

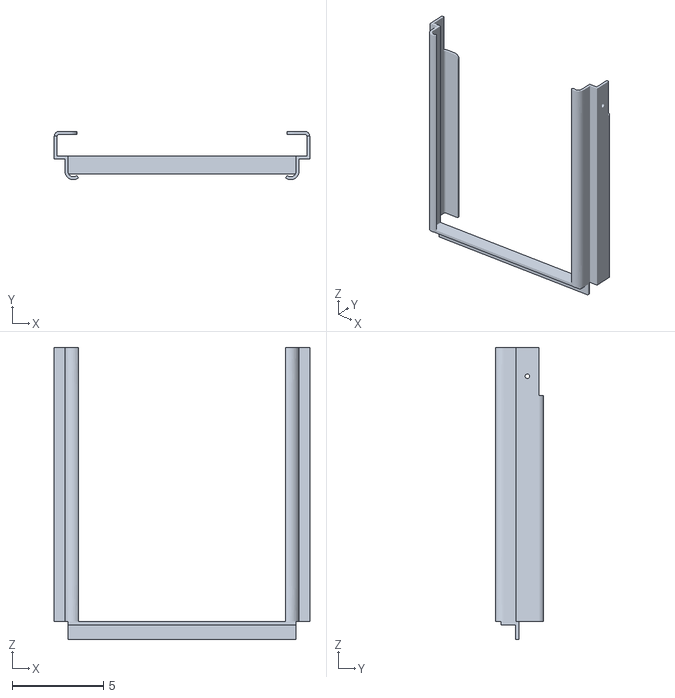
[picture p151: CAD file, 2012-07-24]
urdf/fixed_frame/battery rails_ipt_62ca575f.STL
14.0 x 2.65 x 16.0
