evenator/masters/urdf/fixed_frame_no_arm/Breaker_iam_746c8f85.stl

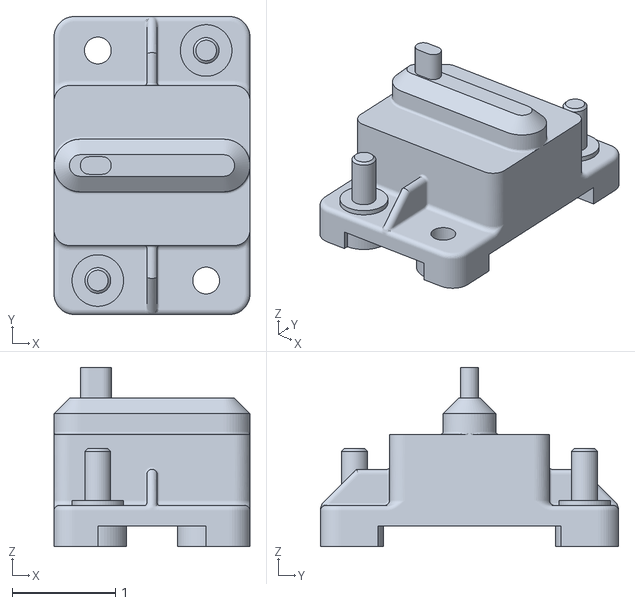
[picture p152: CAD file, 2012-05-26]
urdf/fixed_frame_no_arm/Breaker_iam_746c8f85.stl
1.90 x 2.89 x 1.74
