evenator/masters/urdf/frame_solid_iam_8d469021.STL

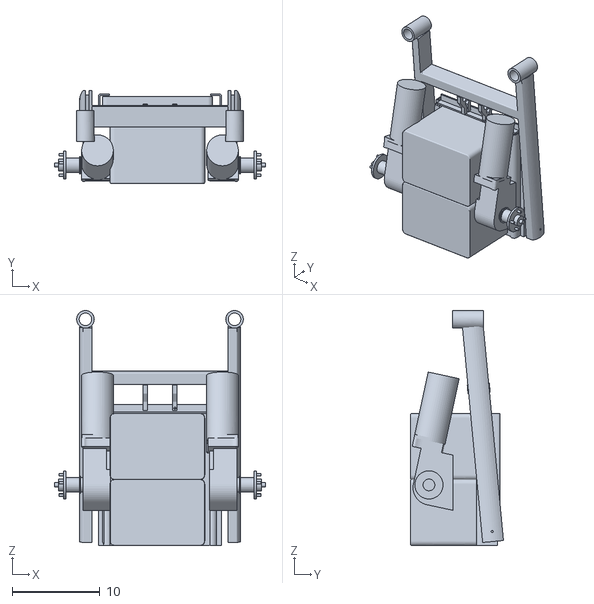
[picture p153: CAD file, 2012-10-26]
urdf/frame_solid_iam_8d469021.STL
24.0 x 10.6 x 26.7
