evenator/masters/Mechanical/IRB120/Simmechanics/IRB120_Link5_rev0_iam_8f44ede8.STL

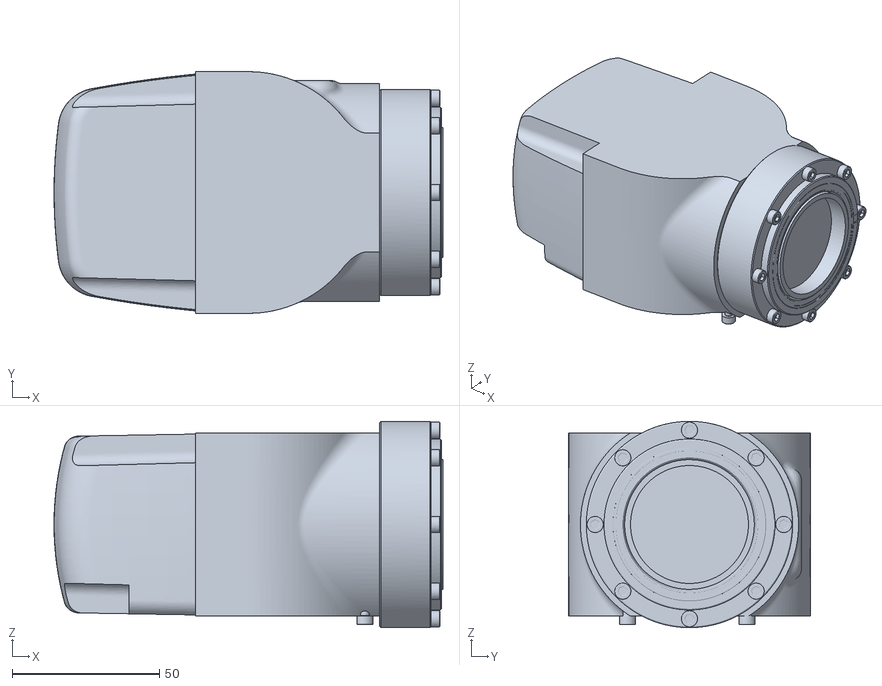
[picture p154: CAD file, 2012-02-10]
Mechanical/IRB120/Simmechanics/IRB120_Link5_rev0_iam_8f44ede8.STL
132.0 x 82.0 x 70.0
