evenator/masters/urdf/al_frame_iam_3826baa4.STL

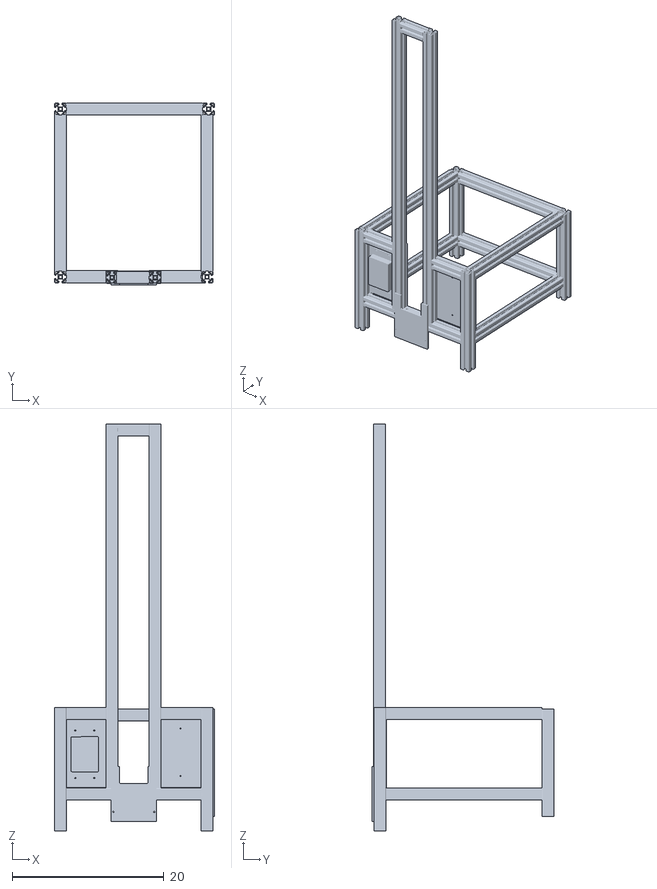
[picture p155: CAD file, 2012-08-09]
urdf/al_frame_iam_3826baa4.STL
21.1 x 23.9 x 53.7
