evenator/masters/urdf/fixed_frame/motor_MIR_ipt_80c03f9e.STL

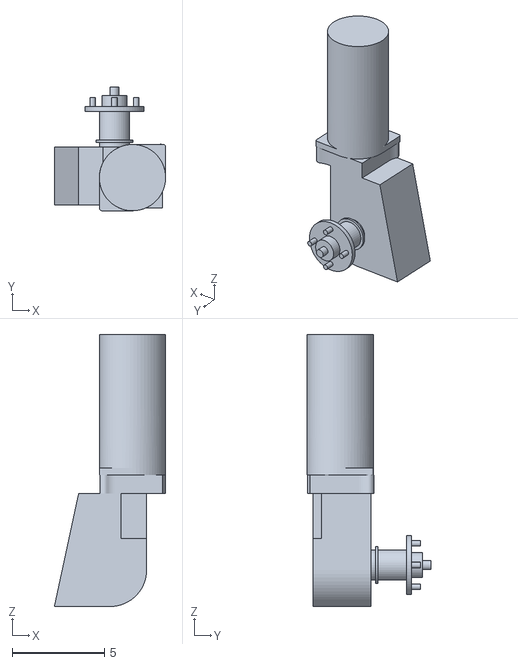
[picture p156: CAD file, 2012-07-24]
urdf/fixed_frame/motor_MIR_ipt_80c03f9e.STL
6.04 x 6.71 x 14.8
