evenator/masters/urdf/fixed_frame_no_arm/Spike H_iam_f19c9874.stl

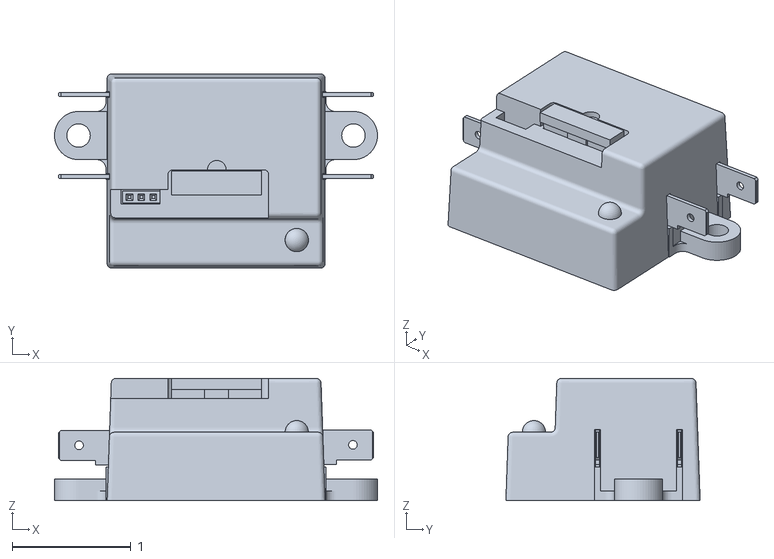
[picture p157: CAD file, 2012-05-26]
urdf/fixed_frame_no_arm/Spike H_iam_f19c9874.stl
2.72 x 1.63 x 1.03
