evenator/masters/Mechanical/IRB120/Simmechanics/IRB120_Link6_rev0_ipt_8026fdc3.STL

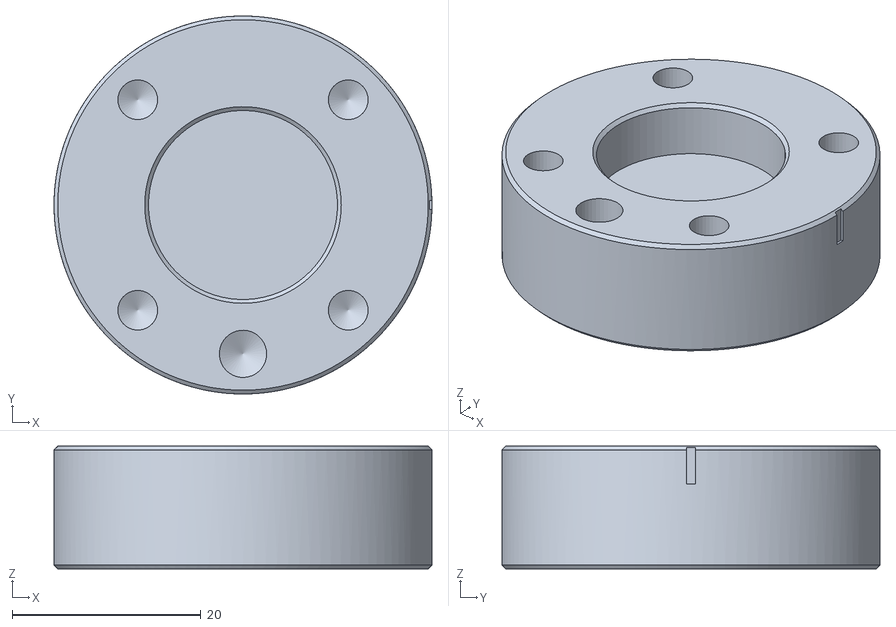
[picture p158: CAD file, 2012-02-10]
Mechanical/IRB120/Simmechanics/IRB120_Link6_rev0_ipt_8026fdc3.STL
40.0 x 40.0 x 13.0
