evenator/masters/urdf/battery_ipt_8c19ab2.STL

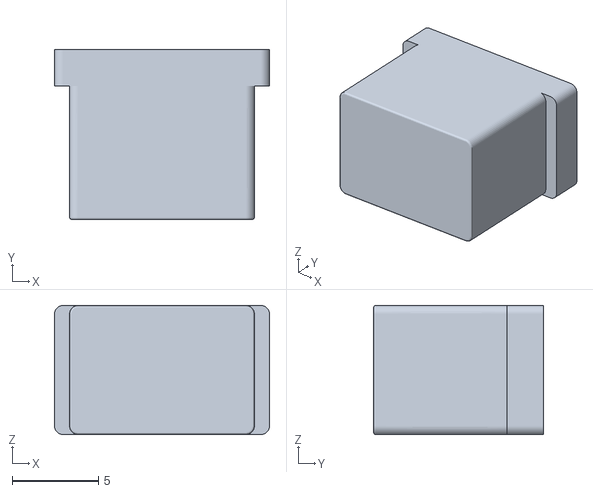
[picture p159: CAD file, 2012-07-24]
urdf/battery_ipt_8c19ab2.STL
12.5 x 9.88 x 7.50
