evenator/masters/urdf/fixed_frame_no_arm/SICK LMS291_ipt_2ad4e53c.stl

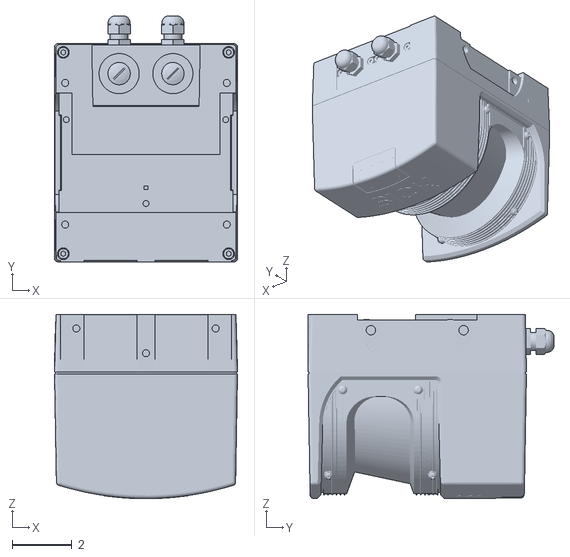
[picture p160: CAD file, 2012-05-26]
urdf/fixed_frame_no_arm/SICK LMS291_ipt_2ad4e53c.stl
6.10 x 8.20 x 6.15
