evenator/masters/urdf/fixed_frame/IRB120_Link3_rev0_iam_86ced70a.STL

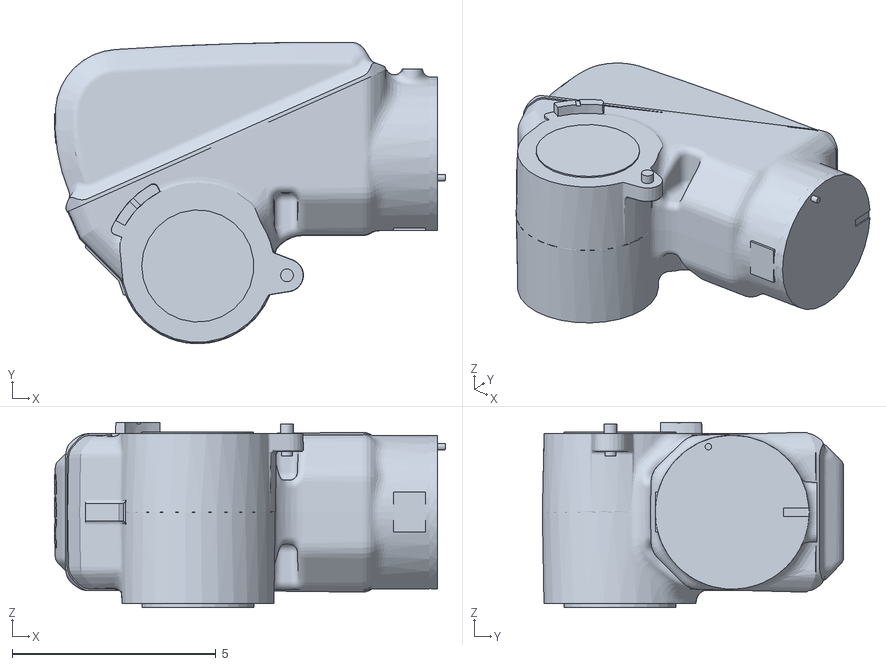
[picture p161: CAD file, 2012-05-26]
urdf/fixed_frame/IRB120_Link3_rev0_iam_86ced70a.STL
9.61 x 7.40 x 4.55
