evenator/masters/urdf/fixed_frame_no_arm/compressor_iam_e870b89.stl

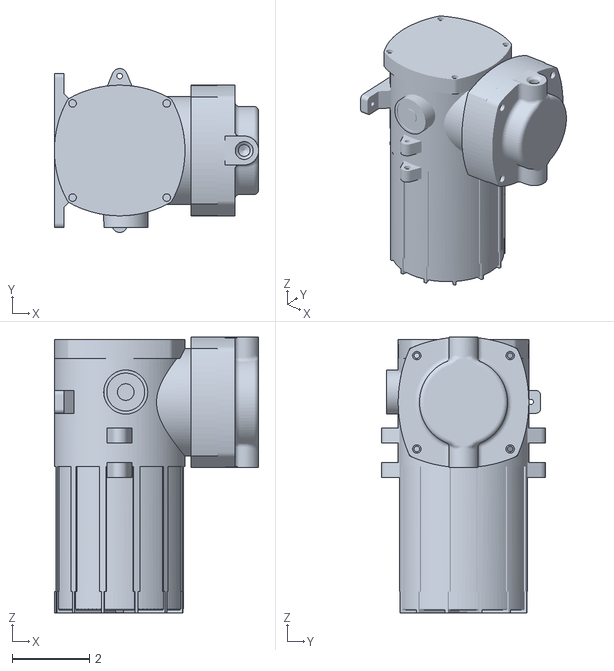
[picture p162: CAD file, 2012-05-26]
urdf/fixed_frame_no_arm/compressor_iam_e870b89.stl
5.30 x 4.25 x 7.16
