evenator/masters/urdf/front right plate_ipt_a8be7025.STL

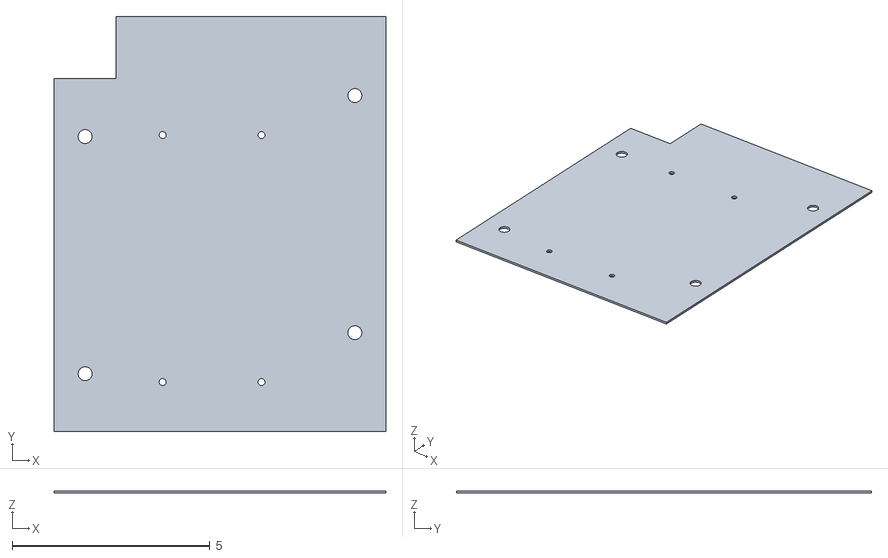
[picture p163: CAD file, 2012-05-26]
urdf/front right plate_ipt_a8be7025.STL
8.40 x 10.5 x 0.0625
