evenator/masters/urdf/fixed_frame/IRB120_Link4_rev0_iam_467bed4b.STL

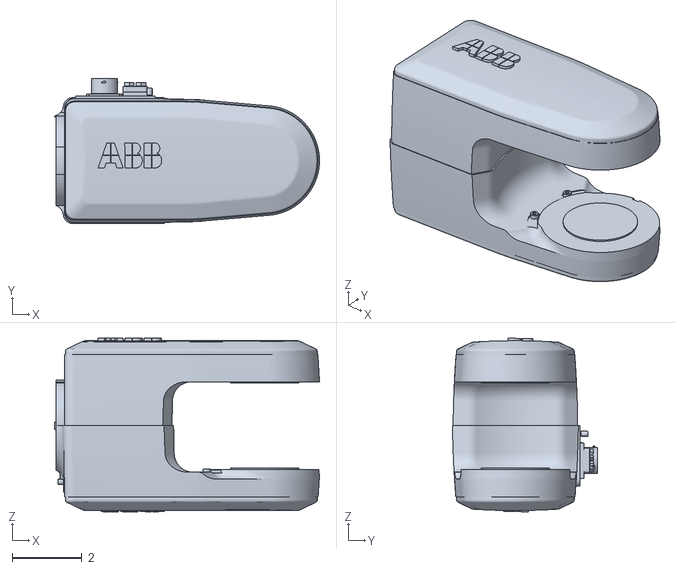
[picture p164: CAD file, 2012-05-26]
urdf/fixed_frame/IRB120_Link4_rev0_iam_467bed4b.STL
7.62 x 4.17 x 5.00
