evenator/masters/urdf/fixed_frame_no_arm/frame bracket_ipt_f5a4f28d.stl

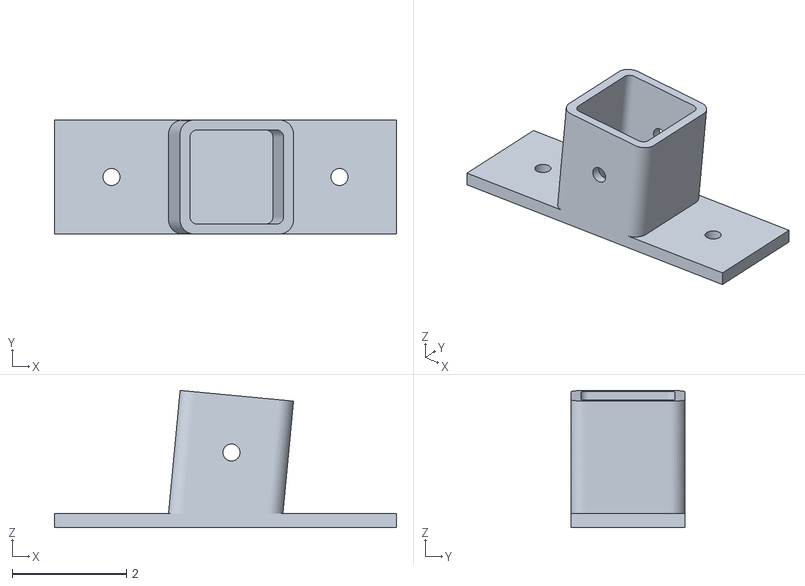
[picture p165: CAD file, 2012-05-26]
urdf/fixed_frame_no_arm/frame bracket_ipt_f5a4f28d.stl
6.00 x 2.00 x 2.41
