evenator/masters/urdf/fixed_frame/IRB120_Base_rev0_iam_38446303.STL

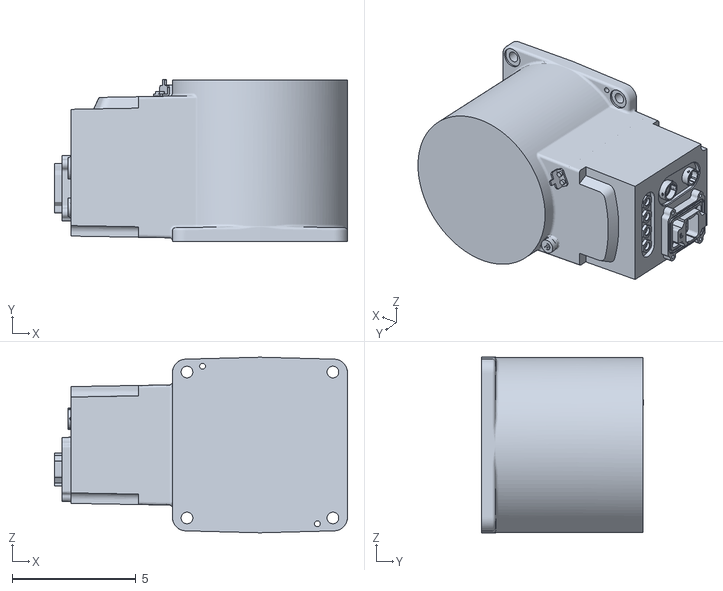
[picture p166: CAD file, 2012-05-26]
urdf/fixed_frame/IRB120_Base_rev0_iam_38446303.STL
11.9 x 6.55 x 7.11
