evenator/masters/urdf/fixed_frame_no_arm/router keepout_ipt_2b3ba7b4.stl

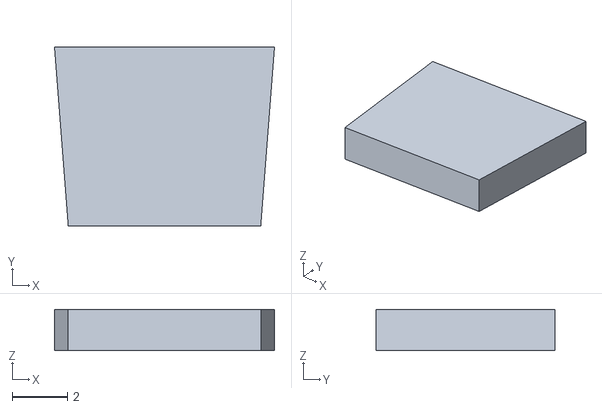
[picture p167: CAD file, 2012-05-26]
urdf/fixed_frame_no_arm/router keepout_ipt_2b3ba7b4.stl
8.00 x 6.50 x 1.50
