evenator/masters/urdf/lower vertical rail_ipt_926bd022.STL

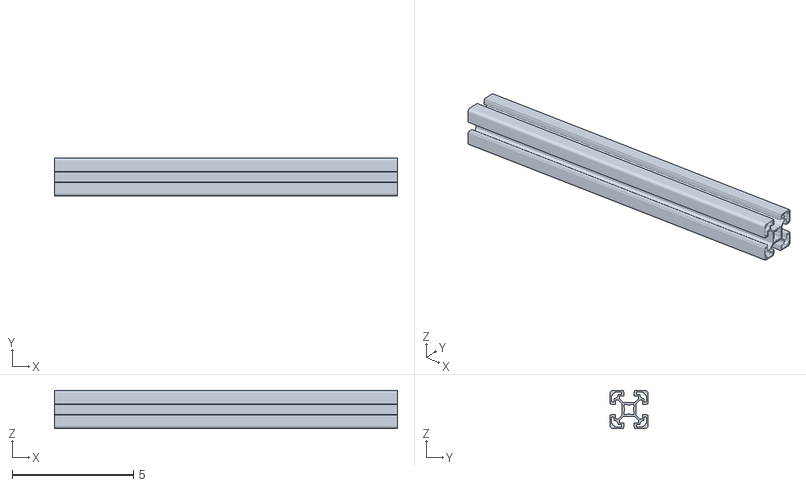
[picture p168: CAD file, 2012-05-26]
urdf/lower vertical rail_ipt_926bd022.STL
14.2 x 1.57 x 1.57
