evenator/masters/urdf/fixed_frame/IRB120_Link5_rev0_iam_8f44ede8.STL

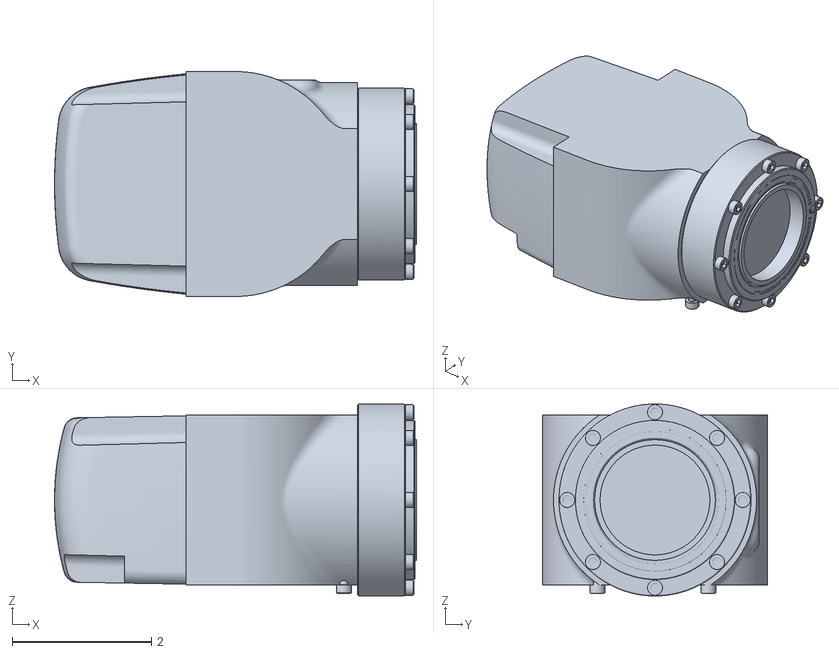
[picture p169: CAD file, 2012-05-26]
urdf/fixed_frame/IRB120_Link5_rev0_iam_8f44ede8.STL
5.20 x 3.23 x 2.76
