evenator/masters/urdf/fixed_frame_no_arm/top plate_ipt_9041f1eb.stl

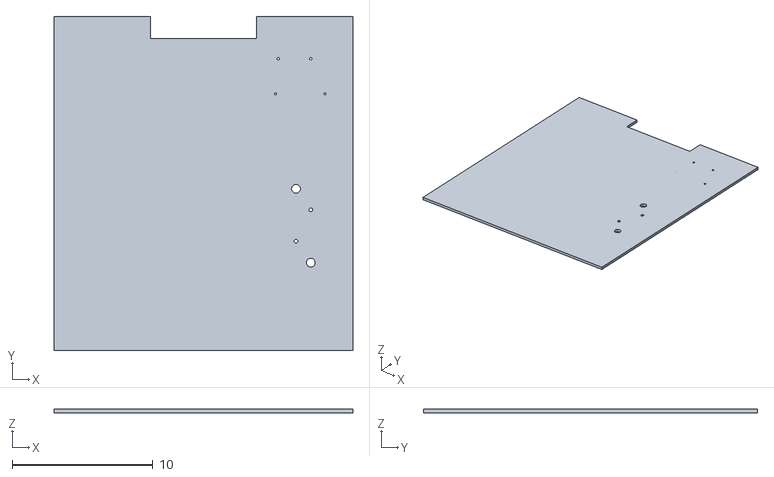
[picture p170: CAD file, 2012-05-26]
urdf/fixed_frame_no_arm/top plate_ipt_9041f1eb.stl
21.2 x 23.8 x 0.25
