evenator/masters/urdf/front upright_ipt_926bd022.STL

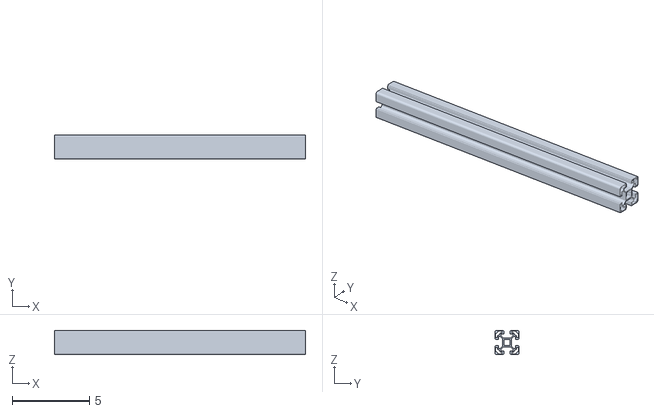
[picture p171: CAD file, 2012-05-26]
urdf/front upright_ipt_926bd022.STL
16.2 x 1.57 x 1.57
