evenator/masters/urdf/arm rail_ipt_926bd022.STL

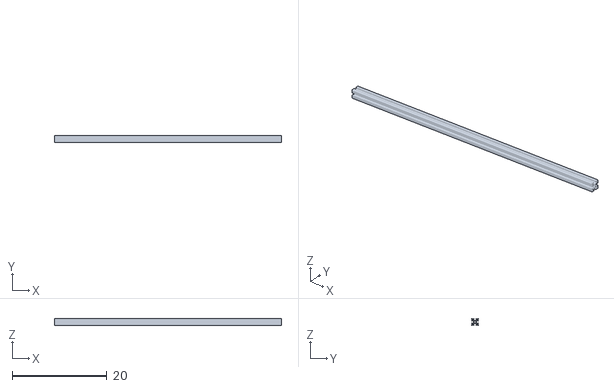
[picture p172: CAD file, 2012-05-26]
urdf/arm rail_ipt_926bd022.STL
48.0 x 1.57 x 1.57
