evenator/masters/urdf/fixed_frame/IRB120_Link6_rev0_ipt_8026fdc3.STL

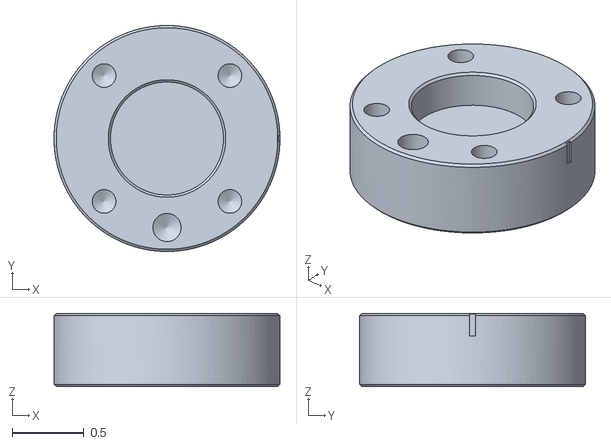
[picture p173: CAD file, 2012-05-26]
urdf/fixed_frame/IRB120_Link6_rev0_ipt_8026fdc3.STL
1.57 x 1.57 x 0.512
