evenator/masters/urdf/fixed_frame_no_arm/back frame plate_ipt_475e4947.stl

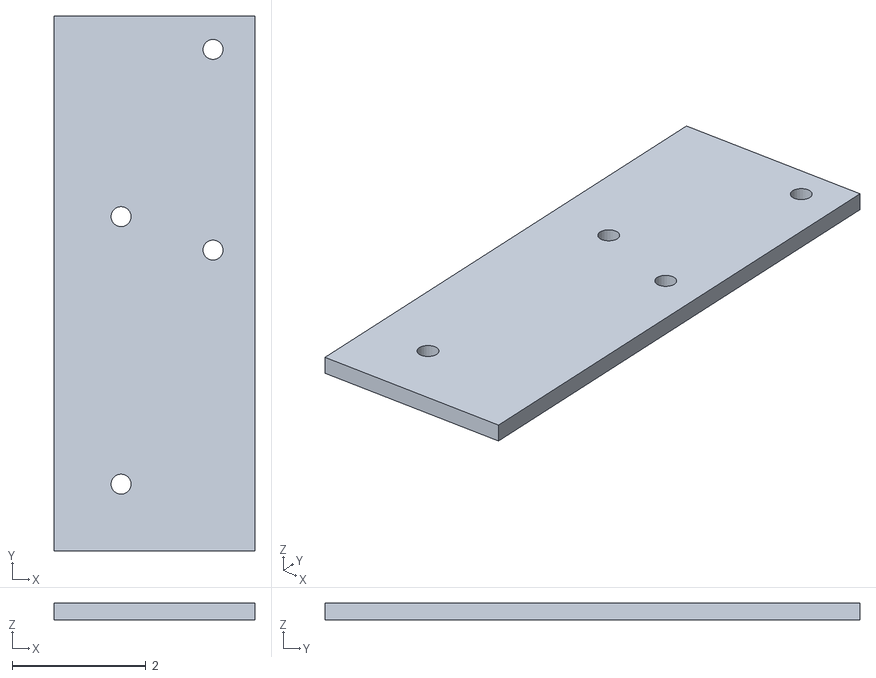
[picture p174: CAD file, 2012-05-26]
urdf/fixed_frame_no_arm/back frame plate_ipt_475e4947.stl
3.00 x 8.00 x 0.25
