evenator/masters/urdf/fixed_frame/IRB120_Link2_rev0_iam_90725b7e.STL

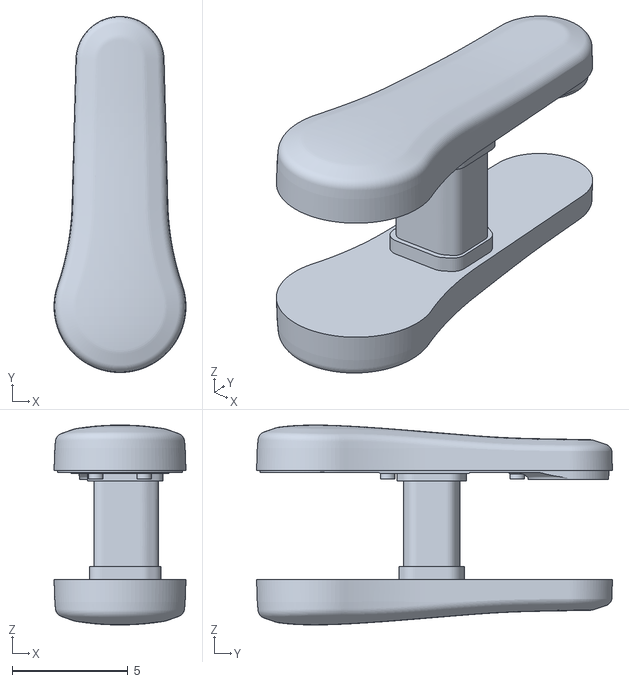
[picture p175: CAD file, 2012-05-26]
urdf/fixed_frame/IRB120_Link2_rev0_iam_90725b7e.STL
5.70 x 15.4 x 8.64
