evenator/masters/urdf/fixed_frame_no_arm/IRC5_Compact_ipt_c844072c.stl

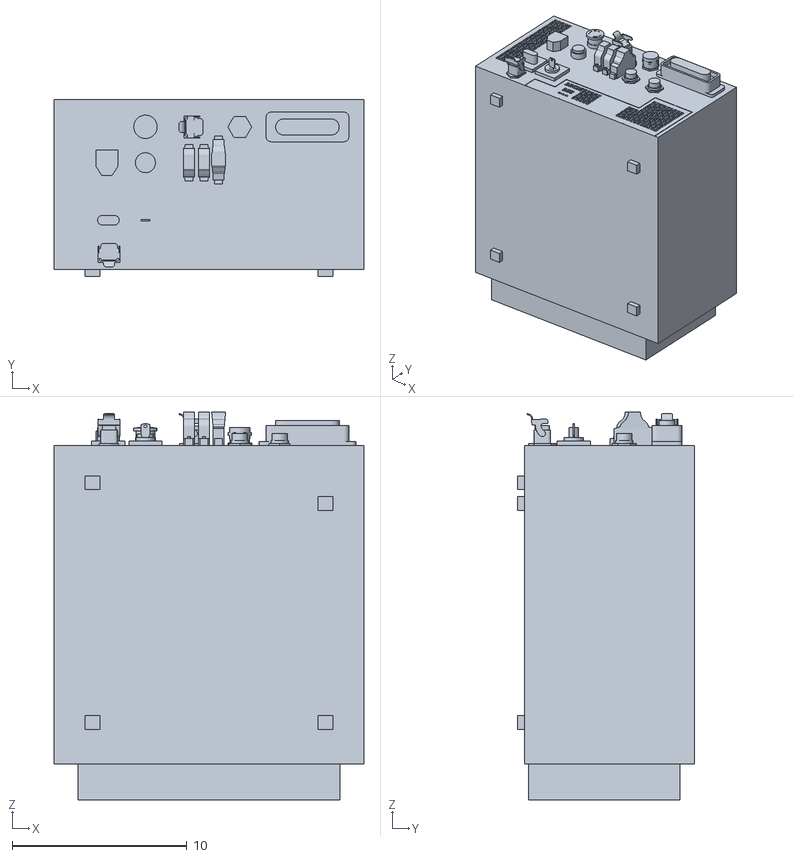
[picture p176: CAD file, 2012-05-26]
urdf/fixed_frame_no_arm/IRC5_Compact_ipt_c844072c.stl
17.7 x 10.1 x 22.2
