evenator/masters/urdf/LIDAR Bracket_ipt_795304a8.STL

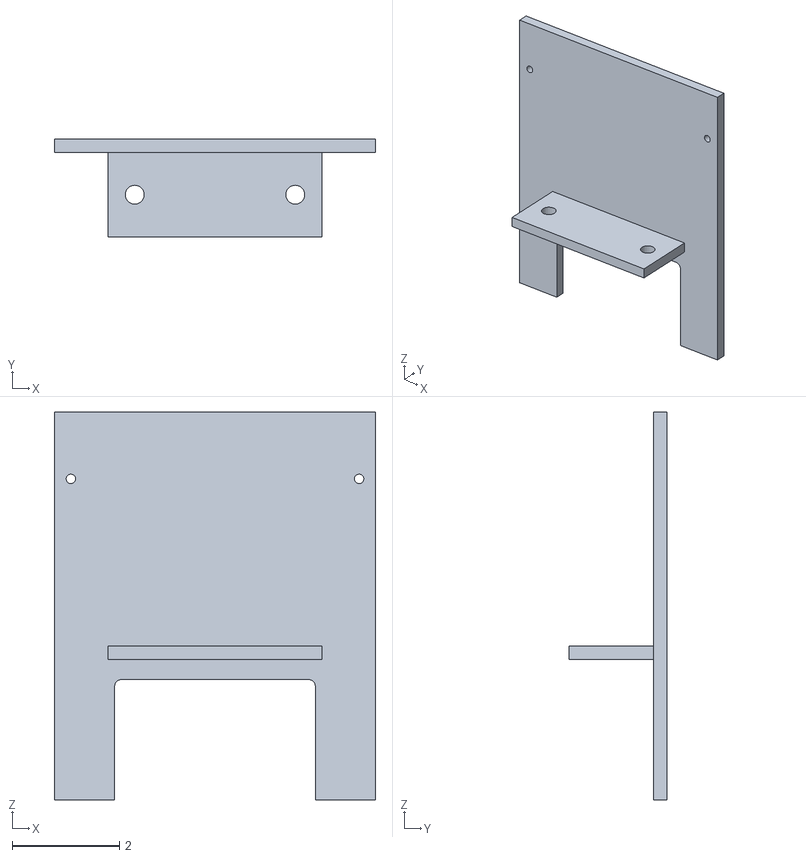
[picture p177: CAD file, 2012-05-26]
urdf/LIDAR Bracket_ipt_795304a8.STL
6.00 x 1.82 x 7.25
