evenator/masters/urdf/aim rail cross brace_ipt_926bd022.STL

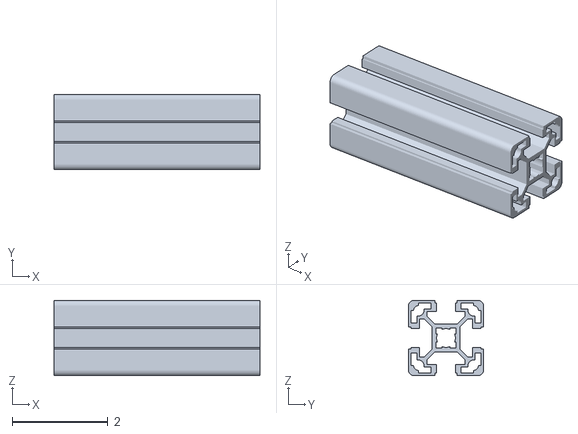
[picture p178: CAD file, 2012-05-26]
urdf/aim rail cross brace_ipt_926bd022.STL
4.31 x 1.57 x 1.57
