evenator/masters/urdf/fixed_frame/IRB120_Link1_rev0_iam_3fe6e7e5.STL

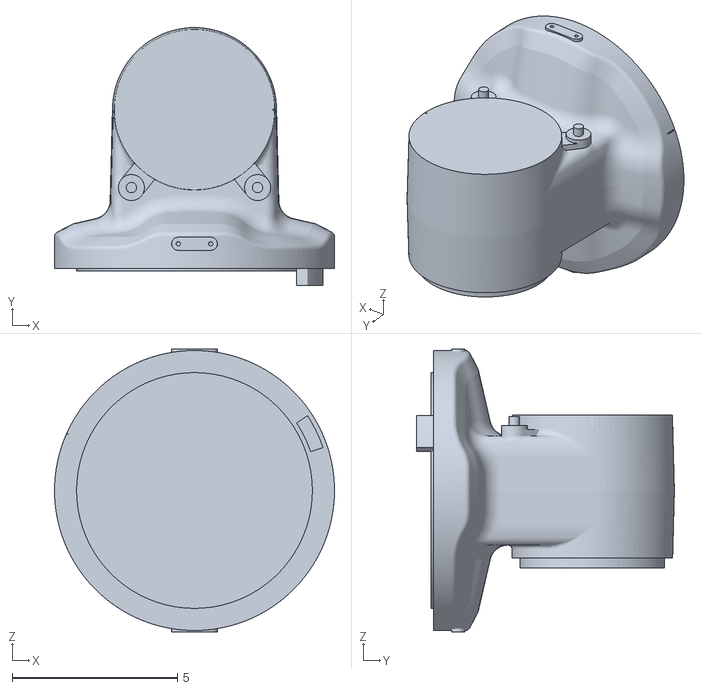
[picture p179: CAD file, 2012-05-26]
urdf/fixed_frame/IRB120_Link1_rev0_iam_3fe6e7e5.STL
8.46 x 7.80 x 8.54
