evenator/masters/urdf/fixed_frame_no_arm/PC_ipt_a7ade237.stl

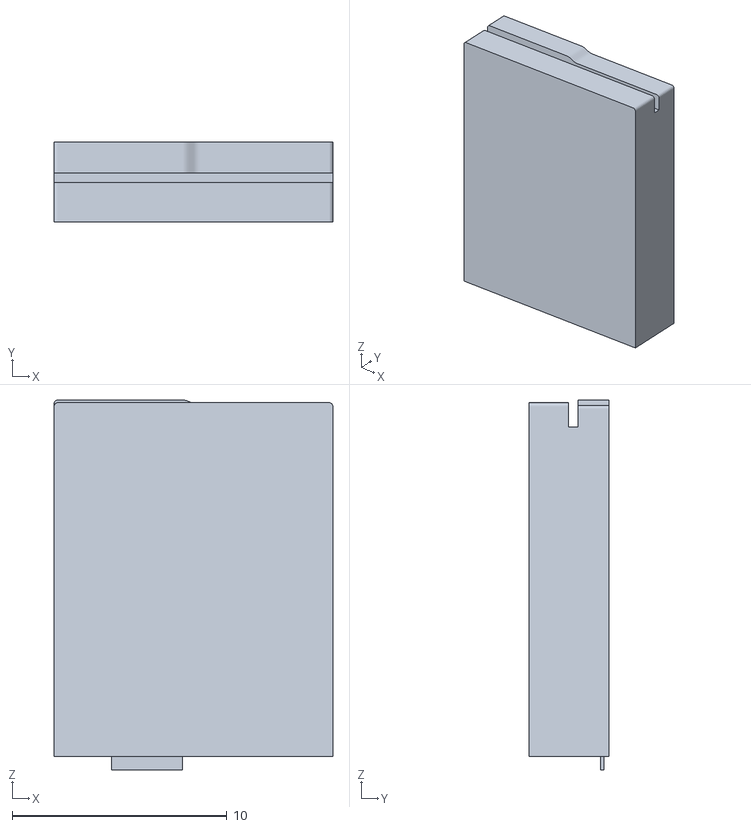
[picture p180: CAD file, 2012-05-26]
urdf/fixed_frame_no_arm/PC_ipt_a7ade237.stl
13.0 x 3.75 x 17.2
