evenator/masters/urdf/fixed_frame_no_arm/front frame plate_ipt_3e5bfe16.stl

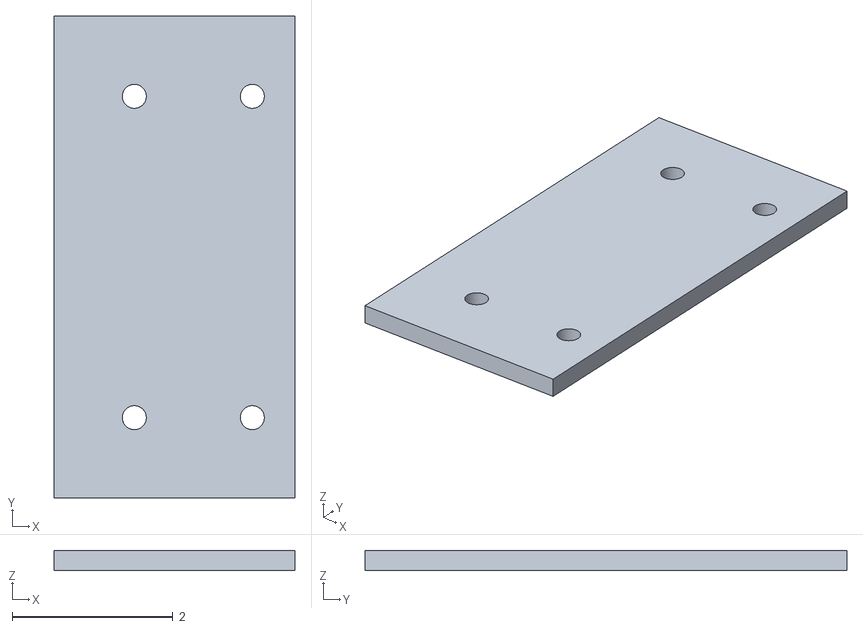
[picture p181: CAD file, 2012-05-26]
urdf/fixed_frame_no_arm/front frame plate_ipt_3e5bfe16.stl
3.00 x 6.00 x 0.25
