evenator/masters/urdf/LIDAR PSU_ipt_2888cf41.STL

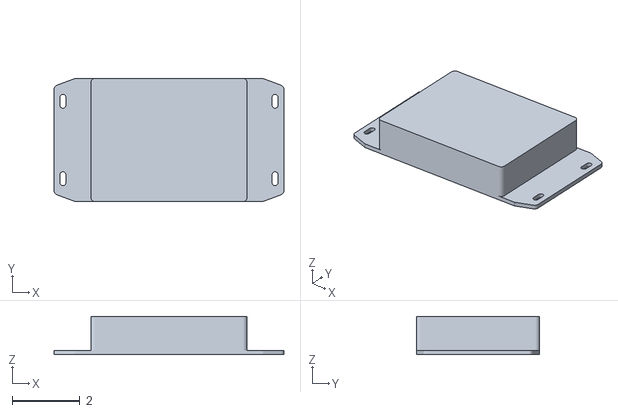
[picture p182: CAD file, 2012-05-26]
urdf/LIDAR PSU_ipt_2888cf41.STL
6.80 x 3.64 x 1.12
