evenator/masters/urdf/lower front rail_ipt_926bd022.STL

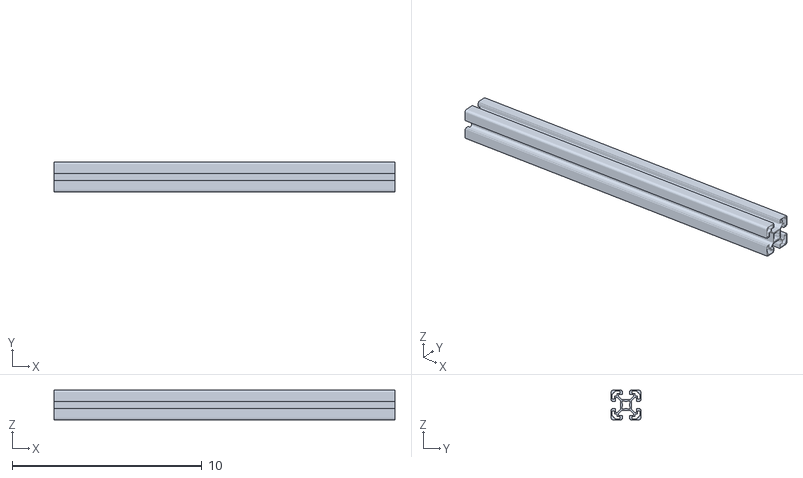
[picture p183: CAD file, 2012-05-26]
urdf/lower front rail_ipt_926bd022.STL
18.0 x 1.57 x 1.57
