evenator/masters/urdf/lower side rail_ipt_926bd022.STL

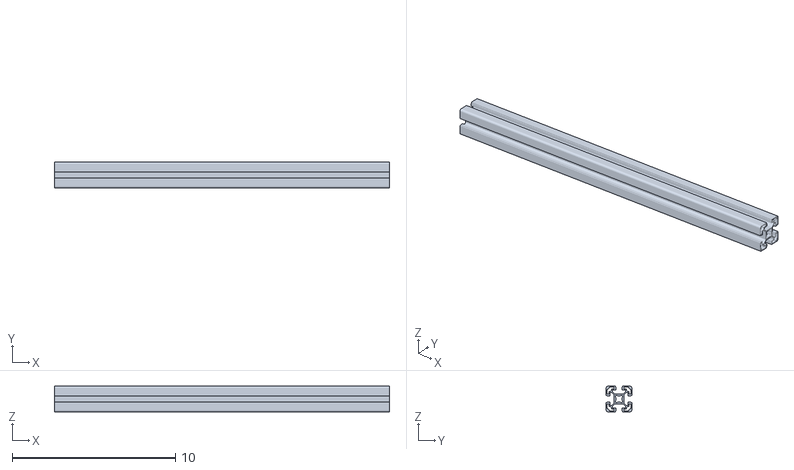
[picture p184: CAD file, 2012-05-26]
urdf/lower side rail_ipt_926bd022.STL
20.6 x 1.57 x 1.57
