evenator/masters/urdf/front top side rail_ipt_926bd022.STL

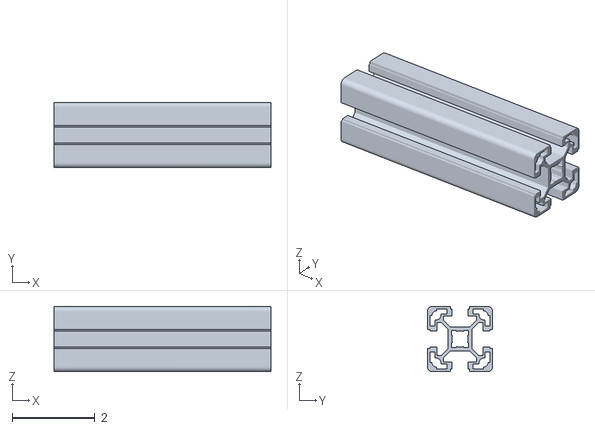
[picture p185: CAD file, 2012-05-26]
urdf/front top side rail_ipt_926bd022.STL
5.25 x 1.57 x 1.57
