evenator/masters/urdf/Kinect_ipt_94e5d325.STL

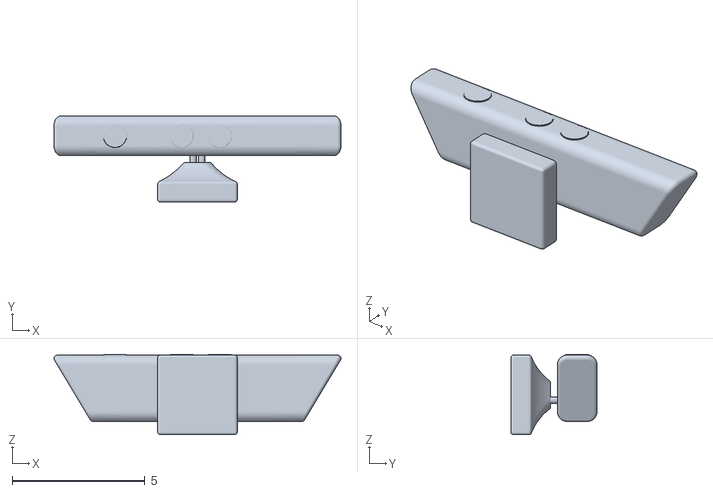
[picture p186: CAD file, 2012-05-26]
urdf/Kinect_ipt_94e5d325.STL
10.8 x 3.25 x 3.03
