evenator/masters/(list of files, cad)

Other CAD files:
Mechanical/Gripper/gripper manufacturing layout.igs
urdf/gripper/gripper jaw_ipt_2c7c957b.STL
urdf/fixed_frame/motor_ipt_8185475f.STL
urdf/front left plate_ipt_a8be7025.STL
Mechanical/13.8V Supply/supply-13.8.ipt
Mechanical/Breaker/Breaker Body.ipt
Mechanical/Breaker/Breaker Post.ipt
Mechanical/Breaker/Breaker.iam
Mechanical/Cap/Cap.ipt
Mechanical/DIN Terminal/12v terminal.ipt
Mechanical/DIN Terminal/24v terminal.ipt
Mechanical/DIN Terminal/DIN Block.iam
Mechanical/DIN Terminal/gnd terminal.ipt
Mechanical/Frame/Bosch 40 x 40 strut profile.ipt
Mechanical/Frame/aim rail cross brace.ipt
Mechanical/Frame/arm rail.ipt
Mechanical/Frame/back frame plate.ipt
Mechanical/Frame/base plate.ipt
Mechanical/Frame/frame bracket.ipt
Mechanical/Frame/front frame plate.ipt
Mechanical/Frame/front left plate.ipt
Mechanical/Frame/front right plate.ipt
Mechanical/Frame/front top side rail.ipt
Mechanical/Frame/front upright.ipt
Mechanical/Frame/lower front rail.ipt
Mechanical/Frame/lower side rail.ipt
Mechanical/Frame/lower vertical rail.ipt
Mechanical/Frame/short frame bracket.ipt
Mechanical/Frame/top plate.ipt
Mechanical/Gripper/IRB120 plate assy.iam
Mechanical/Gripper/IRB120 plate.idw
Mechanical/Gripper/IRB120 plate.ipt
Mechanical/Gripper/acrylic IRB120 plate 2.ipt
Mechanical/Gripper/acrylic IRB120 plate.ipt
Mechanical/Gripper/acrylic gripper manufacturing layout.ipt
Mechanical/Gripper/acrylic gripper plate 2.ipt
Mechanical/Gripper/acrylic gripper plate assy.iam
Mechanical/Gripper/acrylic gripper plate.ipt
Mechanical/Gripper/gripper jaw extension.idw
Mechanical/Gripper/gripper jaw extension.ipt
Mechanical/Gripper/gripper jaw.iam
Mechanical/Gripper/gripper jaw.ipt
Mechanical/Gripper/gripper manufacturing layout.dxf
Mechanical/Gripper/gripper manufacturing layout.iam
Mechanical/Gripper/gripper manufacturing layout.idw
Mechanical/Gripper/gripper pad.ipt
Mechanical/Gripper/gripper plate.ipt
Mechanical/Gripper/gripper with jaws.iam
Mechanical/Gripper/gripper.iam
Mechanical/Gripper/gripper.ipt
Mechanical/IRB120/IRB120.iam
Mechanical/IRB120/Inventor Parts/3HAB3409-207.ipt
Mechanical/IRB120/Inventor Parts/3HAC022117-002.ipt
Mechanical/IRB120/Inventor Parts/3HAC023624-002.ipt
Mechanical/IRB120/Inventor Parts/3HAC030650-001.iam
Mechanical/IRB120/Inventor Parts/3HAC030650-002.ipt
Mechanical/IRB120/Inventor Parts/3HAC031108-003.ipt
Mechanical/IRB120/Inventor Parts/3HAC031109-003.ipt
Mechanical/IRB120/Inventor Parts/3HAC031110-003.ipt
Mechanical/IRB120/Inventor Parts/3HAC031111-003.ipt
Mechanical/IRB120/Inventor Parts/3HAC031112-003.ipt
Mechanical/IRB120/Inventor Parts/3HAC031113-003.ipt
Mechanical/IRB120/Inventor Parts/3HAC031115-003.ipt
Mechanical/IRB120/Inventor Parts/3HAC031116-003.ipt
Mechanical/IRB120/Inventor Parts/3HAC031117-003.ipt
Mechanical/IRB120/Inventor Parts/3HAC031120-001.ipt
Mechanical/IRB120/Inventor Parts/3HAC031125-001.ipt
Mechanical/IRB120/Inventor Parts/3HAC031128-001.ipt
Mechanical/IRB120/Inventor Parts/3HAC031129-001.ipt
Mechanical/IRB120/Inventor Parts/3HAC031347-001.ipt
Mechanical/IRB120/Inventor Parts/3HAC031650-001.ipt
Mechanical/IRB120/Inventor Parts/3HAC031694-001.ipt
Mechanical/IRB120/Inventor Parts/3HAC031871-001.ipt
Mechanical/IRB120/Inventor Parts/3HAC031956-001.ipt
Mechanical/IRB120/Inventor Parts/3HAC032050-001.ipt
Mechanical/IRB120/Inventor Parts/3HAC032090-001.ipt
Mechanical/IRB120/Inventor Parts/3HAC032112-001.ipt
Mechanical/IRB120/Inventor Parts/3HAC032142-001.iam
Mechanical/IRB120/Inventor Parts/3HAC032146-001.iam
Mechanical/IRB120/Inventor Parts/3HAC033060-001.ipt
Mechanical/IRB120/Inventor Parts/3HAC034429-001.ipt
Mechanical/IRB120/Inventor Parts/3HAC2622-1.ipt
Mechanical/IRB120/Inventor Parts/3HEA801325-003.ipt
Mechanical/IRB120/Inventor Parts/ABB logo black.ipt
Mechanical/IRB120/Inventor Parts/ABB logo on axis 3.ipt
Mechanical/IRB120/Inventor Parts/IRB120_Base_rev0.iam
Mechanical/IRB120/Inventor Parts/IRB120_Link1_rev0.iam
Mechanical/IRB120/Inventor Parts/IRB120_Link2_rev0.iam
Mechanical/IRB120/Inventor Parts/IRB120_Link3_rev0.iam
Mechanical/IRB120/Inventor Parts/IRB120_Link4_rev0.iam
Mechanical/IRB120/Inventor Parts/IRB120_Link5_rev0.iam
Mechanical/IRB120/Inventor Parts/IRB120_Link6_rev0.ipt
Mechanical/IRC5/IRC5_Compact.ipt
Mechanical/Imported Components/cu_conn_crio_10_pos_weid/cu_conn_crio_10_pos_weid.ipt
Mechanical/Invacare/battery rails.ipt
Mechanical/Invacare/battery.ipt
Mechanical/Invacare/caster assy.iam
Mechanical/Invacare/caster wheel.ipt
Mechanical/Invacare/caster.ipt
Mechanical/Invacare/frame assy.iam
Mechanical/Invacare/frame.ipt
Mechanical/Invacare/frame_solid.iam
Mechanical/Invacare/ground plne.ipt
Mechanical/Invacare/invacare assy.iam
Mechanical/Invacare/lumped batteries.iam
Mechanical/Invacare/motor.ipt
Mechanical/Invacare/motor_MIR.ipt
Mechanical/Invacare/wheel.ipt
Mechanical/Inverter/2kW inverter.ipt
Mechanical/Inverter/Inverter Standin.ipt
Mechanical/Inverter/inverter.ipt
Mechanical/Kinect/Kinect.ipt
Mechanical/Kinect/acrylic kinect bracket - bracket.ipt
Mechanical/Kinect/acrylic kinect bracket - kinect plate.ipt
Mechanical/Kinect/acrylic kinect bracket - manufacturing.iam
Mechanical/Kinect/acrylic kinect bracket - manufacturing.idw
Mechanical/Kinect/acrylic kinect bracket 2.iam
Mechanical/Kinect/acrylic kinect bracket.iam
Mechanical/Kinect/acrylic kinect bracket.ipt
Mechanical/Kinect/acrylic kinect plate.ipt
Mechanical/Kinect/kinect bracket b.ipt
Mechanical/Kinect/kinect bracket.ipt
Mechanical/Kinect/kinect standoff.ipt
Mechanical/Kinect/test assy.iam
Mechanical/LIDAR Power Supply/LIDAR PSU.ipt
Mechanical/PC/PC.ipt
Mechanical/Pneumatics/accumulator/accumulator.iam
Mechanical/Pneumatics/accumulator/volumetank1.ipt
Mechanical/Pneumatics/accumulator/volumetank2.ipt
Mechanical/Pneumatics/accumulator/volumetank3.ipt
Mechanical/Pneumatics/compressor/CompressorBody.ipt
Mechanical/Pneumatics/compressor/CompressorHead.ipt
Mechanical/Pneumatics/compressor/CompressorPlate.ipt
Mechanical/Pneumatics/compressor/CompressorValve.ipt
Mechanical/Pneumatics/compressor/compressor.iam
Mechanical/Pneumatics/compressor/compressormotorbody.ipt
Mechanical/Pneumatics/compressor/compressormotorcap.ipt
Mechanical/Pneumatics/pressuregage/pressuregage.iam
Mechanical/Pneumatics/pressuregage/pressuregage1.ipt
Mechanical/Pneumatics/pressuregage/pressuregage2.ipt
Mechanical/Pneumatics/pressuregage/pressuregage3.ipt
Mechanical/Pneumatics/pressuregage/pressuregage4.ipt
Mechanical/Pneumatics/pressureswitch/pressureswitch.ipt
Mechanical/Pneumatics/regulator/pressureregulator11.ipt
Mechanical/Pneumatics/regulator/pressureregulator12.ipt
Mechanical/Pneumatics/regulator/pressureregulator13.ipt
Mechanical/Pneumatics/regulator/pressureregulator14.ipt
Mechanical/Pneumatics/regulator/pressureregulator15.ipt
Mechanical/Pneumatics/regulator/pressureregulator16.ipt
Mechanical/Pneumatics/regulator/regulator.iam
Mechanical/Relay/relay.ipt
Mechanical/Router/router keepout.ipt
Mechanical/SICK/LIDAR Bracket.ipt
Mechanical/SICK/SICK LMS291.ipt
Mechanical/Sabertooth/sabertooth keepout.ipt
Mechanical/Spike/1x3 Header Connector.ipt
Mechanical/Spike/ATO Fuse.ipt
Mechanical/Spike/LED - Green.ipt
Mechanical/Spike/Spike Bottom Cover.ipt
Mechanical/Spike/Spike Female Terminal.ipt
Mechanical/Spike/Spike H.iam
Mechanical/Spike/Spike Male Terminal.ipt
Mechanical/Spike/Spike PCB.ipt
Mechanical/Spike/Spike Top Cover.ipt
Mechanical/al_frame.iam
Mechanical/base plate.iam
Mechanical/bin.ipt
Mechanical/cRIO/Inventor/cRIO with Modules.iam
Mechanical/cRIO/cRIO Breakout Keepout.ipt
Mechanical/cRIO/cRIO bracket.ipt
Mechanical/fixed_robot.iam
Mechanical/objects/door knob.ipt
Mechanical/objects/table.ipt
Mechanical/robot.iam
Mechanical/robot.idw
Mechanical/robot_no_arm.iam
Mechanical/robot_solid.iam
