evenator/masters/circle localization test.xlsx

Trial | x | y | Oz | Ow | displacement | theta (rad) | theta (deg) | heading (rad) | heading (deg)
1 | 0.730259 | 0.432428 | 0.506607 | 0.862177 | 0.8486885072 | 0.5346326511 | 30.6321945 | 0.5083067088 | 29.12382911
2 | 0.802263 | 0.450112 | 0.52842 | 0.848983 | 0.9199058287 | 0.5112895163 | 29.29473139 | 0.457319503 | 26.20247741
3* | 0.940856 | 0.595996 | 0.613116 | 0.789993 | 1.113742001 | 0.5646608232 | 32.35268202 | 0.2507984511 | 14.36969275
4 | 0.750552 | 0.620947 | 0.558108 | 0.829769 | 0.97411677 | 0.6911791649 | 39.60164904 | 0.3865882548 | 22.14987541
5 | 0.778034 | 0.329655 | 0.45862 | 0.888633 | 0.8449907243 | 0.4007711937 | 22.96249795 | 0.6179127995 | 35.40379552
6 | 0.892425 | 0.433918 | 0.502437 | 0.864614 | 0.9923241463 | 0.4525657864 | 25.93010951 | 0.5179660898 | 29.67727088
Average | 0.8157315 | 0.477176 | 0.5278846667 | 0.8473615 | 0.9489613296 | 0.5258498559 | 30.1289774 | 0.4564819679 | 26.15449018
STD | 0.07604214941 | 0.1009594279 | 0.04843558184 | 0.03115486752 | 0.09253337012 | 0.09141885216 | 5.237914397 | 0.1152660373 | 6.604257458
(5 laps of 1 meter radius circle. Perfect localization would have robot at origin)
