evenator/masters/thesis/figures/estop_receiver-eps-converted-to.pdf

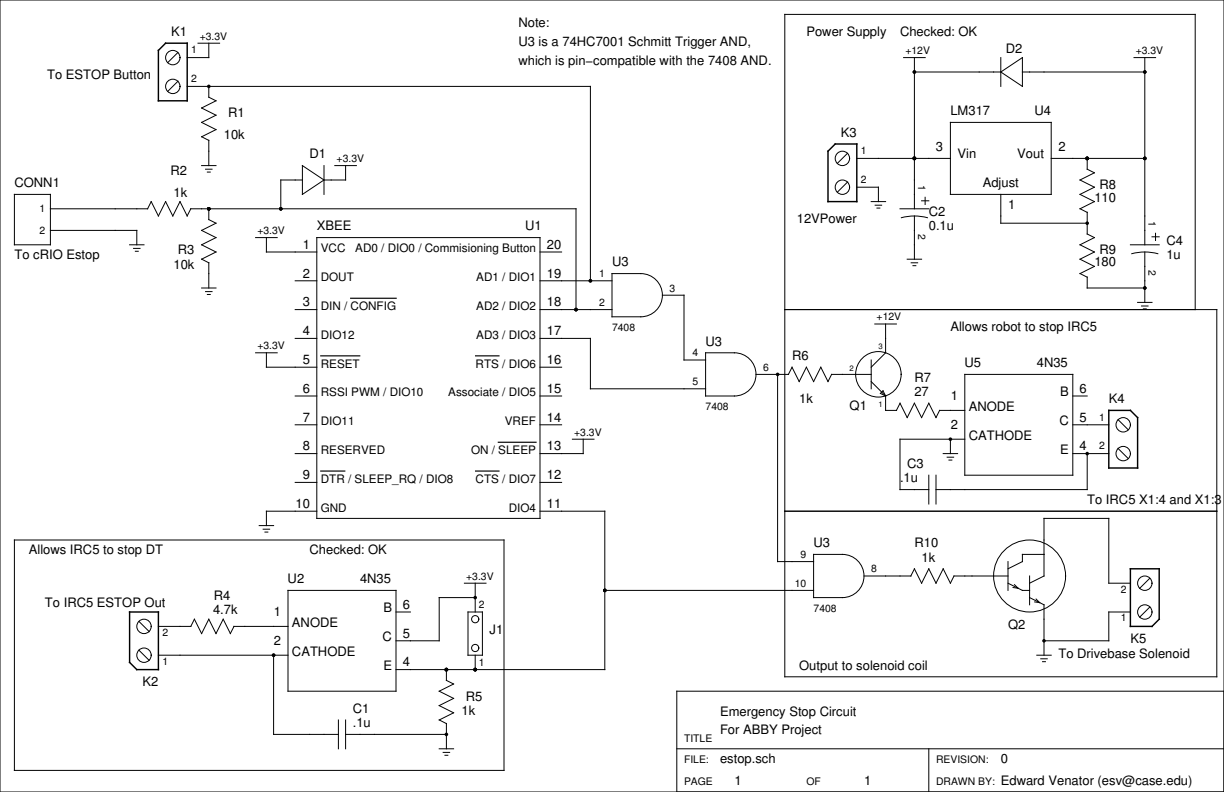
[picture p187: page 1]

Note:
U3 is a 74HC7001 Schmitt Trigger AND,
which is pin−compatible with the 7408 AND.

Allows robot to stop IRC5

Output to solenoid coil

Edward Venator (esv@case.edu)
