evenator/masters/thesis/figures/estop_receiver_revised-eps-converted-to.pdf

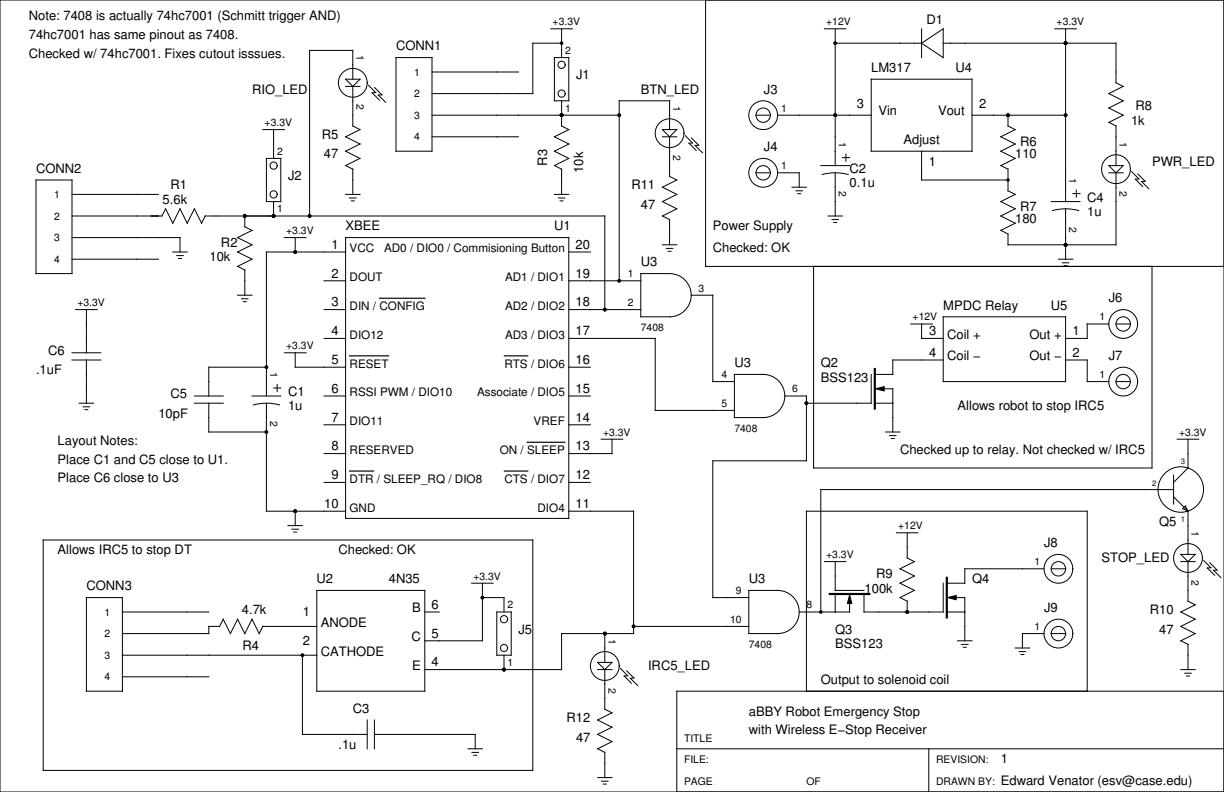
[picture p188: page 1]

74hc7001 has same pinout as 7408.
Checked w/ 74hc7001. Fixes cutout isssues.

Allows robot to stop IRC5

Layout Notes:
Place C1 and C5 close to U1.
Place C6 close to U3

Checked up to relay. Not checked w/ IRC5

Allows IRC5 to stop DT

Output to solenoid coil

aBBY Robot Emergency Stop
with Wireless E−Stop Receiver

Edward Venator (esv@case.edu)
