evenator/masters/thesis/figures/estop_remote-eps-converted-to.pdf

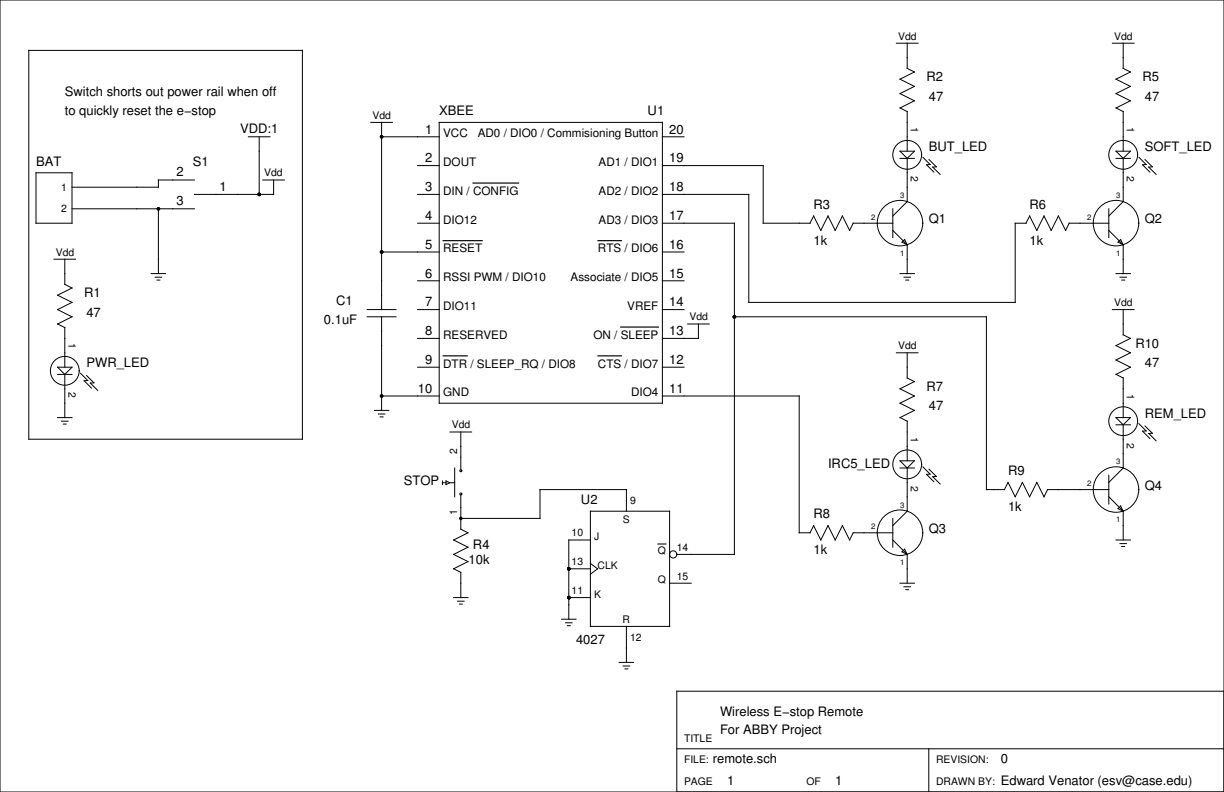
[picture p189: page 1]

Switch shorts out power rail when off
to quickly reset the e−stop

Edward Venator (esv@case.edu)
