evenator/masters/thesis/figures/estop_remote_revised-eps-converted-to.pdf

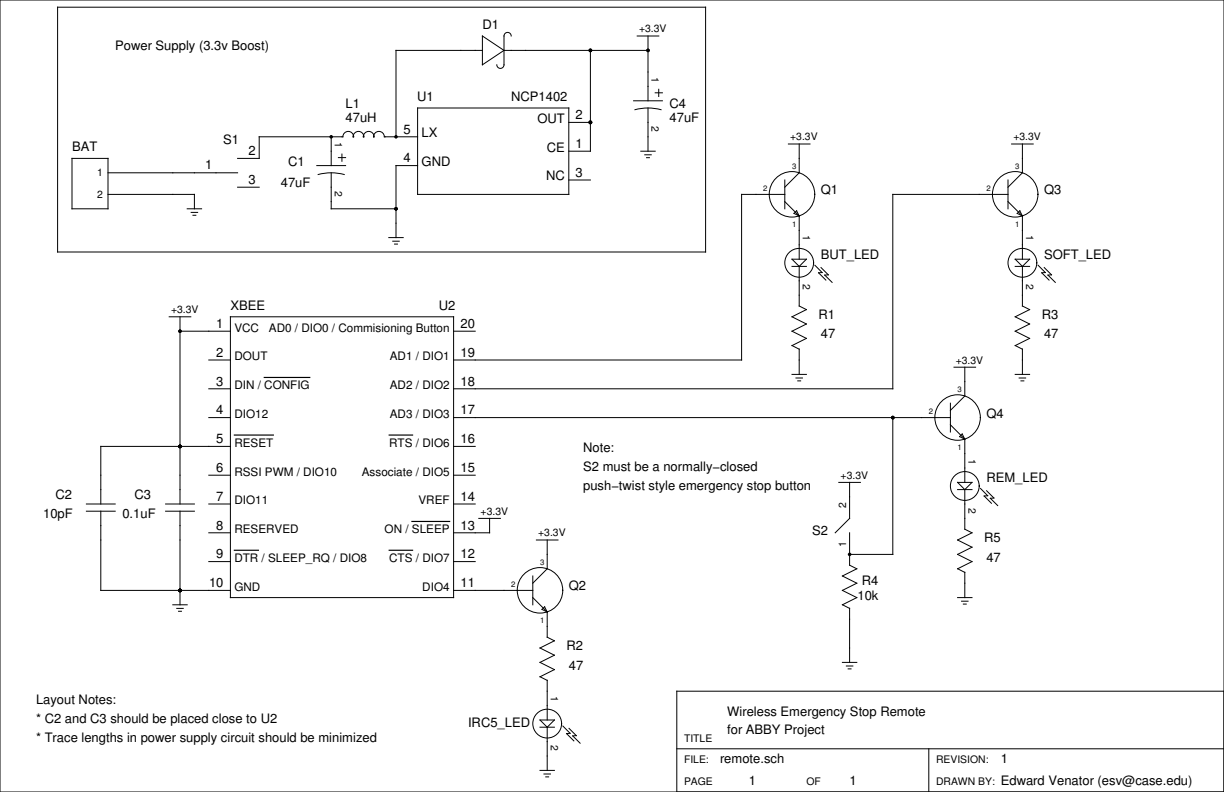
[picture p190: page 1]

Note:
S2 must be a normally−closed
push−twist style emergency stop button

Layout Notes:
* C2 and C3 should be placed close to U2
* Trace lengths in power supply circuit should be minimized

Wireless Emergency Stop Remote
for ABBY Project

Edward Venator (esv@case.edu)
