evenator/masters/Mechanical/Kinect/68-04555-RB_Kinect_Standoff.PDF

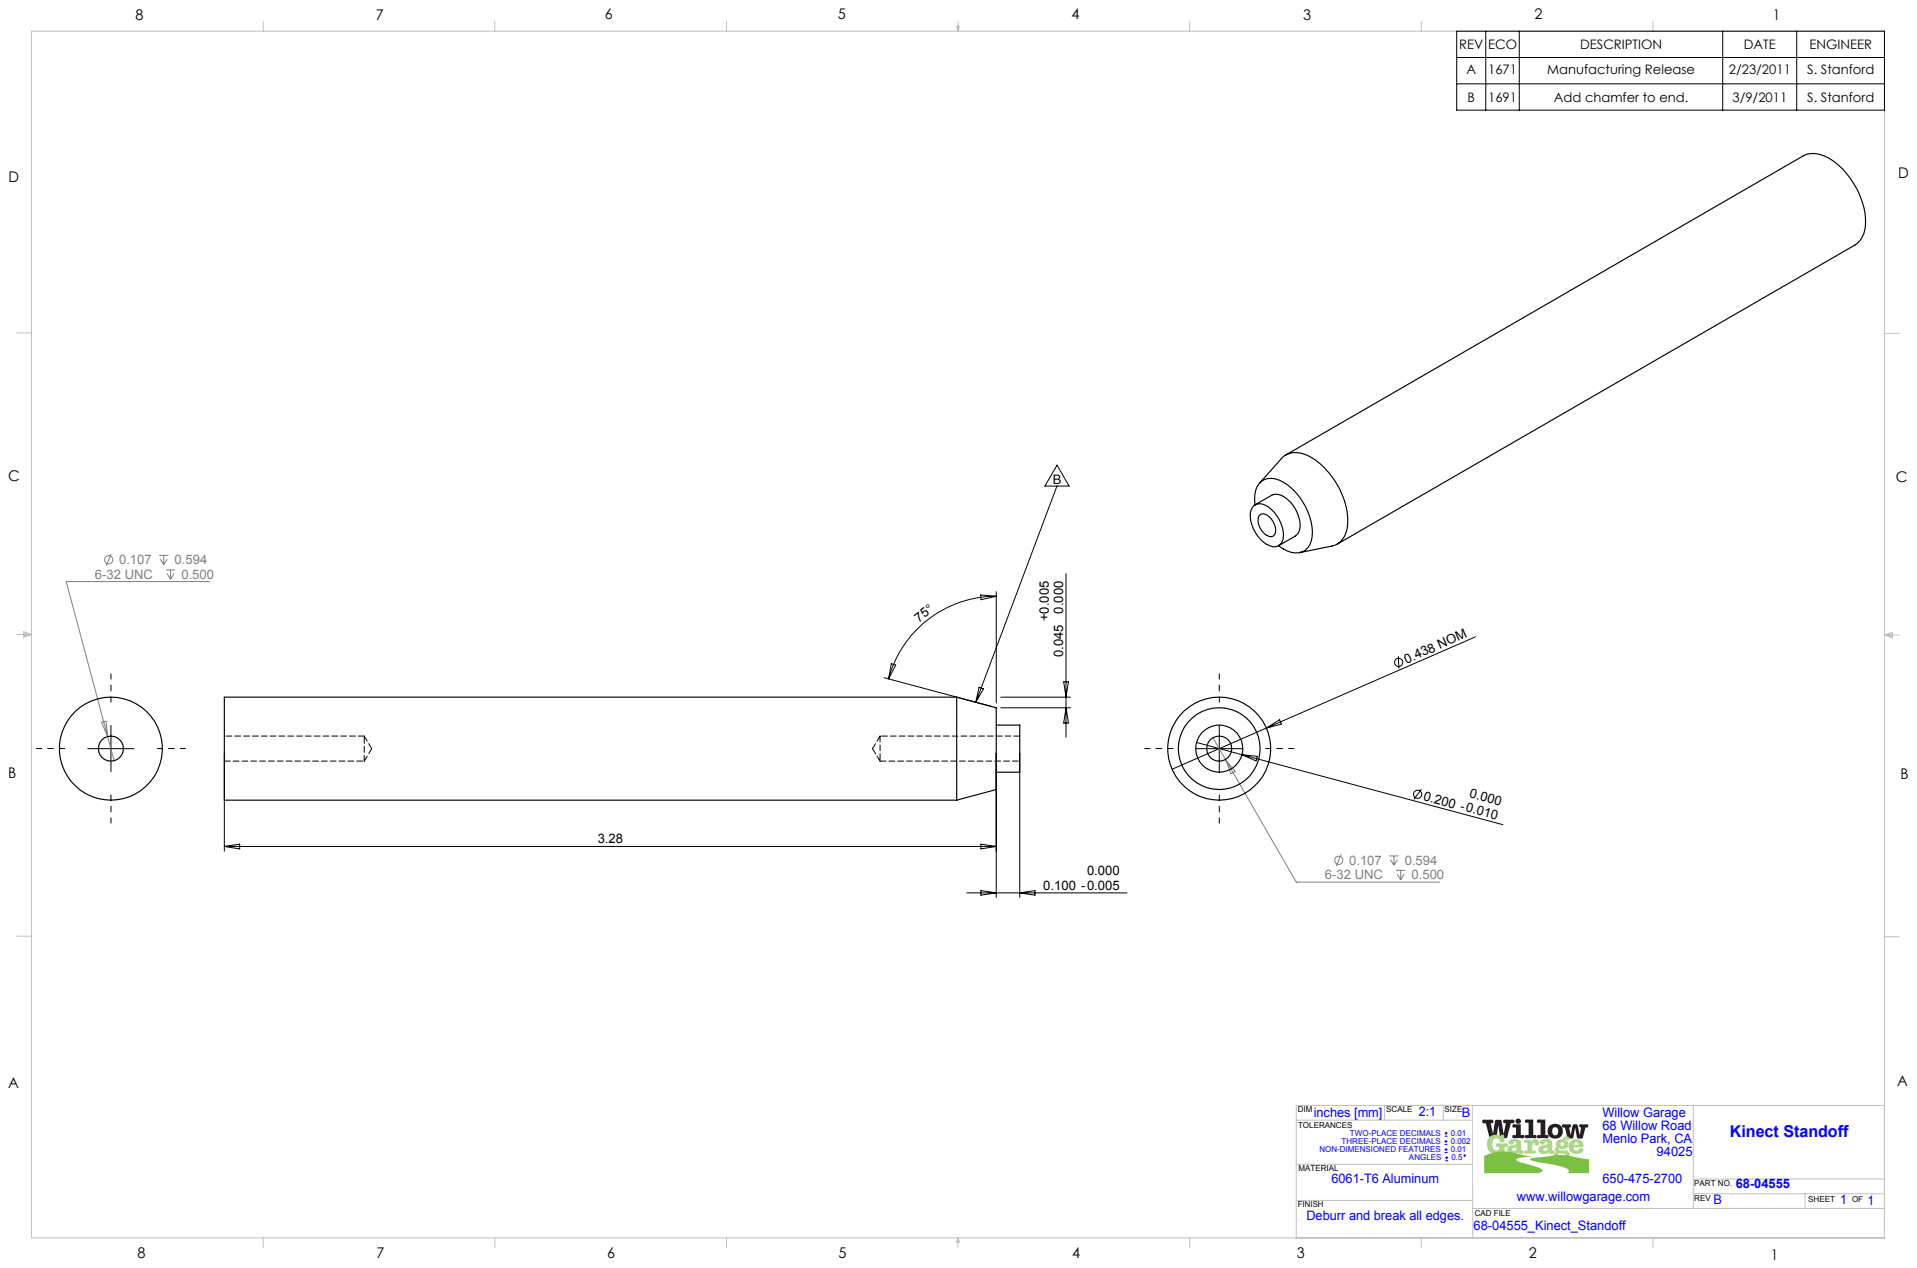
[picture p191: page 1]
0.438 NOM; 6-32 UNC; REV B; PART NO.; SHEET 1 OF 1; CAD FILE; ANGLES 0.5; Kinect Standoff

REV ECO | | DESCRIPTION | DATE | ENGINEER
A | 1671 | Manufacturing Release | 2/23/2011 | S. Stanford
B | 1691 | Add chamfer to end. | 3/9/2011 | S. Stanford

2:1 DIM inches [mm]
B TOLERANCES

Willow Garage
68 Willow Road
Menlo Park, CA

TWO-PLACE DECIMALS 0.01
THREE-PLACE DECIMALS 0.002
NON-DIMENSIONED FEATURES 0.01
MATERIAL
6061-T6 Aluminum

www.willowgarage.com
68-04555_Kinect_Standoff

FINISH
Deburr and break all edges.
