evenator/masters/Mechanical/Gripper/gripper jaw extension.pdf

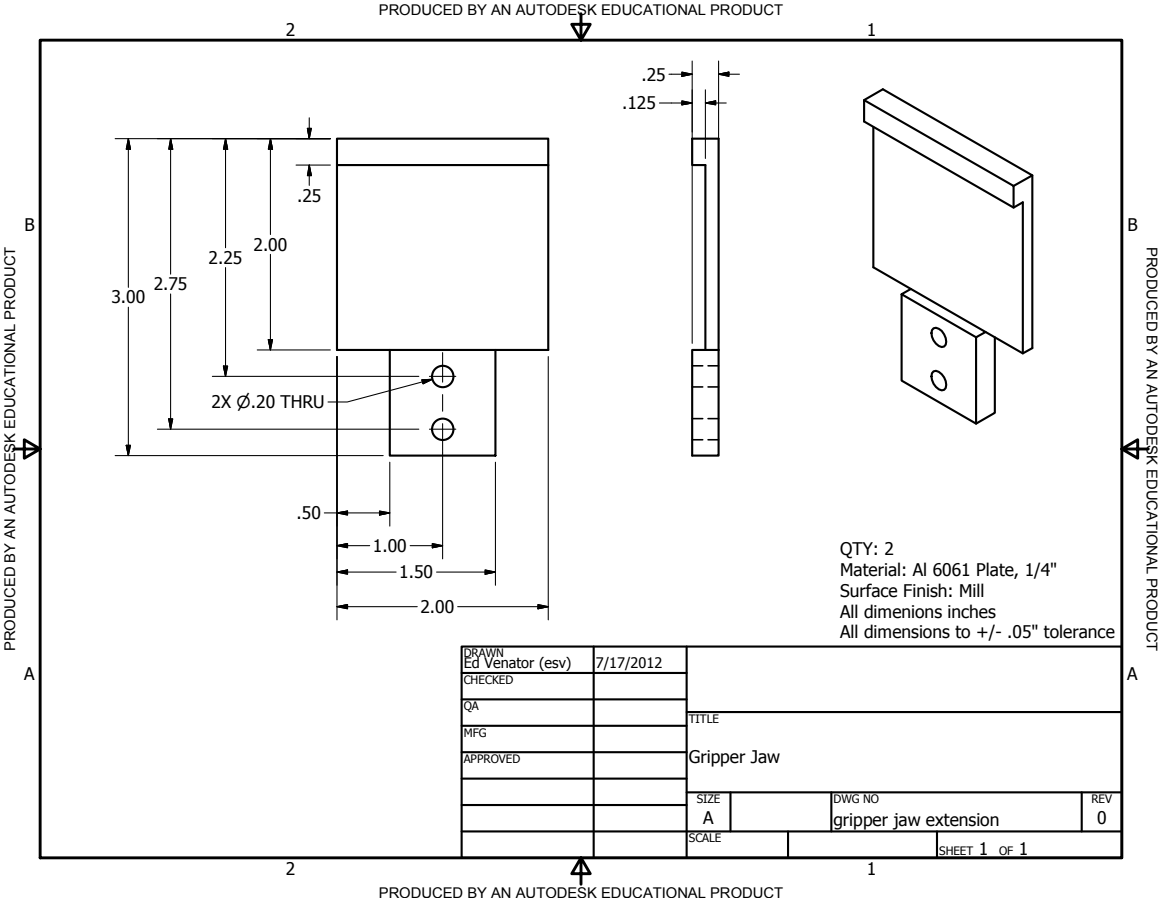
[picture p192: page 1]
TIO; A U T O D E S K E D U C A TIO; MFG; APPROVED; TITLE; Gripper Jaw; SIZE A; SCALE; REV 0; SHEET 1 OF 1; 2X P.20 THRU

PRODUCED BY AN AUTODESK EDUCATIONAL PRODUCT

QTY: 2
Material: Al 6061 Plate, 1/4"
Surface Finish: Mill
All dimenions inches
All dimensions to +/- .05" tolerance

DRAWN
Ed Venator (esv)
CHECKED

DWG NO
gripper jaw extension
