evenator/masters/Mechanical/Gripper/gripper plate.pdf

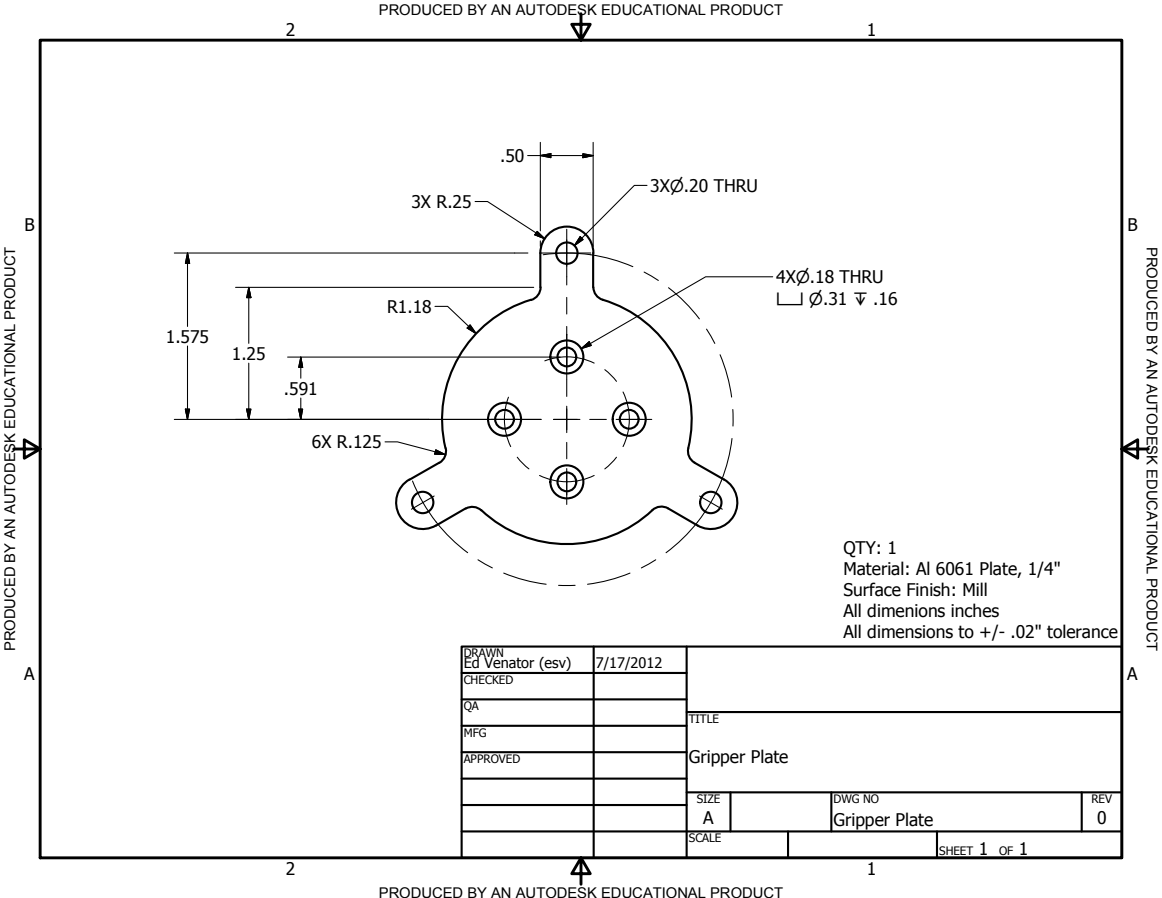
[picture p193: page 1]
TIO; A U T O D E S K E D U C A TIO; MFG; APPROVED; TITLE; Gripper Plate; SIZE A; SCALE; DWG NO Gripper Plate; REV 0; SHEET 1 OF 1; 4XP.18 THRU X P.31 Z .16; 3XP.20 THRU

PRODUCED BY AN AUTODESK EDUCATIONAL PRODUCT

QTY: 1
Material: Al 6061 Plate, 1/4"
Surface Finish: Mill
All dimenions inches
All dimensions to +/- .02" tolerance

DRAWN
Ed Venator (esv)
CHECKED
