evenator/masters/Mechanical/Gripper/IRB120 plate.pdf

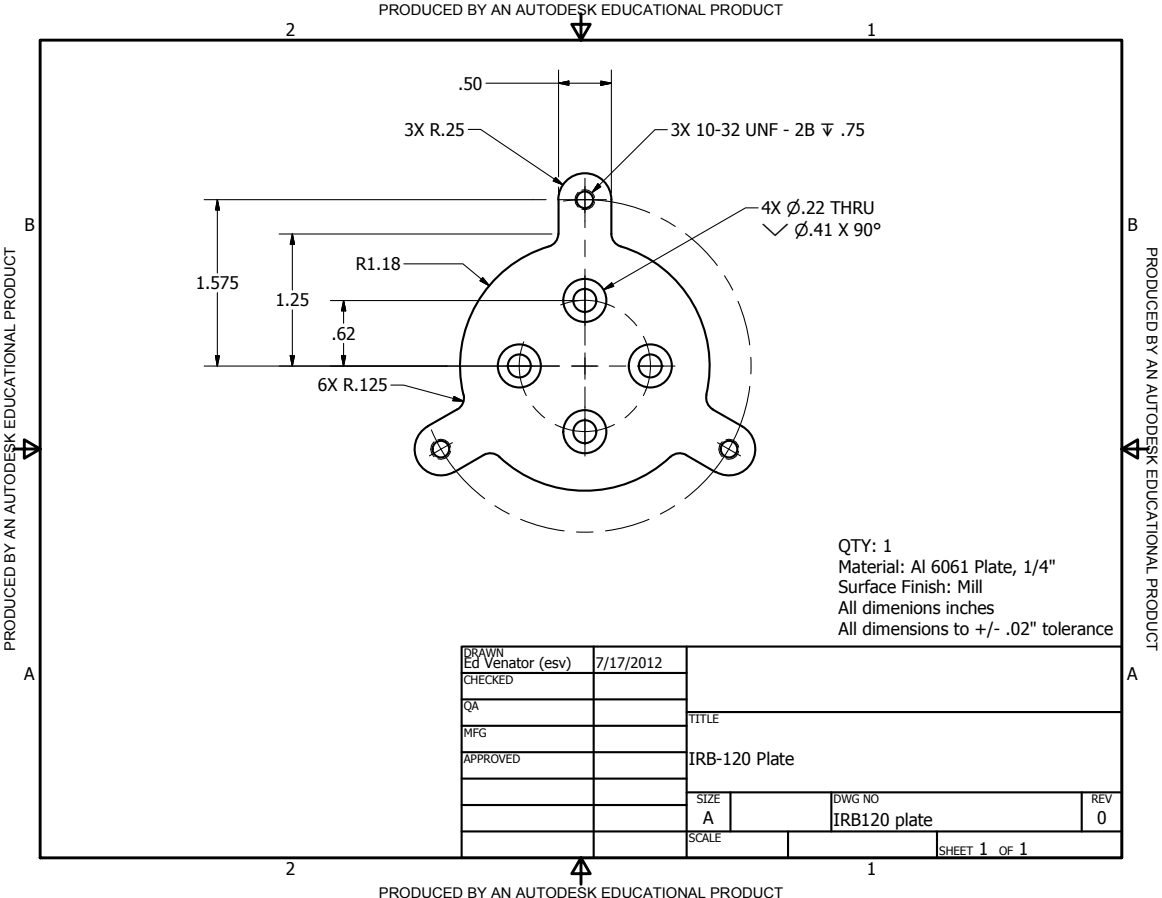
[picture p194: page 1]
TIO; A U T O D E S K E D U C A TIO; MFG; APPROVED; TITLE; IRB-120 Plate; SIZE A; SCALE; DWG NO IRB120 plate; REV 0; SHEET 1 OF 1; 4X P.22 THRU Y P.41 X 90°; 3X 10-32 UNF - 2B Z .75

PRODUCED BY AN AUTODESK EDUCATIONAL PRODUCT

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

DRAWN
Ed Venator (esv)
CHECKED
