evenator/masters/Electronics/eStop/estop.pdf

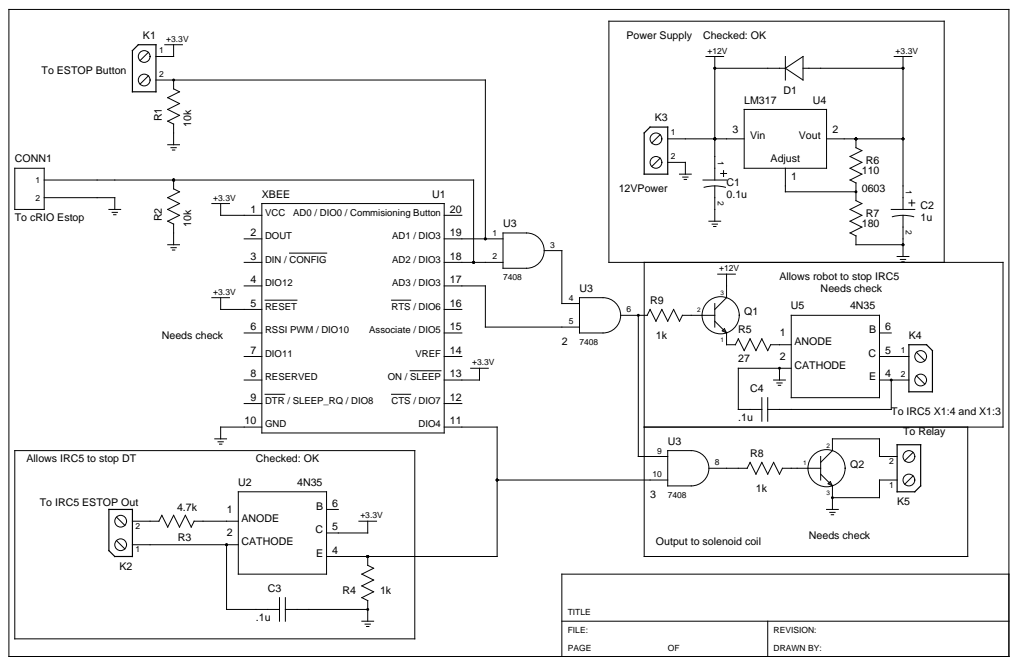
[picture p195: page 1]

Allows robot to stop IRC5

Allows IRC5 to stop DT

Output to solenoid coil
