evenator/masters/figures/breakout.pdf

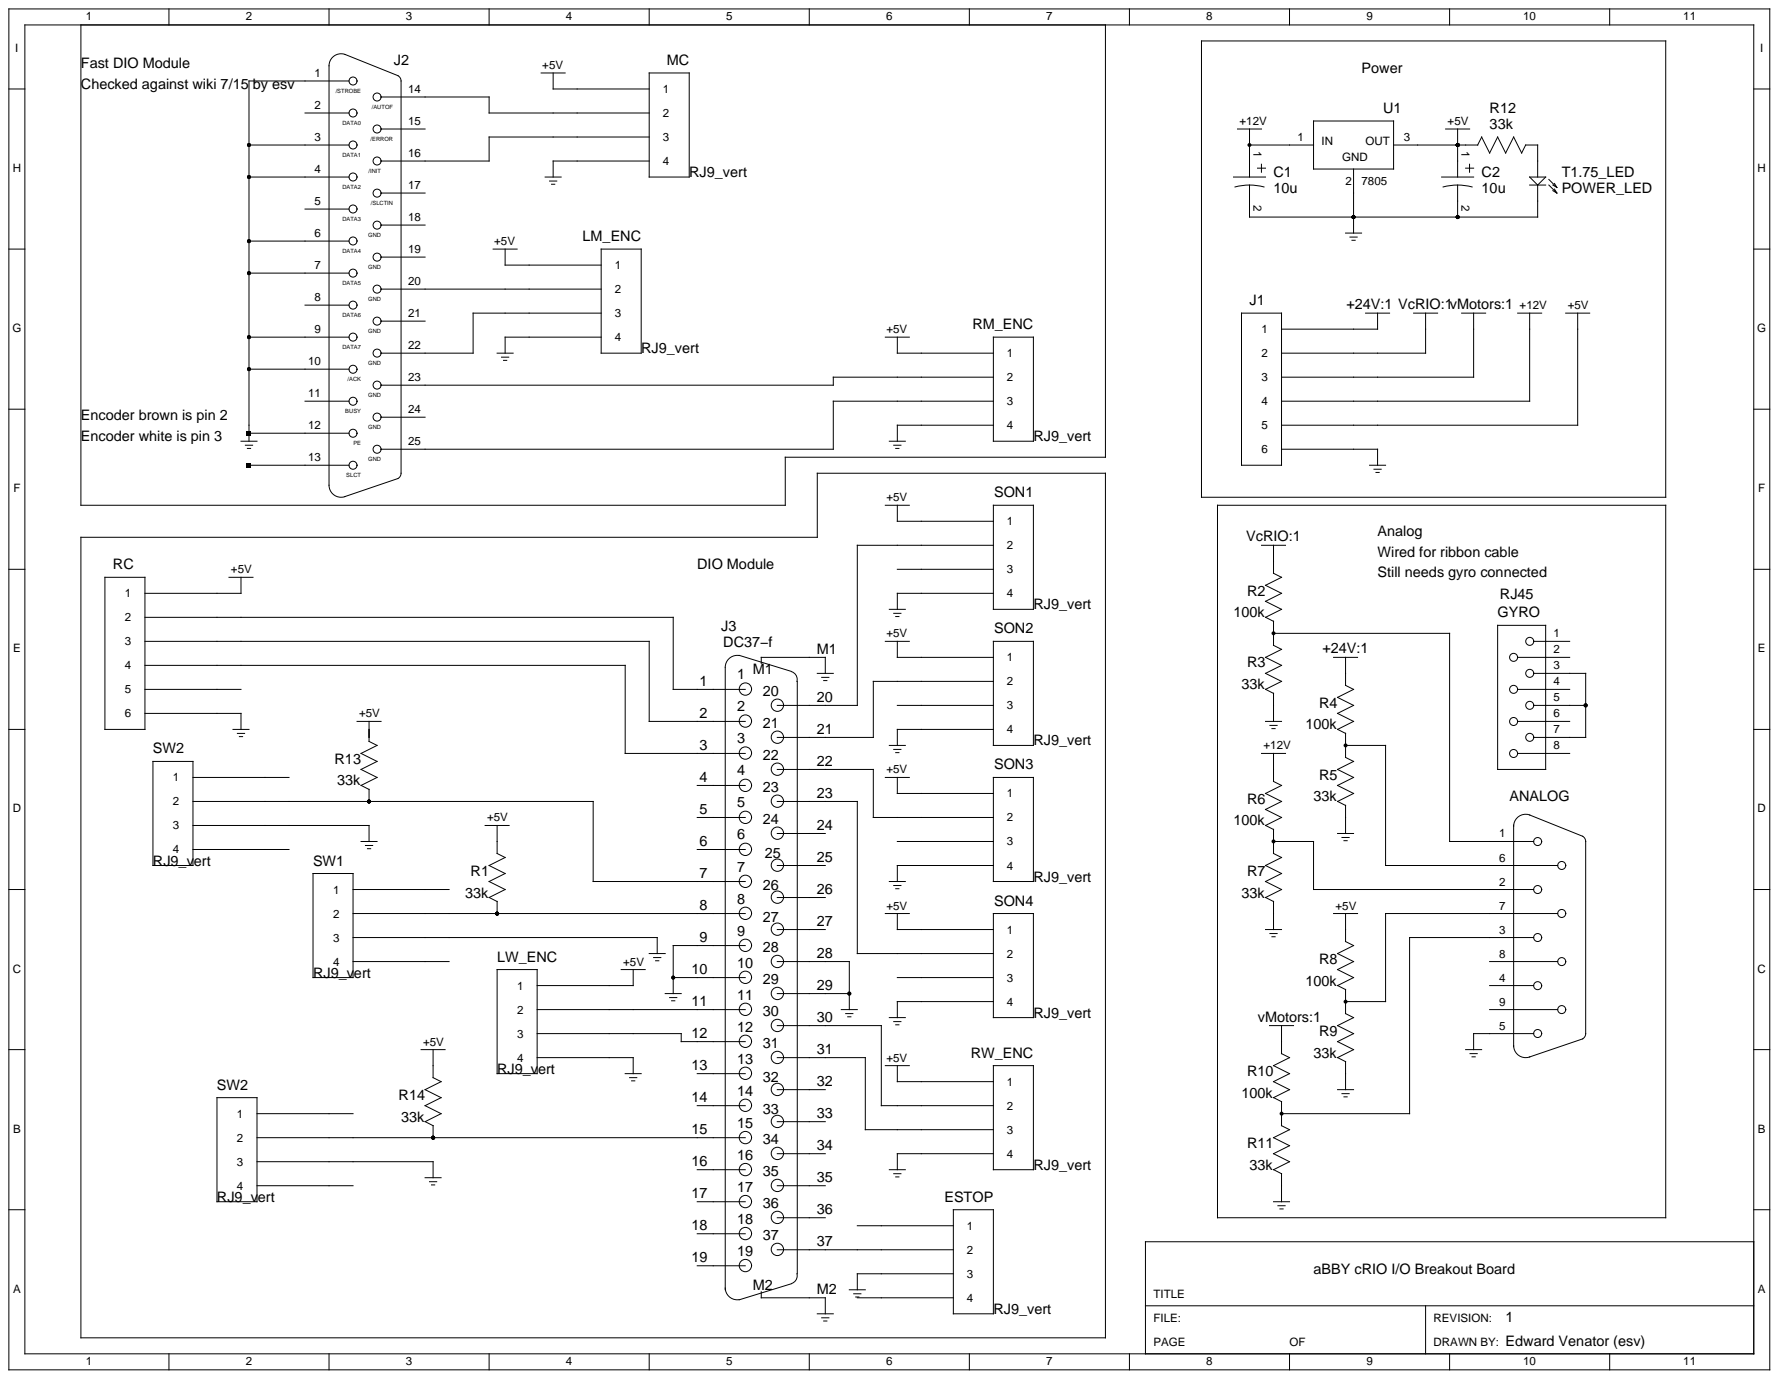
[picture p196: page 1]

Encoder brown is pin 2
Encoder white is pin 3

Analog
Wired for ribbon cable
Still needs gyro connected

aBBY cRIO I/O Breakout Board
