evenator/masters/figures/data block diagram.pdf

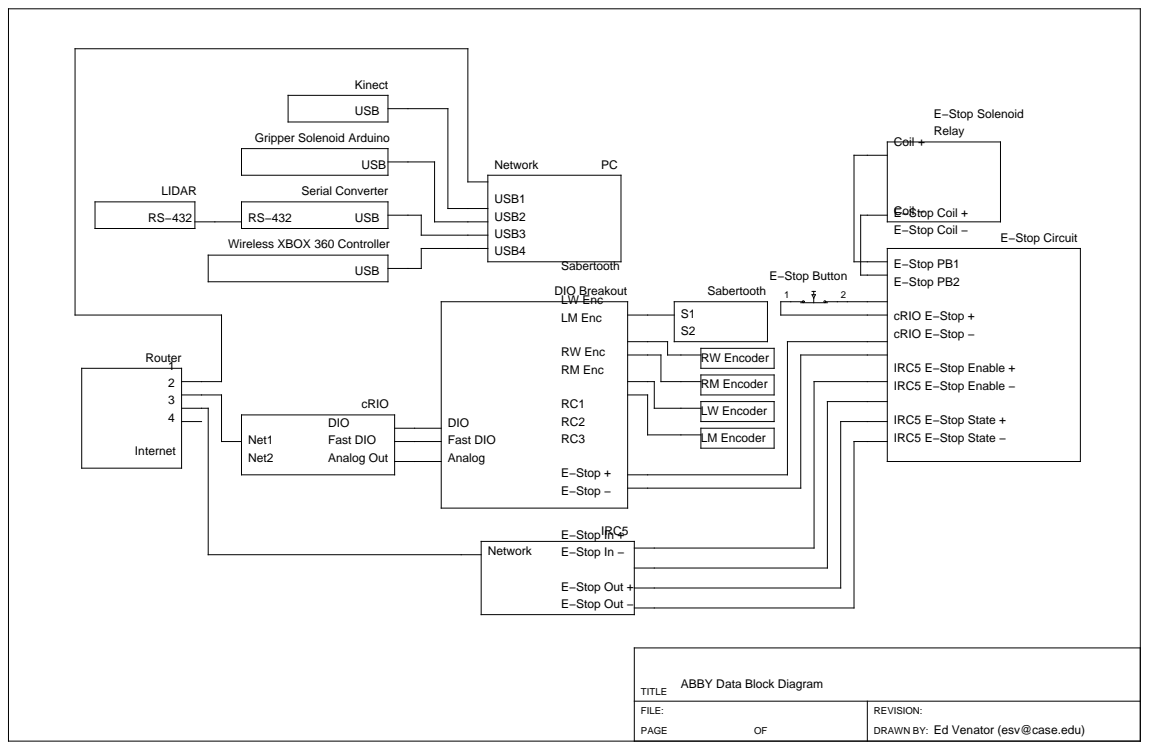
[picture p197: page 1]
PAGE; DRAWN BY:; Router 1; E−Stop In +; E−Stop In −; E−Stop Out +; E−Stop Out −; E−Stop Circuit; E−Stop Coil +; E−Stop Coil −; E−Stop PB1; E−Stop PB2; cRIO E−Stop +; cRIO E−Stop −; IRC5 E−Stop Enable +; IRC5 E−Stop Enable −; IRC5 E−Stop State +; IRC5 E−Stop State −; E−Stop Solenoid; Relay Coil +; Coil −; E−Stop Button; LW Enc; LM Enc; RW Enc; RM Enc; E−Stop +; E−Stop −; DIO Breakout; Fast DIO; Analog Out; RW Encoder; LW Encoder; RM Encoder; LM Encoder; LIDAR; Serial Converter

Gripper Solenoid Arduino

Wireless XBOX 360 Controller

ABBY Data Block Diagram

Ed Venator (esv@case.edu)
