evenator/masters/figures/gripper control.pdf

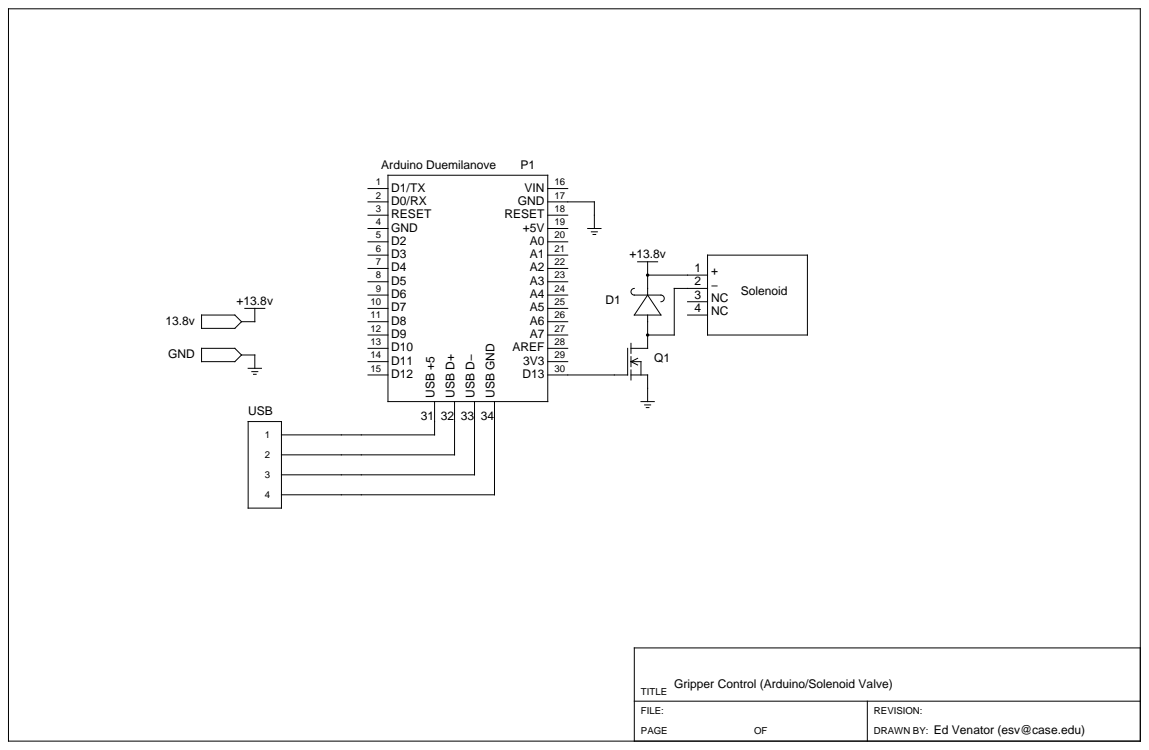
[picture p198: page 1]

TITLE Gripper Control (Arduino/Solenoid Valve)

Ed Venator (esv@case.edu)
