evenator/masters/Electronics/cRIO Breakout/breakout.sch.pdf

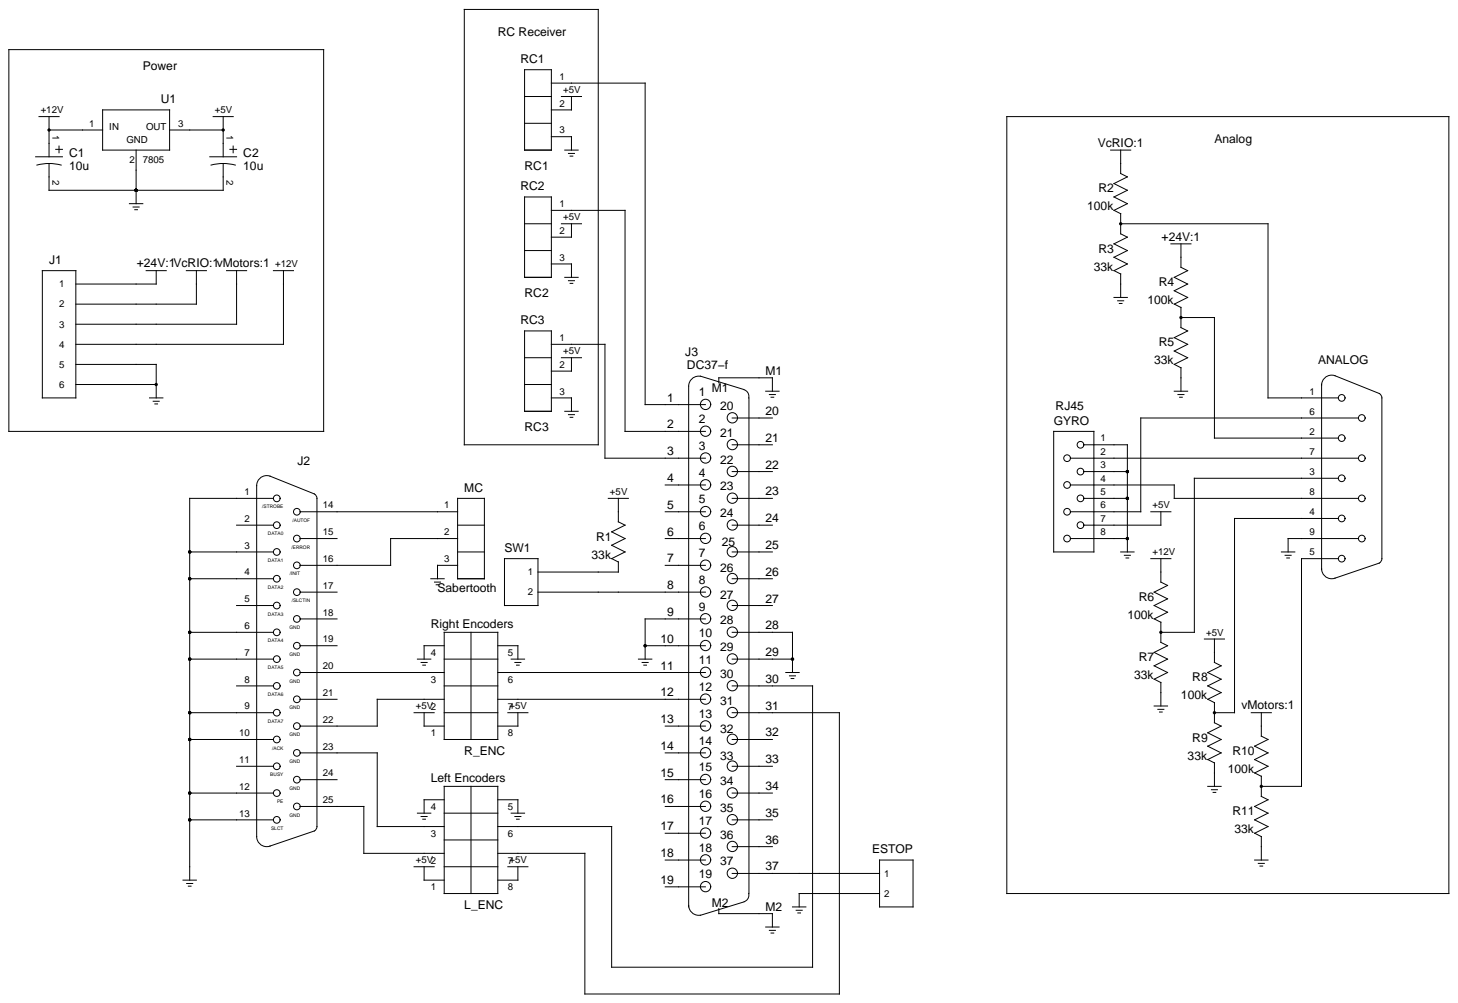
[picture p199: page 1]

VcRIO:1 | Analog
