evenator/masters/Electronics/eStop_remote/remote.pdf

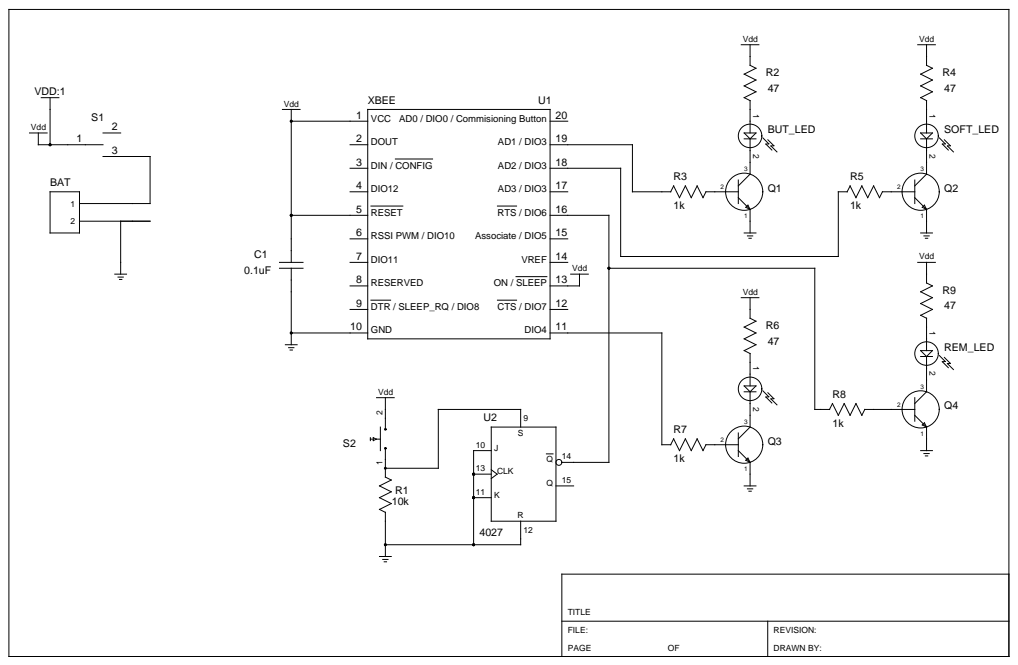
[picture p200: page 1]
