evenator/masters/(list of files, drawings)

Other design files:
Electronics/combined/combined.pcb
Electronics/cRIO Breakout/breakout.pcb
Electronics/eStop/estop.new.pcb
Electronics/eStop/estop.pcb
Electronics/eStop_remote/remote.pcb
Electronics/xBEE_dip/xBEE_dip.pcb
