evenator/masters/(commit log)

2012-02-04 First commit. Includes Alan's current config, NSF proposal, and project file.
2012-02-10 Added CAD files.
    [3HAB3409-207.ipt, 3HAC022117-002.ipt, 3HAC023624-002.ipt, 3HAC030650-001.iam, 3HAC030650-002.ipt, 3HAC031108-003.ipt, 3HAC031109-003.ipt, 3HAC031110-003.ipt]
2012-02-13 Added step files for SICK LIDAR and parts lists for Alan's new PC.
    [LMS291-S05_S14-S052389.stp, alan micro atx pc.xlsx, alan pc.xlsx]
2012-02-13 Added backup of robot in factory condition and new configuration to repo.
    [EIO.cfg, MMC.cfg, MOC.cfg, PROC.cfg, SIO.cfg, SYS.cfg]
2012-03-06 Added IRC5 step file to repo.
    [IRC5_Compact.stp]
2012-03-08 CADed the wheelchair base. Added a gitignore file.
    [battery rails.0002.ipt, battery rails.ipt, battery.ipt, caster assy.iam, caster wheel.ipt, caster.0001.ipt, caster.ipt, frame assy.iam]
2012-03-08 Grabbed a bunch of cad files of pneumatic components.
    [CompressorBody.ipt, CompressorHead.ipt, CompressorPlate.ipt, CompressorValve.ipt, IRC5_Compact.ipt, PC.ipt, accumulator.iam, accumulator.stp]
2012-03-20 Updated lots of CAD models. Also added the cRIO breakout to the repo.
    [1x3 Header Connector.ipt, ATO Fuse.ipt, BoM.xlsx, Bosch 40 x 40 strut profile.ipt, Breaker Body.ipt, Breaker Post.ipt, Breaker.iam, IRB120.0003.iam]
2012-03-20 Designed an eStop board.
    [estop.new.pcb, estop.pcb, estop.sch]
2012-03-20 Added copper pour on solder layer of eStop board.
    [estop.pcb]
2012-03-25 New CAD files of router, LIDAR supply, 13.8v supply, relay, and capacitor.
    [1x3 Header Connector.ipt, ATO Fuse.ipt, BoM.xlsx, Bosch 40 x 40 strut profile.ipt, Breaker Body.ipt, Breaker Post.ipt, Breaker.iam, Cap.ipt]
2012-03-26 Added relay, router, and power supplies to robot model. Made a spreadsheet with the DIN rail layout.
    [ATO Fuse.0001.ipt, ATO Fuse.ipt, BoM.xlsx, DIN Rail layout.xlsx, Spike H.0012.iam, Spike H.iam, robot.iam, sabertooth keepout.0001.ipt]
2012-03-26 Removed many OldVersions folders.
    [ATO Fuse.0001.ipt, IRB120.0004.iam, IRC5_Compact.0001.ipt, Spike H.0012.iam, aim rail cross brace.0001.ipt, arm rail.0002.ipt, back frame plate.0001.ipt, back frame plate.0002.ipt]
2012-03-30 Finished robot model.
    [front left plate.ipt, front right plate.ipt, lower front rail.ipt, lower side rail.ipt, lower vertical rail.ipt, robot.iam]
2012-03-30 Created 3 online metals orders (different materials for top and bottom plates).
2012-03-30 New BoM generated from the assy.
    [model BOM.xls]
2012-03-31 Added DIN terminals and DIN block; still need to add rail and put in assy.
    [12v terminal.ipt, 24v terminal.ipt, DIN Block.iam, DIN Terminal.stp, gnd terminal.ipt]
2012-03-31 Modified inverter to actual dimensions.
    [Inverter Standin.ipt]
2012-04-01 Updated BoM to include bosch inventory.
    [model BOM.xls, robot.iam]
2012-04-03 New dsub symbols.
    [estop.new.pcb, estop.pcb, estop.sch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]
2012-04-03 Moved cRIO Breakout to gEDA.
    [breakout.sch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]
2012-04-03 eStop gerbers.
    [estop.back.gbr, estop.backmask.gbr, estop.backpaste.gbr, estop.backsilk.gbr, estop.fab.gbr, estop.front.gbr, estop.frontmask.gbr, estop.frontpaste.gbr]
2012-04-12 Updated status of Bosch rail in BoM
    [model BOM.xls]
2012-04-16 Updated status of Bosch rail.
    [model BOM.xls]
2012-04-22 Updated some frame parts. Still need to update everything after the frame is finished.
    [DIN Rail layout.xlsx, frame bracket.ipt, robot.iam, short frame bracket.ipt]
2012-04-30 Updated BoM
    [model BOM.xls]
2012-04-30 Digikey part numbers for ALL THE THINGS.
    [cRIO Breakout.brd, cRIO Breakout.sch, model BOM.xls]
2012-05-03 Modified breakout.
    [breakout.sch]
2012-05-03 cRIO breakout layout.
    [breakout.pcb]
2012-05-03 Renamed some files to ABBy.
    [ABBy micro atx pc.xlsx, ABBy pc.xlsx]
2012-05-03 eStop Remote schematic.
    [remote.sch]
2012-05-05 Fixed a derp in the e-stop remote's latch circuit.
    [remote.sch]
2012-05-12 Updated CAD files.
    Updated CAD files to reflect actual fabricated parts. Front rails are now
    accurate. Bottom plate mounting is also now up to date with the actual
    robot. Created the LIDAR bracket and the cRIO bracket.
    [LIDAR Bracket.ipt, aim rail cross brace.ipt, base plate.iam, base plate.ipt, cRIO bracket.ipt, front left plate.ipt, front right plate.ipt, front top side rail.ipt]
2012-05-12 Updated BoM
    Updated BoM status to include recent orders and fabrication.
    [model BOM.xls]
2012-05-12 Updated timeline.
    Updated timeline to reflect actual progress and the face that I won't be here
    from the 21st to the 1st.
    [timeline.xlsx]
2012-05-18 Updated DIN Rail layout with revised positions/status.
    [DIN Rail layout.xlsx]
2012-05-26 Added simmechanics file and STL files for full robot to repo.
    [Breaker_iam_746c8f85.STL, IRB120_Base_rev0_iam_38446303.STL, IRB120_Link1_rev0_iam_3fe6e7e5.STL, IRB120_Link2_rev0_iam_90725b7e.STL, IRB120_Link3_rev0_iam_86ced70a.STL, IRB120_Link4_rev0_iam_467bed4b.STL, IRB120_Link5_rev0_iam_8f44ede8.STL, IRB120_Link6_rev0_ipt_8026fdc3.STL]
2012-05-26 URDF file is almost workable. Moving it over into the ros repo to finish the job.
    [abby.urdf]
2012-05-30 Converted all Inventor models to meters and reexported xml.
    [Breaker.iam, IRB120_Base_rev0.iam, IRB120_Link1_rev0.iam, IRB120_Link2_rev0.iam, IRB120_Link3_rev0.iam, IRB120_Link4_rev0.iam, IRB120_Link5_rev0.iam, IRB120_Link6_rev0.ipt]
2012-06-04 Created DIP adaptor board for XBEE.
    XBEE has 2mm spacing, so I created a small board to adapt it to
    a DIP20 so I can use it on a breadboard.
    [xBEE_dip.bottom.gbr, xBEE_dip.bottommask.gbr, xBEE_dip.fab.gbr, xBEE_dip.top.gbr, xBEE_dip.topmask.gbr, xBEE_dip.topsilk.gbr]
2012-06-04 Added footprints to the repository.
2012-06-05 Did some work on cRIO breakout, but it won't show in PCB.
    Pushing this to try on the laptop...
    [breakout.pcb, breakout.sch]
2012-06-07 Updated PCB footprint for XBEE.
    It now has 2mm spacing and the proper outline silk.
2012-06-07 Finally have a working pcb file for the breakout. Now I just have to do the layout.
    [breakout.pcb, breakout.sch]
2012-06-07 Finished layout on the cRIO breakout.
    [breakout.pcb, breakout.sch]
2012-06-07 Made some tweaks to the breakout board.
    [breakout.pcb]
2012-06-07 I think the layout for the estop board is done.
    [estop.pcb, estop.sch]
2012-06-07 I think I've got layout done for the remote.
    [remote.pcb, remote.sch]
2012-06-07 Cleaning up a bit.
    [estop.new.pcb]
2012-06-08 Updated estop to use a 025 thruhole resistor for IRC5 in.
    Don't have 0603 resistor in the right size, and it probably
    wouldn't be able to handle the power requirements anyway.
    [estop.pcb, estop.sch]
2012-06-08 Files for breakout as submitted to FreeDFM.
    Generated gerber and cnc files. Combined cnc files into a single
    file instead of having separate plated and unplated cnc files.
    Put all generated files into a zip file and submitted.
    [breakout.pcb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]
2012-06-08 estop files, as submitted to freedfm.
    [estop.back.gbr, estop.backmask.gbr, estop.backpaste.gbr, estop.backsilk.gbr, estop.bottom.gbr, estop.bottommask.gbr, estop.fab.gbr, estop.front.gbr]
2012-06-12 Finished up breakout. I hope.
    [breakout.pcb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]
2012-06-12 Finished estop (I hope).
    [estop.pcb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]
2012-06-12 Finished estop remote (I hope).
    [remote.pcb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]
2012-06-12 Combined PCBs into one and gen'd files.
    Made some minor soldermask corrections.
    [combined.pcb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]
2012-06-12 Forgot to save combined PCB...messed up the amend. Here we are...
    [combined.pcb]
2012-06-21 Updated CAD files with new inverter and regen'd Simmechanics files.
    [2kW inverter.ipt, base plate.iam, battery rails_ipt_62ca575f.STL, battery_ipt_8c19ab2.STL, caster assy_iam_cc1e69ad.STL, frame_ipt_29593391.STL, motor_MIR_ipt_80c03f9e.STL, motor_ipt_8185475f.STL]
2012-06-21 Broke out caster wheels.
    Made the caster assemblies flexible and regen'd SimMechanics files.
    This should allow the wheels to turn independently. Also deleted old
    urdf file.
    [abby.urdf, caster wheel_ipt_4784d7d8.STL, caster_ipt_ca03a3d7.STL, frame assy.iam, invacare assy.iam, robot.iam, timeline.xlsx]
2012-06-22 Install script should work properly for fuerte now
    Added audio_common package, changed a couple other commands.
    Note that it's currently pulling the Lucid package because I'm
    installing on one of the mac mini's. Also, don't forget to change
    the user dir to the correct one.
2012-06-22 Added arm navigation to list of ROS packages to install.
2012-06-22 Some progress on ros relay RAPID module.
2012-06-25 Created PDF of breakout schematic.
2012-07-02 Fixed two errors in cRIO breakout.
    cRIO breakout had Left and Right encoder Refdes swapped and
    the pullup for the switch was all wrong. Fixed these in
    schematic. Will need layout update for pullup. (Not done yet.)
    [breakout.sch]
2012-07-09 Updated CAD files.
    Added some files that weren't previously in the repo (breaker) and some
    modified files that were never updated in the repo (Spike relay, compressor,
    cRIO).
    Modeled the gripper and designed adapter plates to mount the gripper to the
    IRB-120. Added a door knob in the new Objects directory.
    [1x3 Header Connector.ipt, Breaker Body.ipt, Breaker Post.ipt, Breaker.iam, IRB120 plate.ipt, LED - Green.ipt, Spike Bottom Cover.ipt, Spike Female Terminal.ipt]
2012-07-10 Updated remote schematic (not finished) and added e-stop relay pdf.
    [remote.sch]
2012-07-13 Updated footprints and symbols.
    Still need to make TO220 pad square. Also need to update all layouts.
2012-07-17 Shut off line endings on desktop.
    [EIO.cfg, IRC5_Compact.stp, LMS291-S05_S14-S052389.stp, MMC.cfg, MOC.cfg, PROC.cfg, SIO.cfg, SYS.cfg]
2012-07-18 Gripper drawings.
    Made fabrication drawings for all gripper parts. Still need to add
    material notes, review, and generate PDFs.
    [IRB120 plate.idw, gripper jaw extension.idw, gripper plate.idw, gripper.iam]
2012-07-23 Updated remote schematic.
    Added power LED.
    Added reset button.
    Added power flush on power switch.
    [remote.sch]
2012-07-30 Added a note to Bill Kulp's thesis; drawing updates.
    [IRB120 plate.idw, gripper jaw extension.idw, gripper plate.idw]
2012-07-30 Added example RRI files and updated Sabertooth script.
    Russell gave me the RRI config files and code that they've been
    using down in 109.
    This commit also includes some minor changes to the sabertooth
    python script. The script now goes through a test sequence:
    Motor 1 full forward for 2 seconds
    Motor 1 full reverse for 2 seconds
    Motor 1 off.
    Motor 2 full forward for 2 seconds
    Motor 2 full reverse for 2 seconds
    Motor 2 off.
    [GAtypes.h, Object1.h, abb2.h, cbundle.h, portable.h, reporter.h]
2012-08-06 Created a manufactuing layout for gripper parts.
    Made a layout of all of the gripper parts for Arkady to machine. Also
    filleted corners of the gripper jaws.
    [gripper jaw extension.ipt, gripper manufacturing layout.iam, gripper manufacturing layout.igs]
2012-08-09 Simplified STLs for gazebo
    In order to cut down on collision calculations in Gazebo, I've generated
    two new sets of SimMechanics/STL files. Both sets are in my masters git
    repository, in the urdf/ directory.
    fixed_frame combines all of the aluminum frame members into a single
    solid. Since they're all aluminum, they all have uniform density, so
    there's absolutely no reason not to combine them.
    all_fixed combines all of the fixed elements on the robot into one. I'm
    not sure if inertial properties are accurately calculated or if inertial
    properties are calculated based on mean density. In the latter case,
    this simulation will be less accurate.
    Also, the arm height is still not final.
    [Breaker_iam_746c8f85.STL, IRB120_Base_rev0_iam_38446303.STL, IRB120_Link1_rev0_iam_3fe6e7e5.STL, IRB120_Link2_rev0_iam_90725b7e.STL, IRB120_Link3_rev0_iam_86ced70a.STL, IRB120_Link4_rev0_iam_467bed4b.STL, IRB120_Link5_rev0_iam_8f44ede8.STL, IRB120_Link6_rev0_ipt_8026fdc3.STL]
2012-08-09 Forgot to break out casters in the all_fixed STLs.
    [caster wheel_ipt_4784d7d8.STL, caster_ipt_ca03a3d7.STL, fixed_robot.iam, frame_solid.iam, robot_solid.iam]
2012-08-17 Added two new references and notes for PCB revisions.
2012-08-19 Kinect standoff CAD files.
    Added Kinect standoff CAD files (based on Willow Garage TurleBot
    standoffs).
    [kinect standoff.ipt]
2012-08-19 Added backup of IRC5 on 2012-08-02
    Backed up IRC5 in order to rebuild the system in an attempt to get RRI
    working.
    [EIO.cfg, MMC.cfg, MOC.cfg, PROC.cfg, SIO.cfg, SYS.cfg]
2012-08-19 Created task list.
    Created a definitive list of tasks still to be done.
    [tasks.xlsx]
2012-08-20 Added formatting to tasks spreadsheet.
    MS Projects doesn't like doing spreadsheet imports very well, so
    I'm just using the spreadsheet. I added color coding to make it more
    useful.
    [tasks.xlsx]
2012-08-20 Added new tasks and deleted old task files.
    [tasks.xlsx]
2012-08-29 Added rapid modules for choreographed movement/ROS.
    Choreo raises and lowers the arm. It was created for the Ford demo
    videos.
    Main module is just a switch to run choreo or ros_relay.
    Ros_relay is currently just a tcp hello world.
    State_server is the beginning of the server for sending robot state
    data to ROS industrial.
2012-09-04 Updated RAPID state server.
    Includes packet header info, but still need to check comm type and reply
    code. Also still need to add joint status.
2012-09-04 Described the joint status packet.
2012-09-04 Added joint messages to state server.
    Joint positions are now sent out by the state server.
2012-09-05 Described joint trajectory pt packet.
2012-09-05 Joint trajectory server done (probably).
    Joint trajectory server now has a callback to create trajectories.
    Moved some global definitions and variables into ROS_config.
    Ready for test (Oh God, oh man).
2012-09-11 Fixed joint angles in state server RAPID.
    [tasks.xlsx]
2012-09-21 Started a document describing the ROS driver.
2012-10-01 Oh hey, the RAPID driver actually works now.
2012-10-26 Added a new set of simmechanics files with no arm.
    New CAD file and simmechanics files with no arm and more clear
    link names. This should make it easier to generate a URDF.
    [Breaker_iam_746c8f85.stl, IRC5_Compact_ipt_c844072c.stl, PC_ipt_a7ade237.stl, SICK LMS291_ipt_2ad4e53c.stl, Spike H_iam_f19c9874.stl, al_frame_iam_3826baa4.stl, back frame plate_ipt_475e4947.stl, caster wheel_ipt_4784d7d8.stl]
2012-10-28 Updated fixed fram no-arm CAD files and simmechanics files.
    Broke out the wheels and casters in the base model instead of
    using a sub-assembly because the simmechanics file generated
    would create a messed-up URDF in which there was one caster with
    two links to it from the base.
    Base now has caster and caster wheel as parts in it instead of a
    sub-assy.
    [invacare assy.iam, robot_no_arm.iam]
2012-10-28 Abby's URDF is looking pretty good.
    This URDF looks good in the graph visualizer (no arm). I need to
    change the joint defs for the casters and wheels so they can turn
    and will probably need to make some tweaks when I load this in rviz
    and gazebo. Then I'll need to add the arm w/ the xacro macro.
    [abby.urdf]
2012-11-02 Updated files for no arm urdf generation and removed generated urdf.
2012-11-02 Cleaned up more urdf and yaml files.
    [abby.urdf]
2012-11-05 Updated some CAD files.
    [invacare assy.iam]
2012-11-05 Kinect bracket designs.
    [Kinect.ipt, acrylic kinect bracket - bracket.ipt, acrylic kinect bracket - kinect plate.ipt, acrylic kinect bracket - manufacturing.dxf, acrylic kinect bracket - manufacturing.iam, acrylic kinect bracket - manufacturing.idw, acrylic kinect bracket 2.iam, acrylic kinect bracket.iam]
2012-11-05 Updated CAD files.
    [gripper jaw.iam, robot.iam, tasks.xlsx]
2012-11-30 Added gripper and bin.
    Changed gripper plate thickness to reflect wooden prototype pieces and
    removed gripper jaw extensions. Generated gripper simmechanics files.
    Created bin and regenerated robot simmechanic file and STLs to include
    bin.
    [IRB120 plate.ipt, bin.ipt, bin_ipt_175fe0bc.STL, gripper jaw_ipt_2c7c957b.STL, gripper plate.ipt, gripper with jaws.iam, gripper.iam, gripper_iam_ad0c01b6.STL]
2012-11-30 Added festo solenoid valve datasheet to references.
2012-12-03 Renamed CAD to Mechanical and PCB to Electronics.
    Also created block diagrams of the power and data connections and
    created a schematic of the gripper solenoid/arduino setup.
    [12v terminal.ipt, 1x3 Header Connector.ipt, 24v terminal.ipt, 2kW inverter.ipt, 3HAB3409-207.ipt, 3HAC022117-002.ipt, 3HAC023624-002.ipt, 3HAC030650-001.iam]
2012-12-03 Added spike and sick lidar datasheets to reference.
2012-12-06 Added scope trace for large inductor LC filter to figures.
2012-12-06 Added 13.8v rail dropout scope traces to figures.
2012-12-06 Added gripper urdf generation files.
    [gripper.urdf]
2013-01-08 Created schematic postscript files for block diagrams.
    PS files located in figures.
    [gripper.sch]
2013-01-09 Changed schematics to white backaground.
2013-01-09 Added bin to robot.iam and removed gripper jaws.
    [gripper jaw.iam, robot.iam]
2013-01-09 Created overview mechanical drawing.
    [robot.idw]
2013-01-09 Created PDFs of schematics.
2013-01-09 Added missing pages to robot overview.
    [fixed_robot.iam]
2013-01-23 Created files for acrylic gripper plates.
    [IRB120 plate assy.iam, acrylic IRB120 plate 2.ipt, acrylic IRB120 plate.ipt, acrylic gripper manufacturing layout.ipt, acrylic gripper plate 2.ipt, acrylic gripper plate assy.iam, acrylic gripper plate.ipt, gripper manufacturing layout.dxf]
2013-01-25 Updated gripper to use acrylic plates.
    [acrylic IRB120 plate 2.ipt, acrylic IRB120 plate.ipt, acrylic gripper plate 2.ipt, acrylic gripper plate.ipt, acrylic_gripper_iam.stl, gripper.iam]
2013-01-25 Added battery discharge times.
2013-01-25 Added new STLs for gripper and kinect bracket.
    [acrylic kinect bracket_iam_e501fe13.STL, gripper_iam_ad0c01b6.STL]
2013-03-03 Added some documents.
    Added localization paper/chapter.
    Added electrical schematics docs.
    Added battery voltage discharge curves.
2013-03-11 Edits to IRB120_Base_rev0.iam
    Not sure what I changed. It was sitting on my desktop, last changed on
    2013-03-03
    [IRB120_Base_rev0.iam]
2013-03-14 Cleaned up estop schematics.
    Cleaned up first revision estop schematics and made eps figures.
    [estop.sch, remote.sch]
2013-03-14 Made a schematic of the estop circuit on HARLIE (needs check).
    [HARLIE E-stop.sch]
2013-03-18 Localization data for circle driving test.
    [circle localization test.xlsx]
2013-03-18 Miscellaneous uncommited STLs from laptop.
    [al_frame_iam_3826baa4.STL, bin_ipt_175fe0bc.STL, frame_solid_iam_8d469021.STL, gripper jaw_iam_c4751bb6.STL]
2013-03-18 Kinect frame solver mathematica notebook.:
2013-03-19 Started Experimental Software Section.
    Added MObile base planning/localization section and QR section.
    Still Todo:
    * Kinect calibration
    * Kinect data filtering
    * Tabletop box recognition
    * Ik solvers
    * Arm nav
2013-03-21 Added a script to calculate the pose of the arm relative to the kinect.
2013-03-24 Added list of ik iterations for successul tests.
    [ikiters.csv]
2013-03-25 Still questing for a good arm->kinect tf.
2013-03-25 Added straight line localization data to repo.
    [localization trials.xlsx]
2013-03-25 Added localization data to thesis.
    [localization trials.xlsx]
2013-03-25 Added figures and stats to thesis.
    Added last two figures.
    Added encoder resolution.
    Added amcl timing.
2013-03-26 All over but the crying.
    First draft thesis is done, minus that pesky data.
    * Wrote conclusions/future work
    TODO:
    * Battery w/ arm
    * Validation task results
2013-04-01 Used ALL THE POINTS for arm alignment.
2013-04-03 Added BoM to thesis.
    Need to double check IRC5/IRB-120 cost.
2013-04-11 Trials spreadsheet.
    [trials.xlsx]
2013-04-11 Battery discharge test.
2013-04-13 Final (?) Kinect/arm alignment.
2013-04-13 Another rev of the thesis in progress.
    * Moved revised e-stop to appendix.
    * Reorganized/rewrote validation section to have sections for
    navigation and manipulation validation as well as overall
    validation.
    * Moved odometry tests to results section.
    * Added most of the navigation trials to results section.
    Still to do:
    * Add one more trial of navigation from the right side.
    * Add 16 trials of manipulation and write about them.
    * Widows and orphans and other formatting stuff.
2013-04-17 Thesis revision 8.
    Mostly readability, some organization. Updated some schematic figures.
    This may be final draft. I'm waiting on the last of the r7 feedback.
2013-04-24 Compressed images in powerpoint.
2015-07-20 Fixes errors in odometry algorithm.
    These were almost certainly introduced when I converted from MS Word to LaTeX. PDF has not been regenerated to reflect the changes.
2015-09-03 Adds missing figure PNGs and updates PDF w/ fixed odometry algorithm.
